martinroger/VXDash/CAD files/Stack rectified.png

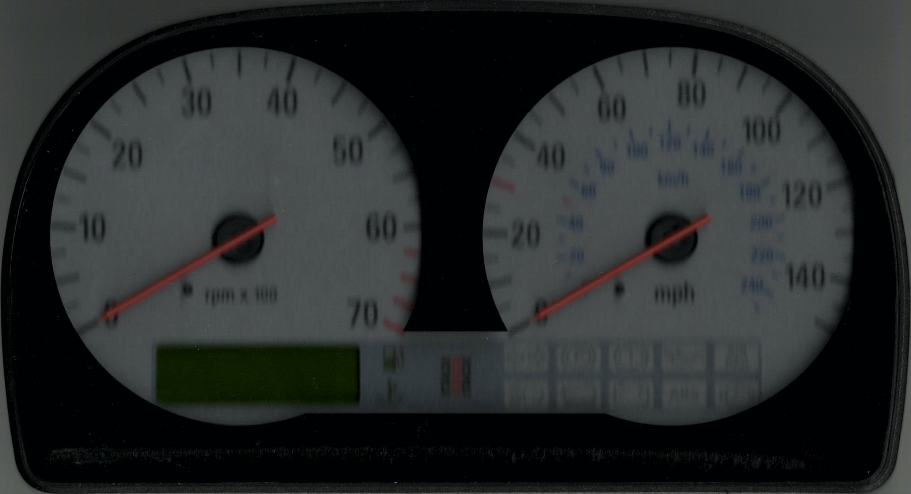
CAD files/Stack rectified.png
