martinroger/VXDash/img/Control assy (1).png

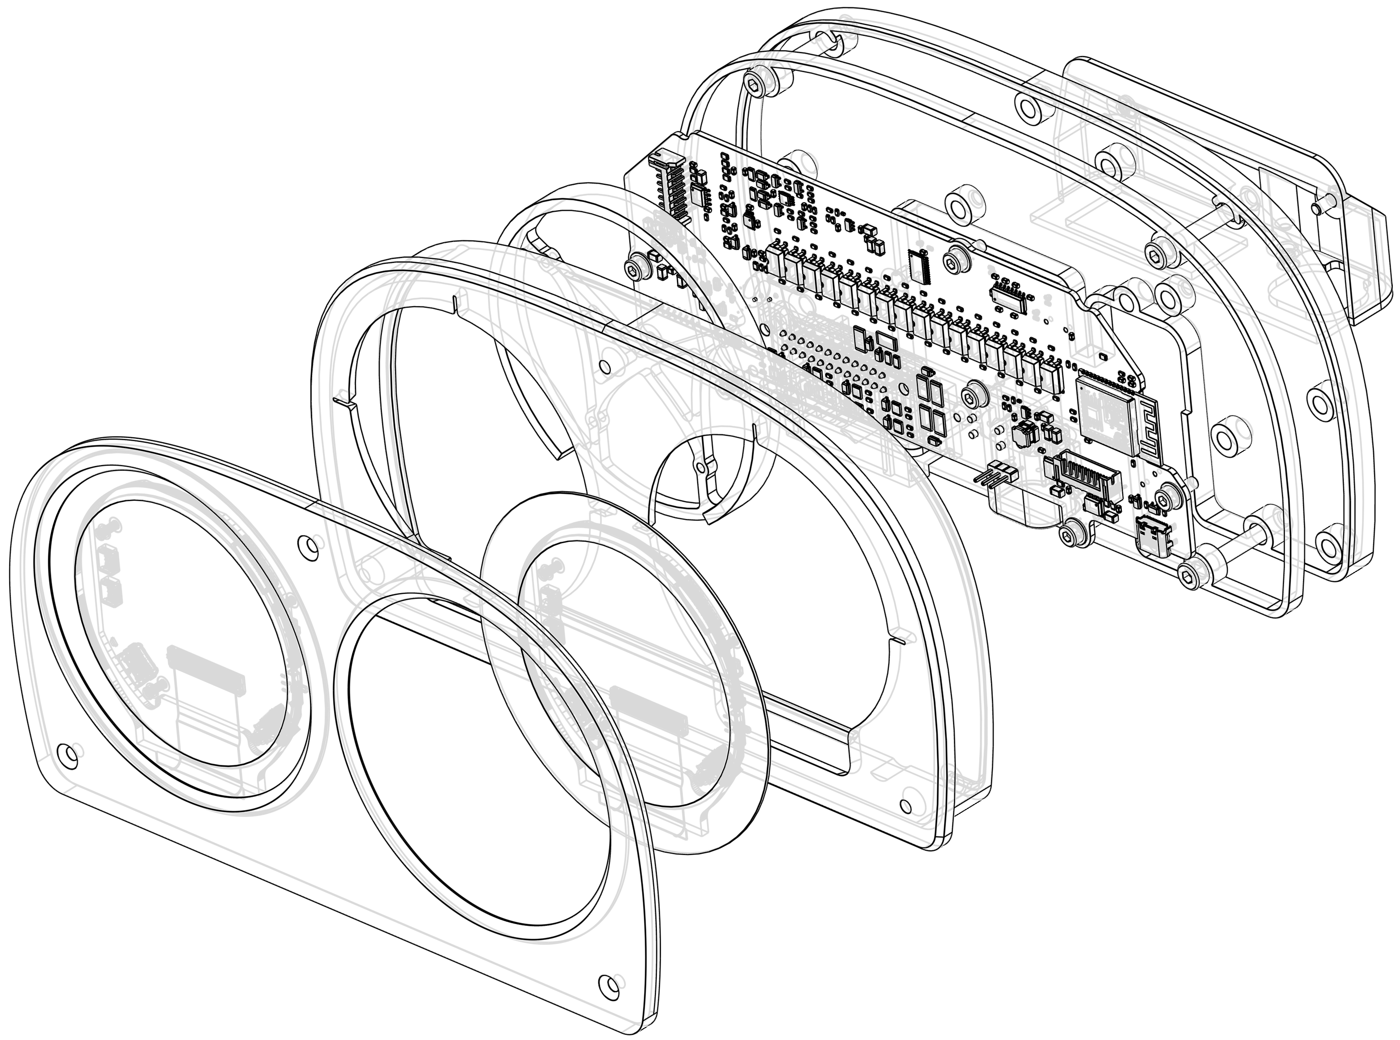
img/Control assy (1).png
