martinroger/VXDash/KiCad PCB Files/Simulations/AnalogR_sensor circuit v2/AS2333.JPG

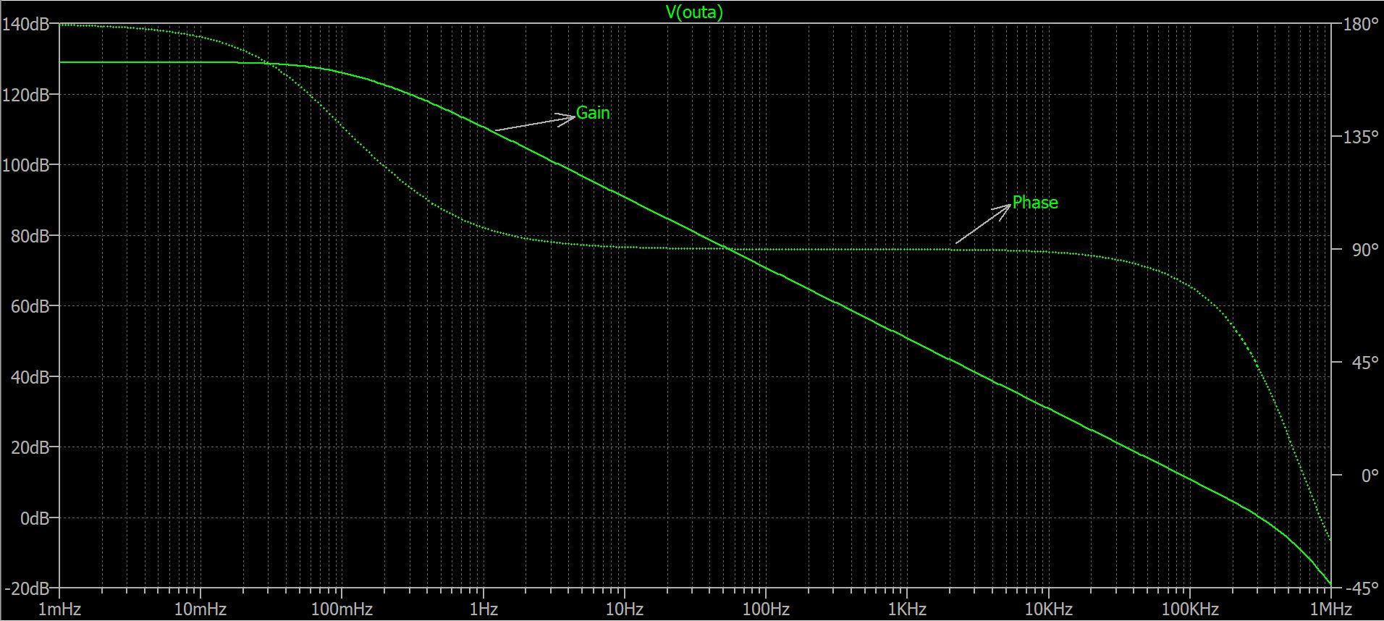
KiCad PCB Files/Simulations/AnalogR_sensor circuit v2/AS2333.JPG
