martinroger/VXDash/KiCad PCB Files/VXDash/VXDash_intermediate.step

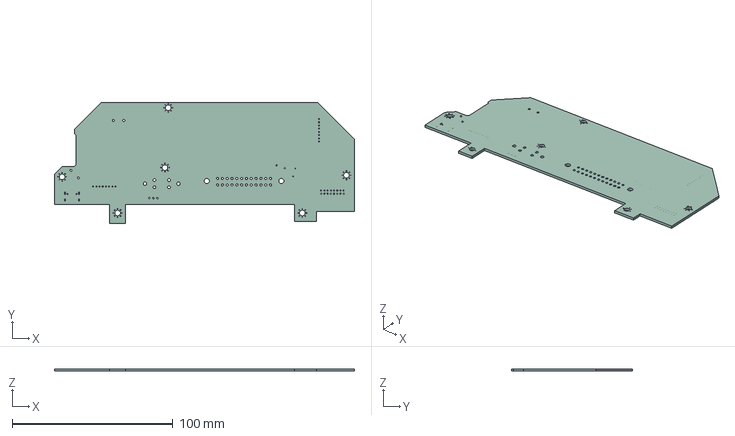
[picture p7: CAD file, 2026-01-08]
KiCad PCB Files/VXDash/VXDash_intermediate.step
186.8 x 75.2 x 1.51 mm
