martinroger/VXDash/KiCad PCB Files/VXDash_Connectors/VXDash_Connectors.step

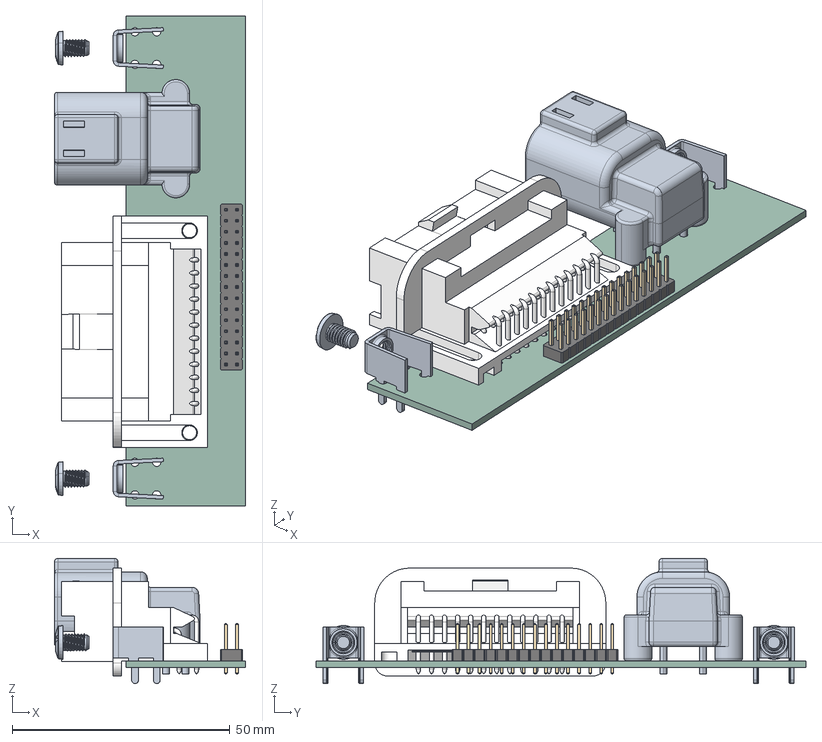
[picture p8: CAD file, 2025-09-24]
KiCad PCB Files/VXDash_Connectors/VXDash_Connectors.step
43.9 x 112.5 x 28.7 mm
PinHeader_2x15_P2.54mm_Vertical
DTF13-4P
12092886_PART1
VXDash_Connectors_PCB
