martinroger/VXDash/KiCad PCB Files/VXDash_Emulator_lite/VXDash_Emulator.step

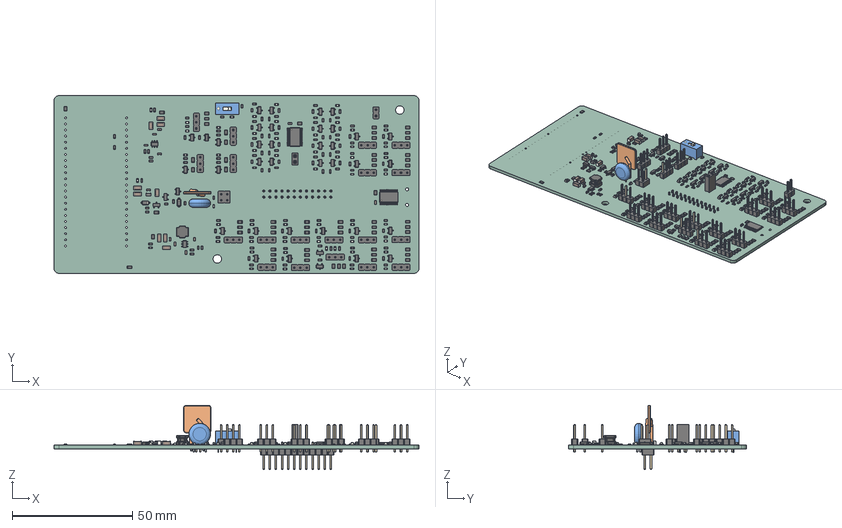
[picture p9: CAD file, 2026-09-08]
KiCad PCB Files/VXDash_Emulator_lite/VXDash_Emulator.step
152.0 x 74.0 x 26.7 mm
R_0603_1608Metric x 123
LED_0603_1608Metric x 56
R_0805_2012Metric x 61
C_1206_3216Metric x 9
SOT-23 x 40
C_0603_1608Metric x 13
PinHeader_1x03_P2.54mm_Vertical x 19
Fuse_BelFuse_0ZRE_0ZRE0033FF_L11.4mm_W3.8mm
TSSOP-24_4.4x7.8mm_P0.65mm x 2
L_0805_2012Metric
PinHeader_2x02_P2.54mm_Vertical
TSOT-23-6 x 2
D_SOD-123 x 2
SW_DIP_SPSTx01_Slide_9.78x4.72mm_W7.62mm_P2.54mm
PinSocket_1x02_P2.54mm_Vertical
RV_Disc_D9mm_W3.5mm_P5mm
PinHeader_1x02_P2.54mm_Vertical
Ind_5050_Pulse_BWVS005050404R7M00
PinHeader_2x12_P2.54mm_Vertical
VXDash_Emulator_PCB
