martinroger/VXDash/KiCad PCB Files/VXDash_MinBuild/Interface board PCB envelope - PCB outline.dxf

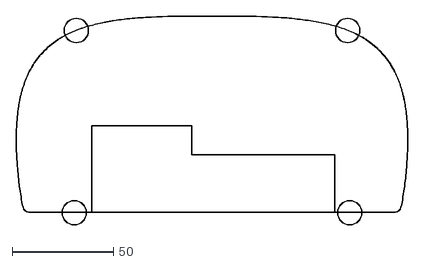
[picture p10: CAD file, 2025-08-14]
KiCad PCB Files/VXDash_MinBuild/Interface board PCB envelope - PCB outline.dxf
193.3 x 103.1
