martinroger/VXDash/CAD files/FDM Enclosure for v0.2.step

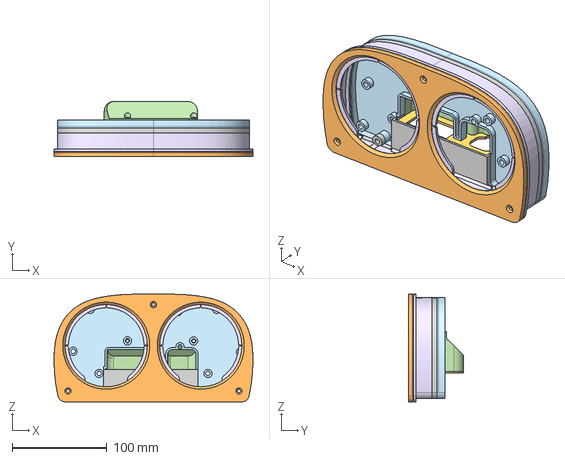
[picture p11: CAD file, 2026-01-11]
CAD files/FDM Enclosure for v0.2.step
210.5 x 58.1 x 114.0 mm
