martinroger/VXDash/CAD files/Original cluster.step

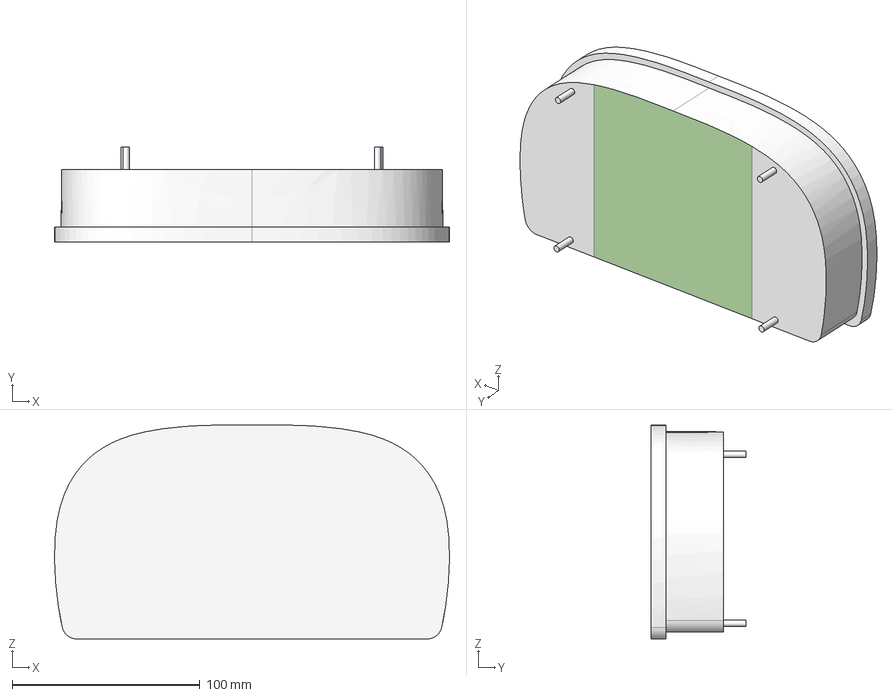
[picture p12: CAD file, 2026-01-08]
CAD files/Original cluster.step
210.5 x 50.5 x 114.0 mm
