martinroger/VXDash/CAD files/Annotated BackFace DXF.dxf

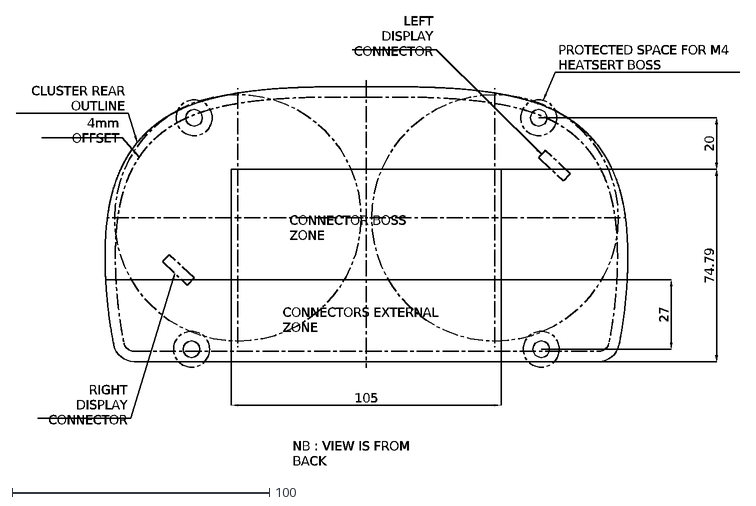
[picture p13: CAD file, 2026-01-08]
CAD files/Annotated BackFace DXF.dxf
CONNECTOR BOSS ZONE
CONNECTORS EXTERNAL ZONE
CLUSTER REAR OUTLINE
4mm OFFSET
PROTECTED SPACE FOR M4 HEATSERT BOSS
27
105
74.79
20
RIGHT DISPLAY CONNECTOR
LEFT DISPLAY CONNECTOR
NB : VIEW IS FROM BACK
