martinroger/VXDash/CAD files/Spider clamp approach - PCB outline.dxf

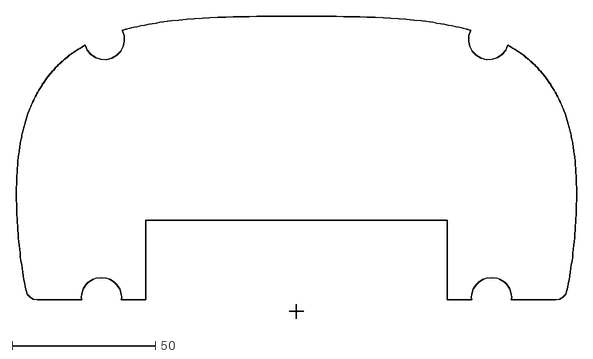
[picture p14: CAD file, 2026-01-08]
CAD files/Spider clamp approach - PCB outline.dxf
195.3 x 105.4
