martinroger/VXDash/CAD files/VXDash_intermediate - Filleted PCB Outline.dxf

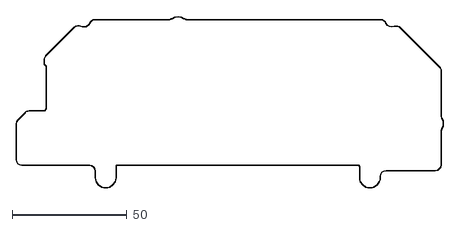
[picture p15: CAD file, 2026-01-08]
CAD files/VXDash_intermediate - Filleted PCB Outline.dxf
186.2 x 74.8
