martinroger/VXDash/CAD files/VXDash_intermediate - New PCB outline.dxf

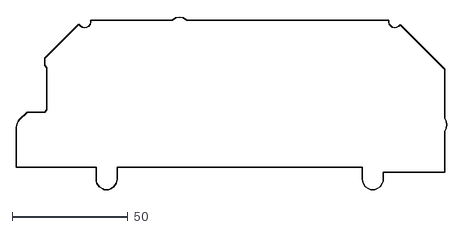
[picture p16: CAD file, 2026-01-08]
CAD files/VXDash_intermediate - New PCB outline.dxf
186.3 x 74.9
