martinroger/VXDash/CAD files/VXDash PCB Area.dxf

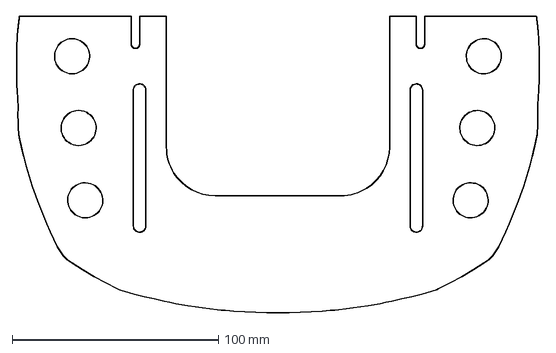
[picture p17: CAD file, 2026-01-08]
CAD files/VXDash PCB Area.dxf
253.6 x 144.0 mm
