martinroger/VXDash/CAD files/VXDash viewable Area.dxf

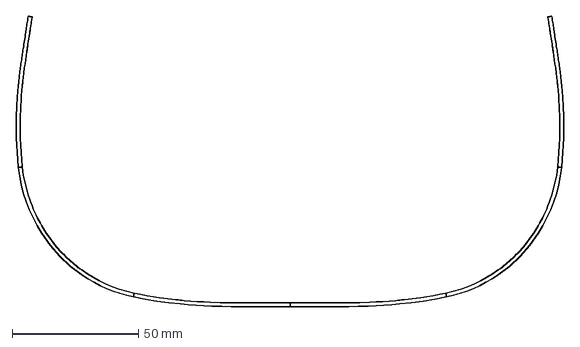
[picture p18: CAD file, 2026-01-08]
CAD files/VXDash viewable Area.dxf
217.3 x 115.3 mm
