martinroger/VXDash/(threads)

Thread 2 (2023-04-17):

Missing 3V3 backfeed protection when flashing ESP32

martinroger, 2023-04-17:

Thread 10 (2023-04-18):

CAD up enclosure

martinroger, 2023-04-18:
- [ ] Variant with minimal impact on existing Cowl (measure lip overlap)
- [ ] Version with modified cowl
- [ ] Check lower edge coverage (approx 10mm)
- [ ] 3D print test block

martinroger, 2025-07-16:
Moving to original fit envelope. Closing.

Thread 6 (2023-04-18):

Check coolant temperature signal characteristics

martinroger, 2023-04-18:
- [x] Is it powered ?
- [x] Is it a 100Hz PWM ?
- [x] Does it have chocolate inside ?

martinroger, 2023-04-24:
Powered at +VBATT but is normally taken down to 5V by the instrument panel.
100Hz PWM, measurement table available in spreadsheet
Chocolate not found

Closed 2023-04-24.

Thread 7 (2023-04-18):

Create test board

martinroger, 2023-04-18:
Has to integrate :

- [x] 4050 buffer circuit
- [x] Multiplexer circuit
- [x] Singled out Coolant temperature test point
- [x] Singled out Fuel level sender test point
- [x] RPM direct connection point
- [x] Speed direct connection point
- [x] 12V -> 5V conversion circuit
- [x] 12V -> 3V3 conversion circuit
- [x] 1 5V detection circuit for 5V sensors
- [x] 1 12V protection circuit
- [x] 1 JAE connector with identical pinout as final

Closed 2023-06-02.

Thread 9 (2023-04-18):

Source SMD soldering tools

martinroger, 2023-04-18:
- [x] ESD tweezers
- [x] Solder paste
- [x] Reflow plate/oven (T962?)
- [x] TS101
- [x] 3D print pasting rig
- [x] Digital magnifier

Closed 2024-10-05.

Thread 13 (2023-04-20):

Find a better way to manage custom parts

martinroger, 2023-04-20:
Currently custom parts and footprints mostly managed through... well they are not managed. Attempts were made to add a submodule but this is a bit too convoluted to maintain new updates. Add a project sub-folder and point Samacsys' Kicad Library app to it.

Any suggestions welcome.

Alex-XNR, 2023-04-20:
I've typically worked with custom libraries in a separate repository. Each user would have their own working branch but would regularly update from/merge into main while checking for conflicts (i.e. not removing or reversing other users work).

Any parts that are added, or any included KiCad parts that need modifying, are copied into this library so that everyone has the same library parts. Also, when KiCad is updated, any included library modifications you've made will likely be removed...

Folder structure something like this:
KiCad Library
   ->3D Models
   ->Symbols
   ->Footprints

martinroger, 2023-04-20:
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

How would you refer the library repository to the main project library in Kicad ? Just configuring it as an additional library in Kicad (as opposed to a Project library) ?
I could/should set that up for sure.

Alex-XNR, 2023-04-21:
Yes exactly right, they would get added as global libraries, then for any future projects you're set up ready to go ;). For example, I have a custom symbol library for passives, transistors, ICs, etc,. But that's only my personal preference

martinroger, 2023-04-21:
> Yes exactly right, they would get added as global libraries, then for any future projects you're set up ready to go ;). For example, I have a custom symbol library for passives, transistors, ICs, etc,. But that's only my personal preference

Right, I'll try and set up that next then !

Closed 2023-04-24.

Thread 16 (2023-04-24):

Relocate Water Temperature information to the 4050 CMOS buffer

martinroger, 2023-04-24:
Turns out it is a 100Hz 12V PWM, so it is simpler to run it through the 4050 CMOS buffer

martinroger, 2023-04-24:
Done as of #15

Closed 2023-04-24.

Thread 17 (2023-04-24):

Remove series capacitors on PS1 input

Alex-XNR, 2023-04-24:
Series capacitors isn't advisable. 2x 22uF 16V on the input should do fine

martinroger, 2023-04-24:
Resolved in #19

Closed 2023-04-24.

Thread 18 (2023-04-24):

Add load disconnect for power input overvoltage

Alex-XNR, 2023-04-24:
For added robustness, it might be worth adding a feature to disconnect the power input circuit if the voltage goes too high.

Thread 22 (2023-04-25):

Improve ground thermal relief and stitching

Alex-XNR, 2023-04-25:
It's advisable to have thermal relief on any pad that connects to a large ground plane. It might cause difficulty when soldering if they are a solid connection.

Include ground vias at regular intervals around the ground plane and at any signal later changes to keep the ground potential as uniform as possible on the PCB.

martinroger, 2023-04-25:
I usually make sure that the PTH pads have thermal reliefs, is that also something that should be done for SMD pads ?

Alex-XNR, 2023-04-25:
I would recommend it. If hand soldering parts you'll need to put in more heat if using solid connections, which will risk damaging components.

martinroger, 2023-04-25:
I was actually thinking of breaking the bank and getting one of those chinese reflow oven or a 200mmx200mm hot plate. Arguably I put some really tiny SMD components (like the chips for the power supply stages). Would thermal reliefs help at all in those cases ?
Just a bit worried on the compromise of good grounding vs thermal reliefs on most large SMD ground pads.

Thread 23 (2023-04-25):

Implement constant current source for Resistive sensor

martinroger, 2023-04-25:
- For sensors in the usual range (0-250Ohm) : max 13.2mA
- For sensors in the mid range (0-500Ohm) : max 6.6mA (use high-K voltage divider and allow 0-5V instead ?)
- For sensors in the high range (0-2K5) : allow 0-5V but imperatively use a 5V -> 3.3V divider with high values for the divider ? Still 2mA max

- Look into high-side current sources possibly based on Op-Amps ?
- Found some stuff on low A LED drivers like NCR401U, worth it or can still be bettered ?

martinroger, 2023-04-30:
Alright, so progressing this a little bit with commit 0abb7f7 :
- I added a hierarchical sheet in the schematics using the LM358BA dual op amp (because it already has Rf and Ri integrated)
- There is a reference 4.096V fed to the op-amp by a LM4040-4.1 "Zener"
- Rsense is set in this implementation to 220Ohm to give a theoretical supply of 4.1mA, which accounting for most of the voltage drops here and there means that the maximum readable sensor resistance Rload of approximately 800Ohm. Practically it may be more but it starts to be really out there in various saturation zones

A concern remains on the quality of the 5V supply, as the "constant" current is almost more dependant on fluctuations on the 5V than anything else.
Also the protection Schottky has to be rethought, because its Vf will remain an unknown (even if at those low amps it might be relatively stable, even against temperature variations ). A 3.3V Zener  to GND instead ?

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

Alex-XNR, 2023-05-23:
Minor changes to the OpAmp design:
- Reference divider added to help with potential 5V supply variation.
- Current set voltage reduced to 100mV to increase measurement headroom.
- MOSFETs used instead of BJT so the base current doesn't influence the constant current.
- Iset resistors moved outside of the hierarchical sheet.

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

Closed 2023-05-23.

Thread 25 (2023-05-16):

Tearing issue on the HMI using large linear gauges

martinroger, 2023-05-16:
At high refresh interval (~60ms) the use of large linear gauges leads to some amount of screen stuttering or tearing. There might be multiple factors at play :
- There are only 100 levels available for linear gauges, so the mapping function may introduce "fake" quantization levels that create a force-refresh even on identical value (on the receiving end of the screen). That may create some stuttering and tearing.
- The HMI stress app may be doing too much of a good job in those cases
- Having "perfect" numerical display of the RPM to the unit RPM is overkill. Steps of 25RPM or even 50-100RPM would reduce the update rate and therefore the panic of the screen
- Same applies for the gauge display of the RPM. 100 different levels (i.e. every 80RPM) is overkill. Steps every 250RPM would be more sensible (32 different levels then), or even every 200 RPM. That can be combined with variable color coding for corner-of-the-eye awareness

martinroger, 2024-11-04:
Drop linear bars from Nextion solution. No amount of tweaking or filtering helps.

Closed 2024-11-04.

Thread 27 (2023-05-16):

First pass of feature roll out in software

martinroger, 2023-05-16:
- [ ] Turn indicator handling
- [x] Telltales logic functions
- [ ] Physical interrupts with debouncing
- [x] Pulse counter
- [x] Use of Timer library instead of hardcoding it
- [x] Pulse emulator SW on the Nano
- [ ] Advise filters for the RPM and SPD counters
- [ ] Advise best quantization technique
- [ ] Interpolation map for complex sensors (separate header files for each)
- [ ] Speed integrator to distance (or long pulse counter ?)
- [ ] Dual core operation

martinroger, 2025-07-16:
Closed. Will get taken care off in the dedicated SW repo.

Closed 2025-07-16.

Thread 31 (2024-04-29):

Constant current LM358 sources are feeding too much current through Rset

martinroger, 2024-04-29:
I'm picking the project back up now that work is easing up a bit, on the Martin-dev branch.

When placing a 270Ohm load on one of the four AnalogR constant source circuits, I observe more current than expected through the load. I checked the circuitry and components position, all seems OK, however I see a larger than expected deltaV between IN1+ and IN1- . If I open-circuit, or nearly so, the Rload, the dV returns to about 100mV as expected.

I'm double-triple-checking the components I bought, soldering and everything, and sharpening up on LTSpice to see if the issue is not somewhere in my understanding of OP Amps and their limits, but @Alex-XNR if you have some insights it would be interesting to me.

Essentially with Rset at 22Ohm today it doesn't really read right above 250Ohm.
[Calibration reference.xlsx](https://github.com/martinroger/VXDash/files/15155680/Calibration.reference.xlsx)
Attached are some measurements. It is fairly uniform across all the 5 similar sensing channels, I haven't yet investigated the one with 51R Rset for higher impedance loads, but I expect a similar behaviour.

martinroger, 2024-04-30:
Tasks :

- [ ] Order AD8542 in MSOP and swap on the benchboard
- [ ] Update Schematic & PCB
- [ ] Change the VGPIO divider for something much larger. At higher Rsense there is a significant amount of current leaking through there (so 51k-27k instead of 5k1 2k7)
- [ ] Redo measurements and implement in code the compensation table

Alex-XNR, 2024-05-01:
Ahh, you are correct about the opamp common mode.
First thing you could try is bring the opamp into CM range. Set Vref on the non-inverting to 2.5V, recalc for the Rset (try 510R at 2.5V ~5mA). Should still be some headroom for upto ~400ohm.
For round two, like you suggest, use a rail-to-rail opamp with full suppy CM range.

martinroger, 2024-05-02:
Yeah, what I will do is probably a resoldering exercise on the bench board directly for the OpAmp, turns out I have gotten quite alright with the hot air gun thing ! In my later commits I added a bunch of LTSpice simulations with the various replacement Op-Amps, I guess in the end I will keep the 5V supply and 4.9V Vref, bulk up the voltage divider from 5V ->3.3V on the GPIO side to minimize stray currents going to ground and run like this. Definitely also looked at setting a larger dV and Rset pair to get the same current but further away from CM, unfortunately I don't have those as 0603 package available to solder right now !

martinroger, 2024-11-04:
Closed by #35

Closed 2024-11-04.

Thread 32 (2024-04-30):

Implement odometer and save to flash

martinroger, 2024-04-30:
Implement odometer function based on speed integration :

- [x] TRIP function
- [x] TRIP RESET via long press of button
- [x] Save to flash and Retrieve from flash (redundant with screen ?)

martinroger, 2024-11-04:
Closed with #35

Closed 2024-11-04.

Thread 33 (2024-10-05):

Possibly inverted P-MOSFET on Power switch stage ?

martinroger, 2024-10-05:
Hey @Alex-XNR , I was checking some things after dusting off the project a bit, and I noticed - just now - that actually the benchboard starts itself regardless of the ignition signal value. I dug up the schematic, and I think I found what is wrong but I might need to double check with you :

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

On there, shouldn't Q2 have D and S reversed ? And R65 and D10 should connect to Power_Fused on the left side ? When I simulate it, it seems to work but I thought I would double check with you before correcting that !

martinroger, 2024-10-06:
Candidate correction in 9ae1b542eb9109c802848487aa74be222306fe4f

Alex-XNR, 2024-10-10:
Hi @martinroger, yes looks like an error 🫣 As you've said, flip drain and source, keep D10 + R65 between G-S.

martinroger, 2024-10-10:
@Alex-XNR Imagine my face when I finally wondered why it was starting without me setting the ignition pin on...

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

Some like this looks OK to you ?

martinroger, 2024-11-04:
Closed by #35

Closed 2024-11-04.

Thread 43 (2025-09-26):

EMULATOR  - Board corrections TODOS

martinroger, 2025-09-26:
### Schematic

- [ ] Revise the values of the resistors for the fuel level sender simulator : on the lower values the drop from N = 1 (270Ohm) to N = 2 (135Ohm) is a bit too steep ? Need to see if this can be mitigated by using the 2k resistors to create intermediate steps (table needed)
- [ ] Ignition is actual source for the active lows on the original cluster. Switching via 2N7002 isn't going to cut it in terms of current throughput -> update to a larger FET or a different architecture
- [ ] BUTTON override is wired to the wrong potential in the schematic. It's an active low but the FET stages are inverting : should be shorting to 3V3, not GND

### PCB (after schematic)

- [ ] Change footprint for development board to the one with the correct headers spacing (i.e. the more popular 25.4mm)
- [ ] Update layout according to schematic changes

martinroger, 2025-09-27:
Update to layout v0.2.0 in commit bbcdaed7052c1aac95e87e0b2f59203bacaf4e26 .

Still need to do the calculation table for the resistors.

martinroger, 2025-09-28:
Calculation table for more resistance steps in the resistance emulator in the 270 - 0 Ohm range :

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

Next step is to implement a level increase/decrease function in https://github.com/martinroger/vx-binocle-espidf
