martinroger/VXDash/KiCad PCB Files/Internal harness.kicad_sch.pdf

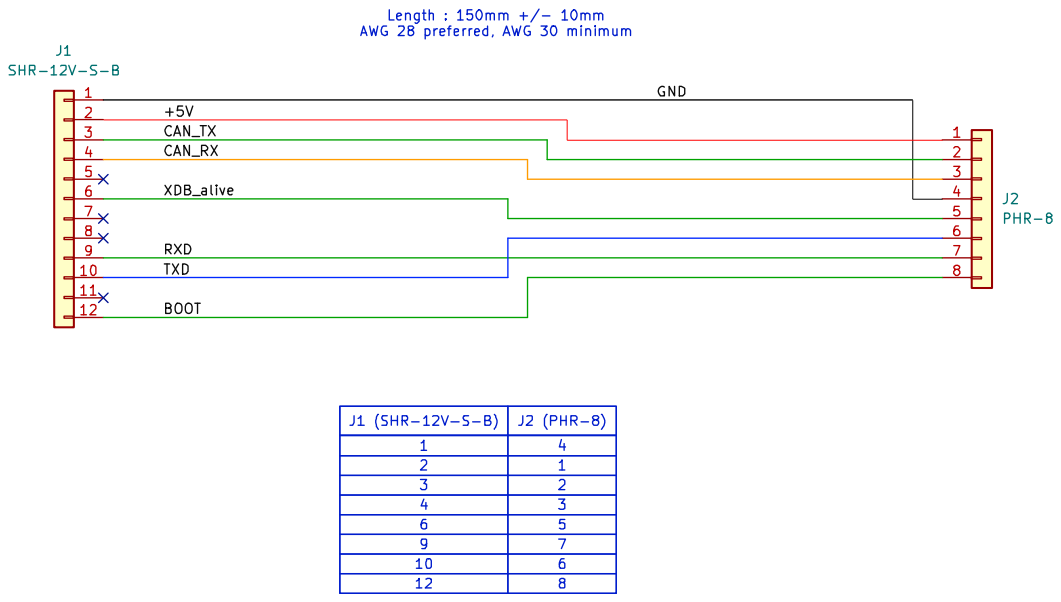
[picture p19: page 1]
