martinroger/VXDash/CAD files/Annotated BackFace DXF.pdf

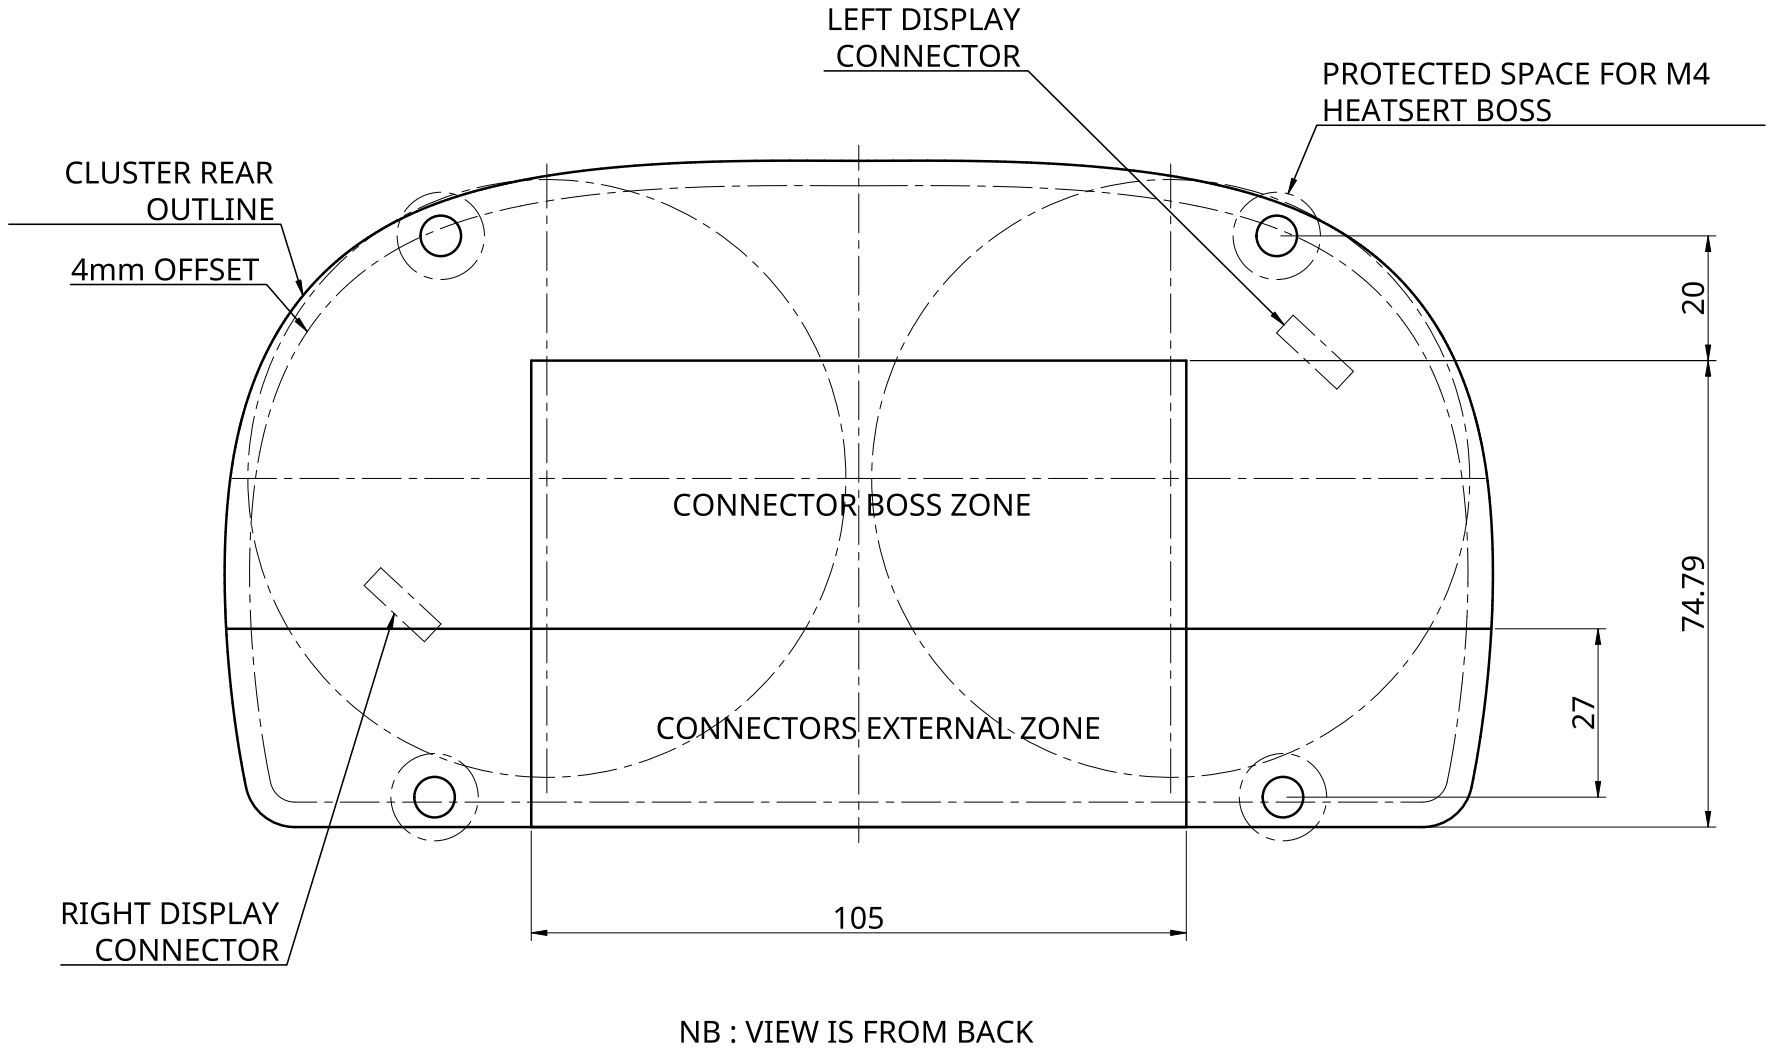
[picture p20: page 1]
