martinroger/VXDash/KiCad PCB Files/Simulations/Battery measure from prot 12V/Battery measure from prot 12V _ ac.asc

C1: cap; 10n; V=50
C2: cap; 100n; V=50V
D1: diode; DI_BZT52C18
R1: res; 100
R2: res; 1Meg
R3: res; 220k
R4: res; 1k
V1: voltage; 13.5; AC 1
Named nets: ADC, Battery, 0
.LIB BZT52C18.spice.txt
.noise V(adc) V1 dec 10 1 1000
.ac oct 10 1 1000
