martinroger/VXDash/KiCad PCB Files/Simulations/Battery measure from prot 12V/Battery measure from prot 12V.asc

C1: cap; 10n; V=50
C2: cap; 100n; V=50V
D1: diode; DI_BZT52C18
R1: res; 100
R2: res; 1Meg
R3: res; 220k
R4: res; 1k
V1: voltage; {Vbatt}
Named nets: ADC, Battery, 0
.LIB BZT52C18.spice.txt
.step param Vbatt 9 36 1
.op
