martinroger/VXDash/KiCad PCB Files/Simulations/Analog V Divider/AnalogVdivider_noise.asc

C1: cap; 100n; V=50
C2: cap; 10n; V=50
D1: schottky; BAT54
R1: res; 10
R2: res; 100k
R3: res; 150k
R4: res; 1k
V1: voltage; ""
V2: voltage; 3.3
Named nets: analog_out, analog_in, 0, 3v3
.ac dec 10 1 10k
.noise V(analog_out) V1 oct 10 1 16k
