martinroger/VXDash/KiCad PCB Files/Simulations/Analog V Divider/AnalogVdivider_op.asc

C1: cap; 100n; V=50
C2: cap; 10n; V=50
D1: schottky; BAT54
R1: res; 10
R2: res; 100k
R3: res; 150k
R4: res; 1k
V1: voltage; {Vin}
V2: voltage; 3.3
Named nets: analog_out, analog_in, 0, 3v3
.step param Vin 250m 6 250m
.op
