martinroger/VXDash/KiCad PCB Files/Simulations/AnalogR_sensor circuit v2/Analog R sensor circuit v2.asc

C1: cap; 100n; V=50
C2: cap; 100n; V=50
C3: cap; 100n; V=50
C4: cap; 33n; V=50
D1: schottky; BAT54
D2: schottky; BAT54
M1: pmos; DMP3099L
M2: pmos; DMP3099L
R1: res; 820k
R2: res; 39k
R3: res; 1k
R5: res; 18
R6: res; 160
R7: res; 6R8
R8: res; 1k
R9: res; 1k
R10: res; {Rsense}
U1: AS2333
V1: voltage; {VsetHigh}
V2: voltage; 3.3
Named nets: 0, Vsupply, VADC, setHigh, Vref, Vsense, D1_A
.LIB DMP3099L.spice.txt
.param VsetHigh=3.3*buf(Rsense/(2*300))
.step param Rsense 15 900 15
.tran 0 5 0.5 0.1
.param Rsense=120
.op
