martinroger/VXDash/KiCad PCB Files/Simulations/AnalogR_sensor circuit v2/AS2333.asc

C1: cap; 1T
C2: cap; 100n
C3: cap; 100n
CL: cap; 100p
L1: ind; 1T
RL: res; 10k
U1: AS2333
V+: voltage; 2.75
V-: voltage; 2.75
Vin: voltage; SINE(0 50m 50k 0); AC 1 0
Named nets: 0, OUTA, +INA, -INA, V+, V-
.ac dec 100 1m 1Meg
Application Notes:
1. AS2333 LTspice macromodel is unencrypted and will only run in LTSPICE XVII and up
2. Testbench is designed to observe Frequency Response of the device.
3. Device is Modeled for Single channel only.
4. Click LTspice ---> Run  to run the simulation. The simulation runs for 1MHz and takes few seconds 
     to run on intel(R) i3 Core, 3.6GHz and 8GB RAM machine.
AS2333 FREQUENCY RESPONSE
.save V(OUTA)
