martinroger/VXDash/KiCad PCB Files/Simulations/Load Emulators/Load emulators.asc

D5: schottky; BAT54
DABS: schottky; BAT54
Daltern: schottky; BAT54
DLTurn: schottky; BAT54
DRTurn: schottky; BAT54
R1: res; 100; tol=1 pwr=2
R2: res; 150; tol=1 pwr=1
R3: res; 15; tol=1 pwr=250m
R4: res; 15; tol=1 pwr=250m
R5: res; 100; tol=1 pwr=2
R6: res; 150; tol=1 pwr=1
R7: res; 100; tol=1 pwr=2
R8: res; 150; tol=1 pwr=1
R9: res; 680; tol=1 pwr=500m
R10: res; 47; tol=1 pwr=100m
R11: res; 15; tol=1 pwr=100m
V1: voltage; {Vbatt}
V2: voltage; {Valtern}
V3: voltage; {Vabs}
V4: voltage; {VLTurn}
V5: voltage; {VRTurn}
V6: voltage; {Vplus}
V7: voltage; {Vminus}
Named nets: Vbatt, altern_act_lo, ABS_act_lo, L_turn_act_hi, R_turn_act_hi, V+, V-, 0
.step param case 1 12 1
.param Vbatt=13
.param Valtern=table(case, 1,Vbatt, 2,0, 3,0, 4,0, 5,0, 6,0, 7,0, 8,0, 9,0, 10,0, 11,0, 12,0) Vabs=table(case, 1,Vbatt, 2,Vbatt, 3,0, 4,0, 5,0, 6,0, 7,0, 8,0, 9,0, 10,0, 11,0, 12,0) VLTurn=table(case, 1,0, 2,0, 3,Vbatt, 4,0, 5,Vbatt, 6,0, 7,0, 8,0, 9,0, 10,0, 11,0, 12,0) VRTurn=table(case, 1,0, 2,0, 3,Vbatt, 4,Vbatt, 5,0, 6,0, 7,0, 8,0, 9,0, 10,0, 11,0, 12,0) Vplus=table(case, 1,0, 2,0, 3,0, 4,0, 5,0, 6,0, 7,Vbatt, 8,0, 9,Vbatt, 10,0, 11,0, 12,0) Vminus=table(case, 1,0, 2,0, 3,0, 4,0, 5,0, 6,0, 7,Vbatt, 8,Vbatt, 9,0, 10,0, 11,0, 12,0)
.op
