martinroger/VXDash/KiCad PCB Files/Simulations/Opto Act_X/Opto ACT X.asc

3V#: voltage; 3.3
R1: res; 10k
R2: res; 8k2
R3: res; 10k
R4: res; 8k2
U1: PC817B
U2: PC817B
Vbatt: voltage; {Vbatt}
Vhl: voltage; {VHL}
V~hl: voltage; {VHL}
Named nets: 0, 3v3, prot_12v, act_lo_output, ~HL_Input, act_hi_output, HL_Input, prot_12V
Opto Act Lo
Opto Act Hi
.step param VHL 0 14.5 0.1
.op
.param Vbatt=14
