martinroger/VXDash/KiCad PCB Files/Simulations/Power input stage v2/PowerInputStage.asc

A1: varistor; Rclamp=1n
C1: cap; 100n; V=50V
C2: cap; 100n; V=50
C3: cap; 10µ; V=25
C4: cap; 10µ; V=25v
C5: cap; 10µ; V=25v
C6: cap; 100n; V=50v
D1: LED; AOT-2015
D2: diode; DI_BZT52C18
D3: diode; DI_BZT52C18
Fuse: res; 45m
L1: FerriteBead; 377n; Ipk=3 Rser=0.027 Rpar=177 Cpar=847f
M1: pmos; PJA3441-AU
M2: pmos; PJA3441-AU
M3: nmos; 2N7002
M4: pmos; PJA3441-AU
R1: res; 3k
R2: res; 100k
R3: res; 10k
R4: res; 10k
R5: res; 30k
Req: res; 50
V1: voltage; 22
Vbatt: voltage; ""
Vignition: voltage; 13
Named nets: power_in, 0, power_mid, ignition, power_switched, power_pre_filter
.LIB PJA3441-AU.txt
.LIB BZT52C18.spice.txt
.dc Vbatt -30 30 1
