martinroger/VXDash/KiCad PCB Files/Simulations/Power input stage v2/PowerInputStage_ac.asc

A1: varistor; Rclamp=1n
C1: cap; 100n; V=50V
C2: cap; 100n; V=50
C3: cap; 10µ; V=25
C4: cap; 10µ; V=25v
C5: cap; 10µ; V=25v
C6: cap; 100n; V=50v
D1: LED; AOT-2015
D2: diode; DI_BZT52C18
D3: diode; DI_BZT52C18
Fuse: res; 45m
L1: FerriteBead; 377n; Ipk=3 Rser=0.027 Rpar=177 Cpar=847f mfg="Würth Elektronik" pn="742792023 WE-CBF 0805"
M1: pmos; PJA3441-AU
M2: pmos; PJA3441-AU
M3: nmos; 2N7002
R1: res; 3k
R2: res; 100k
R3: res; 10k
R4: res; 10k
R5: res; 30k
V1: voltage; 22
Vbatt: voltage; 14.2; AC 0.2
Vignition: voltage; {Vignition}
Named nets: power_in, 0, power_mid, ignition, power_switched, power_pre_filter
.LIB PJA3441-AU.txt
.LIB BZT52C18.spice.txt
.step param Vignition 0 14.2 14.2
.param Vignition=14
.ac dec 20 1 1Meg
