martinroger/VXDash/KiCad PCB Files/Simulations/AnalogR_sensor circuits/Switchable Rset - 3V3 rail/Switchable Rset.asc

D1: schottky; PMEG3010BEA
M1: pmos; BSS84
M3: pmos; BSS84
R2: res; 10k; tol=1
R3: res; 330k; tol=1
R11: res; 100k
Rsensor: res; {Rsense}; tol=1
RsetHighR: res; 91; tol=1
RsetLowR: res; 3.9; tol=1
U1: AD8542
V1: voltage; 3.3; Rser=10m
VcaliberSelect: voltage; 0; Rser=10m
Named nets: Vdd, 0, Vref, Vset, Vsensor, Vadc
.step param Rsense 1 1001 10
.op
