martinroger/VXDash/KiCad PCB Files/VXDash/VXDash.kicad_pcb

## KiCad design KiCad PCB Files/VXDash/VXDash.kicad_pcb (continued)

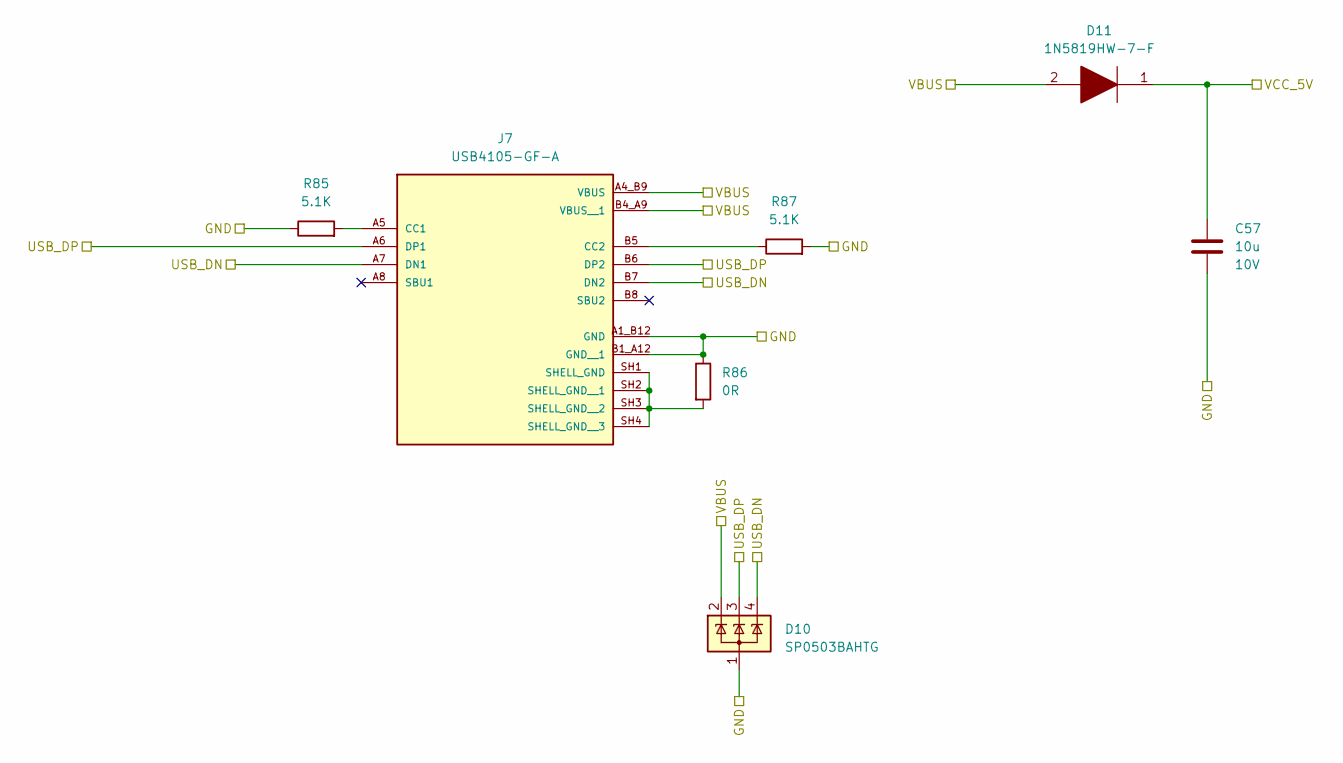
[picture p66: schematic USBC.kicad_sch, A1S Mini Board]

Parts:
C57: 10u; C_0603_1608Metric_Pad1.08x0.95mm_HandSolder; Voltage 10V; LCSC C19702
D10: SP0503BAHTG; SOT-143; LCSC C7074
D11: 1N5819HW-7-F; D_SOD-123; LCSC C82544
J7: USB4105-GF-A; GCT_USB4105-GF-A; LCSC C3020560
R85, R87: 5.1K; R_0603_1608Metric_Pad0.98x0.95mm_HandSolder; LCSC C105580
R86: 0R; R_0603_1608Metric_Pad0.98x0.95mm_HandSolder; LCSC C21189

Connections:
/USBC/VBUS: D10.2 (K), D11.2, J7.A4_B9 (VBUS), J7.B4_A9 (VBUS__1); also elsewhere on the board
/USBC/VCC_5V: C57.2, D11.1; also elsewhere on the board
/USB_DN: D10.4 (K), J7.A7 (DN1), J7.B7 (DN2); also elsewhere on the board
/USB_DP: D10.3 (K), J7.A6 (DP1), J7.B6 (DP2); also elsewhere on the board
GND: C57.1, D10.1 (A), J7.A1_B12 (GND), J7.B1_A12 (GND__1), R85.1, R86.1, R87.2; also elsewhere on the board
unnamed: J7.A5 (CC1), R85.2
unnamed: J7.B5 (CC2), R87.1
unnamed: J7.SH1 (SHELL_GND), J7.SH2 (SHELL_GND__1), J7.SH3 (SHELL_GND__2), J7.SH4 (SHELL_GND__3), R86.2

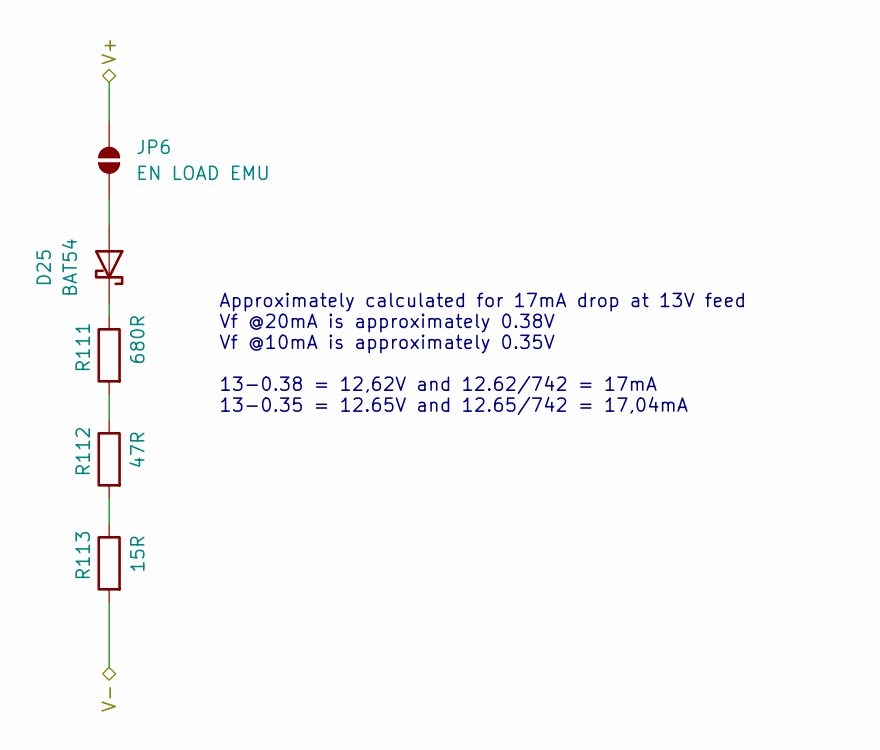
[picture p67: schematic Telltale load emulation.kicad_sch, Telltale Load Emulator 17mA]

Parts:
D25: BAT54; D_SOD-123; LCSC C152458
JP6: EN LOAD EMU; SolderJumper-2_P1.3mm_Open_RoundedPad1.0x1.5mm
R111: 680R; R_1210_3225Metric_Pad1.30x2.65mm_HandSolder; LCSC C163351
R112: 47R; R_0603_1608Metric_Pad0.98x0.95mm_HandSolder; LCSC C114623
R113: 15R; R_0603_1608Metric_Pad0.98x0.95mm_HandSolder; LCSC C128059

Connections:
AIRBAG_ActLO: R113.2; also elsewhere on the board
unnamed: D25.2 (A), JP6.1 (A)
unnamed: D25.1 (K), R111.1
unnamed: R111.2, R112.1
unnamed: R112.2, R113.1
Protected_12V: JP6.2 (B); also elsewhere on the board

Notes on the sheet:
Approximately calculated for 17mA drop at 13V feed Vf @20mA is approximately 0.38V Vf @10mA is approximately 0.35V 13-0.38 = 12,62V and 12.62/742 = 17mA 13-0.35 = 12.65V and 12.65/742 = 17,04mA

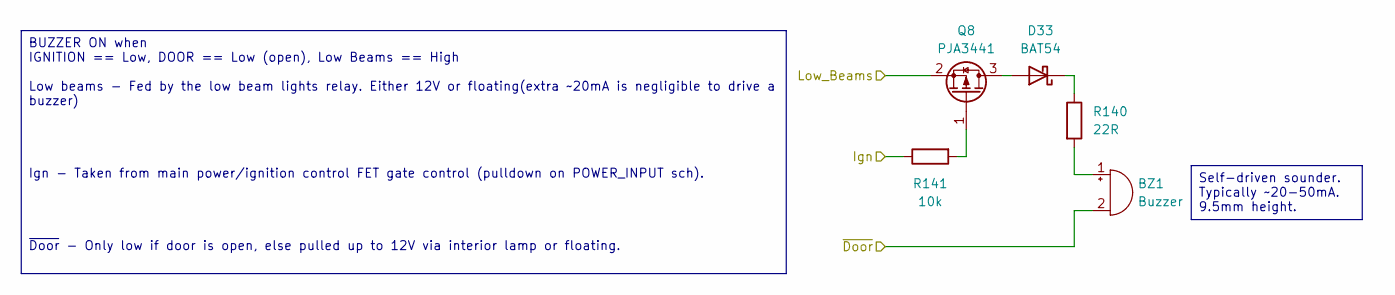
[picture p68: schematic Buzzer.kicad_sch]

Parts:
BZ1: Buzzer; Buzzer_12x9.5RM7.6; LCSC C49246932
D33: BAT54; D_SOD-123; LCSC C152458
Q8: PJA3441; SOT-23; LCSC C313504
R140: 22R; R_0805_2012Metric; LCSC C107702
R141: 10k; R_0603_1608Metric_Pad0.98x0.95mm_HandSolder; LCSC C98220

Connections:
DOOR_ActLO: BZ1.2 (-); also elsewhere on the board
IGNITION_ActHI: R141.1; also elsewhere on the board
L_BEAM_ActHI: Q8.2 (S); also elsewhere on the board
unnamed: BZ1.1 (+), R140.2
unnamed: D33.2 (A), Q8.3 (D)
unnamed: D33.1 (K), R140.1
unnamed: Q8.1 (G), R141.2

Notes on the sheet:
BUZZER ON when IGNITION == Low, DOOR == Low (open), Low Beams == High Low beams - Fed by the low beam lights relay. Either 12V or floating(extra ~20mA is negligible to drive a buzzer) Ign - Taken from main power/ignition control FET gate control (pulldown on POWER_INPUT sch). ~{Door} - Only low if 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
Self-driven sounder. Typically ~20-50mA. 9.5mm height.

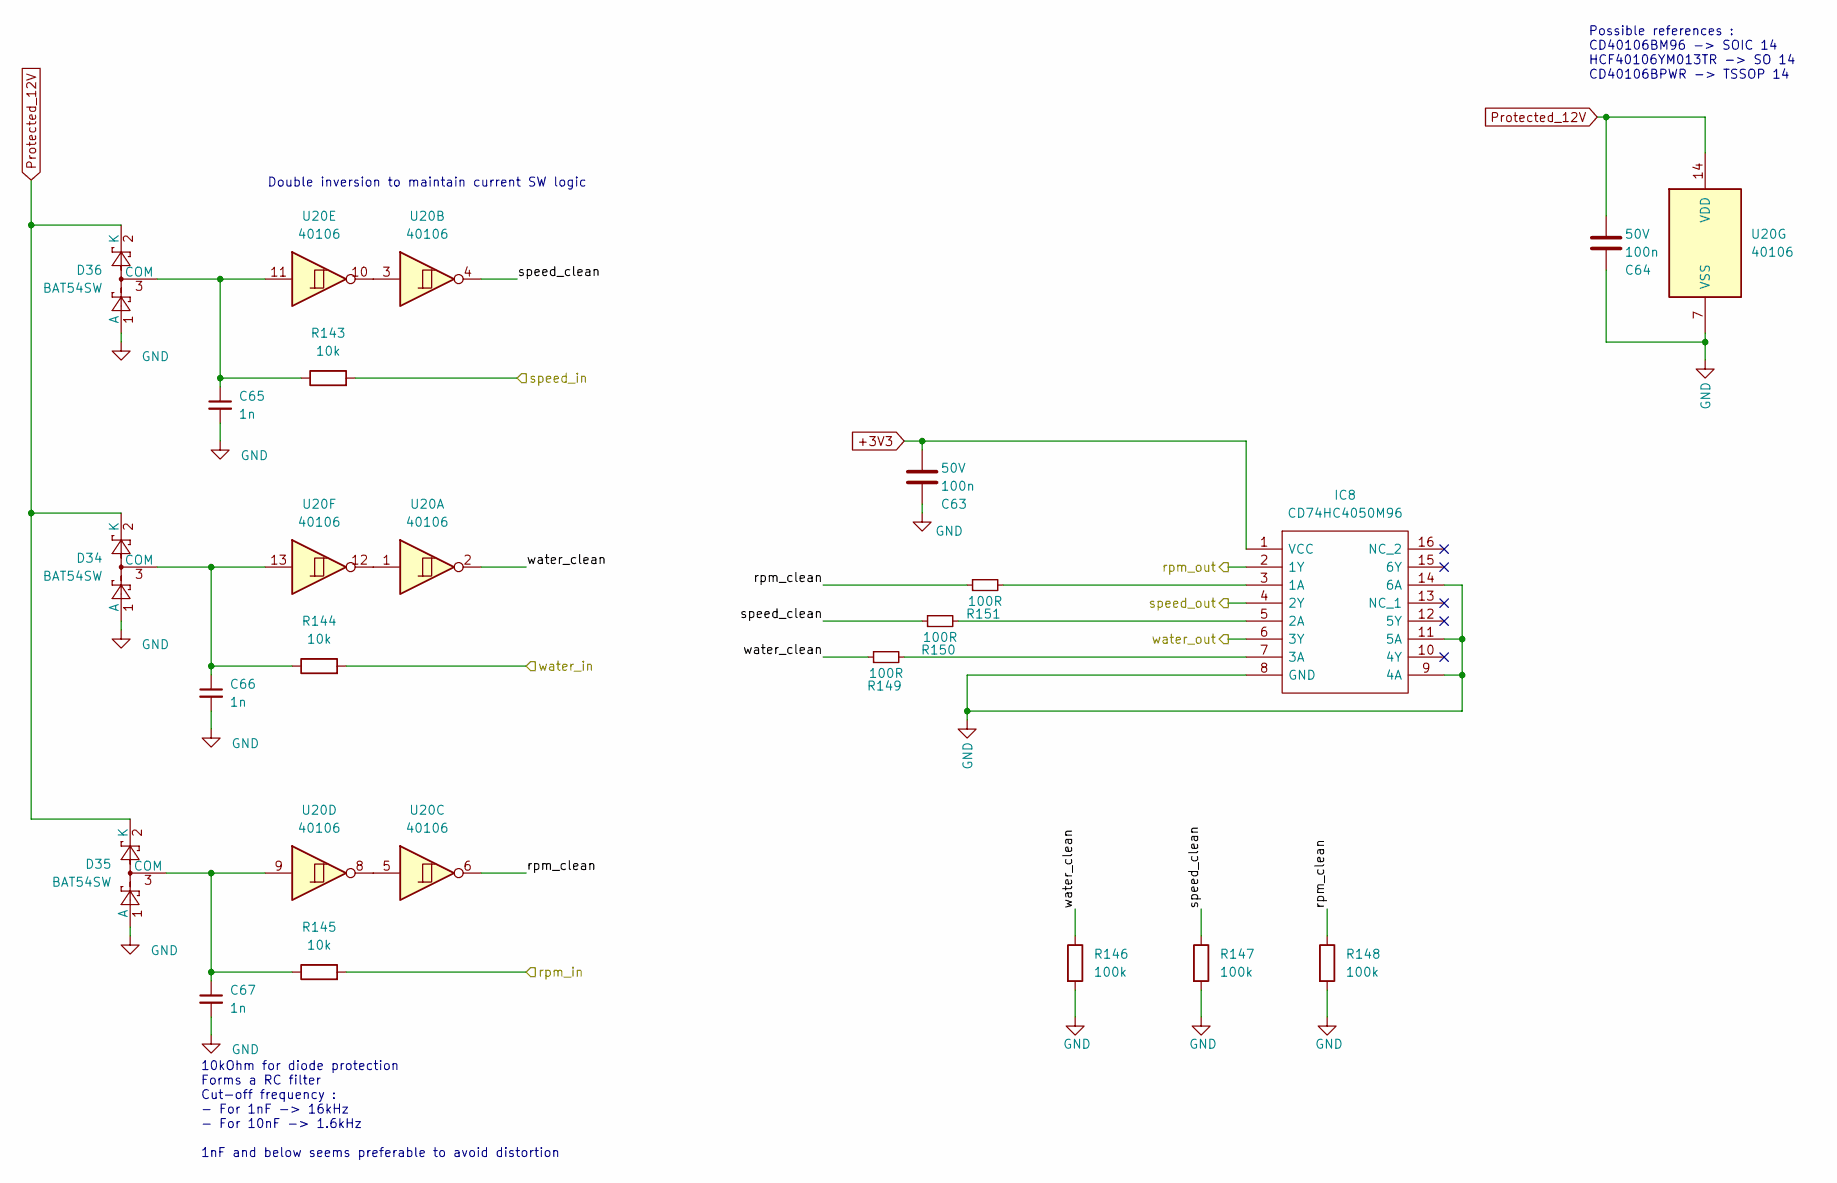
[picture p69: schematic pulsed_sig_proc.kicad_sch, PWM signal cleaning and processing]

Parts:
C63, C64: 100n; C_0603_1608Metric_Pad1.08x0.95mm_HandSolder; Voltage 50V; LCSC C16194176
C65, C66, C67: 1n; C_0603_1608Metric_Pad1.08x0.95mm_HandSolder; Voltage 50V; LCSC C100040
D34, D35, D36: BAT54SW; SOT-323_SC-70; LCSC C78606
IC8: CD74HC4050M96; SOIC-16_3.9x9.9mm_P1.27mm; LCSC C131932
R143, R144, R145: 10k; R_0603_1608Metric_Pad0.98x0.95mm_HandSolder; LCSC C98220
R146, R147, R148: 100k; R_0603_1608Metric_Pad0.98x0.95mm_HandSolder; LCSC C14675
R149, R150, R151: 100R; R_0603_1608Metric_Pad0.98x0.95mm_HandSolder; LCSC C2906981
U20: 40106; SO-14_3.9x8.65mm_P1.27mm; LCSC C443841

Connections:
+3V3: C63.1, IC8.1 (VCC); also elsewhere on the board
/Pulsed signals processing/rpm_clean: R148.1, R151.1, U20.6
/Pulsed signals processing/speed_clean: R147.1, R150.1, U20.4
/Pulsed signals processing/water_clean: R146.1, R149.1, U20.2
/rpm: IC8.2 (1Y); also elsewhere on the board
/speed: IC8.4 (2Y); also elsewhere on the board
/water_T: IC8.6 (3Y); also elsewhere on the board
GND: C63.2, C64.2, C65.2, C66.2, C67.2, D34.1 (A), D35.1 (A), D36.1 (A), IC8.8 (GND), IC8.9 (4A), IC8.11 (5A), IC8.14 (6A), R146.2, R147.2, R148.2, U20.7 (VSS); also elsewhere on the board
unnamed: C66.1, D34.3 (COM), R144.1, U20.13
unnamed: C67.1, D35.3 (COM), R145.1, U20.9
unnamed: C65.1, D36.3 (COM), R143.1, U20.11
unnamed: IC8.3 (1A), R151.2
unnamed: IC8.5 (2A), R150.2
unnamed: IC8.7 (3A), R149.2
unnamed: U20.1, U20.12
unnamed: U20.5, U20.8
unnamed: U20.3, U20.10
Protected_12V: C64.1, D34.2 (K), D35.2 (K), D36.2 (K), U20.14 (VDD); also elsewhere on the board
RPM_HALL: R145.2; also elsewhere on the board
SPEED_HALL: R143.2; also elsewhere on the board
WATER_T_PWM: R144.2; also elsewhere on the board

Notes on the sheet:
10kOhm for diode protection Forms a RC filter Cut-off frequency : - For 1nF -> 16kHz - For 10nF -> 1.6kHz 1nF and below seems preferable to avoid distortion
Possible references : CD40106BM96 -> SOIC 14 HCF40106YM013TR -> SO 14 CD40106BPWR -> TSSOP 14
Double inversion to maintain current SW logic

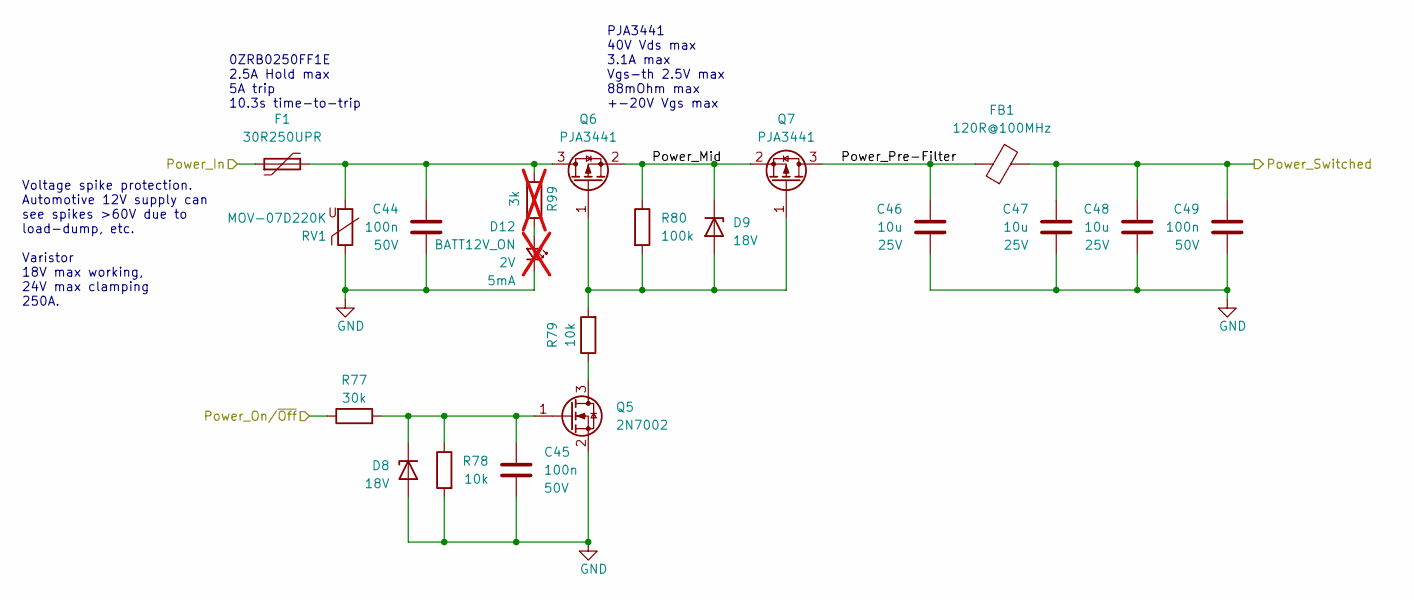
[picture p70: schematic Power_Input.kicad_sch, Ignition and power protection]

Parts:
C44, C45, C49: 100n; C_0603_1608Metric_Pad1.08x0.95mm_HandSolder; Voltage 50V; LCSC C16194176
C46, C47, C48: 10u; C_1206_3216Metric_Pad1.33x1.80mm_HandSolder; Voltage 25V; LCSC C14860
D8, D9: 18V; D_SOD-123; LCSC C668896
D12: BATT12V_ON; LED_0603_1608Metric_Pad1.05x0.95mm_HandSolder; LCSC C157740; not fitted
F1: 30R250UPR; Fuse_BelFuse_0ZRE0033FF_L11.4mm_W3.8mm; LCSC C207101
FB1: 120R@100MHz; L_0805_2012Metric; LCSC N/A
Q5: 2N7002; SOT-23; LCSC C78712
Q6, Q7: PJA3441; SOT-23; LCSC C313504
R77: 30k; R_0805_2012Metric_Pad1.20x1.40mm_HandSolder; LCSC C126352
R78, R79: 10k; R_0603_1608Metric_Pad0.98x0.95mm_HandSolder; LCSC C98220
R80: 100k; R_0603_1608Metric_Pad0.98x0.95mm_HandSolder; LCSC C14675
R99: 3k; R_0603_1608Metric_Pad0.98x0.95mm_HandSolder; LCSC C126358; not fitted
RV1: MOV-07D220K; RV_Disc_D9mm_W3.5mm_P5mm; LCSC C1528486

Connections:
/POWER INPUT/Power_Mid: D9.1 (K), Q6.2 (S), Q7.2 (S), R80.1
/POWER INPUT/Power_Pre-Filter: C46.2, FB1.1, Q7.3 (D)
BATT12V+: F1.1; also elsewhere on the board
GND: C44.1, C45.1, C46.1, C47.1, C48.1, C49.1, D8.2 (A), D12.1 (K), Q5.2 (S), R78.2, RV1.1; also elsewhere on the board
IGNITION_ActHI: R77.1; also elsewhere on the board
unnamed: C45.2, D8.1 (K), Q5.1 (G), R77.2, R78.1
unnamed: D9.2 (A), Q6.1 (G), Q7.1 (G), R79.2, R80.2
unnamed: D12.2 (A), R99.2
unnamed: Q5.3 (D), R79.1
unnamed: C44.2, F1.2, Q6.3 (D), RV1.2
Protected_12V: C47.2, C48.2, C49.2, FB1.2; also elsewhere on the board

Notes on the sheet:
PJA3441 40V Vds max 3.1A max Vgs-th 2.5V max 88mOhm max +-20V Vgs max
Voltage spike protection. Automotive 12V supply can see spikes >60V due to load-dump, etc. Varistor 18V max working, 24V max clamping 250A.
0ZRB0250FF1E 2.5A Hold max 5A trip 10.3s time-to-trip

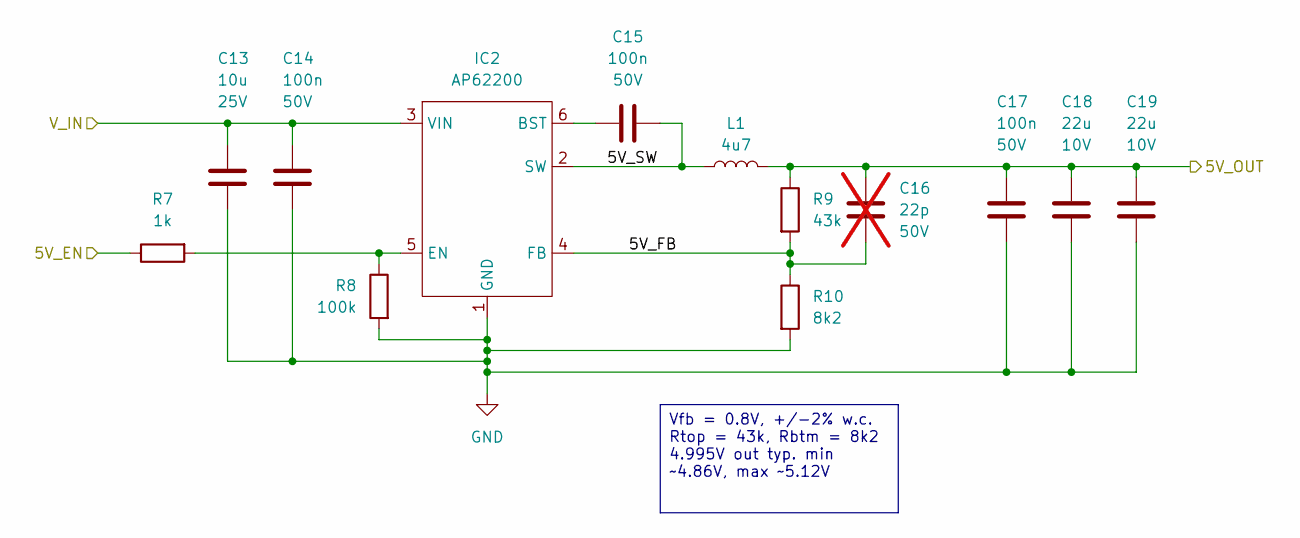
[picture p71: schematic 5V_SMPS.kicad_sch, 5V SMPS]

Parts:
C13: 10u; C_1206_3216Metric_Pad1.33x1.80mm_HandSolder; Voltage 25V; LCSC C14860
C14, C15, C17: 100n; C_0603_1608Metric_Pad1.08x0.95mm_HandSolder; Voltage 50V; LCSC C16194176
C16: 22p; C_0402_1005Metric_Pad0.74x0.62mm_HandSolder; Voltage 50V; LCSC C1882706; not fitted
C18, C19: 22u; C_1206_3216Metric_Pad1.33x1.80mm_HandSolder; Voltage 10V; LCSC C87996
IC2: AP62200; TSOT-23-6_HandSoldering; LCSC C1323282
L1: 4u7; Ind_5050; LCSC C2838218
R7: 1k; R_0603_1608Metric_Pad0.98x0.95mm_HandSolder; LCSC C22548
R8: 100k; R_0603_1608Metric_Pad0.98x0.95mm_HandSolder; LCSC C14675
R9: 43k; R_0603_1608Metric_Pad0.98x0.95mm_HandSolder; LCSC C137719
R10: 8k2; R_0603_1608Metric_Pad0.98x0.95mm_HandSolder; LCSC C114637

Connections:
+5V: C16.1, C17.2, C18.1, C19.1, L1.2, R9.1; also elsewhere on the board
/5V_SMPS/5V_FB: C16.2, IC2.4 (FB), R9.2, R10.1
/5V_SMPS/5V_SW: C15.1, IC2.2 (SW), L1.1
/5V_enable: R7.1; also elsewhere on the board
GND: C13.1, C14.1, C17.1, C18.2, C19.2, IC2.1 (GND), R8.2, R10.2; also elsewhere on the board
unnamed: C15.2, IC2.6 (BST)
unnamed: IC2.5 (EN), R7.2, R8.1
Protected_12V: C13.2, C14.2, IC2.3 (VIN); also elsewhere on the board

Parts of its further copies:
C2: 10u; C_1206_3216Metric_Pad1.33x1.80mm_HandSolder; Voltage 25V; LCSC C14860
C3, C4, C6: 100n; C_0603_1608Metric_Pad1.08x0.95mm_HandSolder; Voltage 50V; LCSC C16194176
C5: 22p; C_0402_1005Metric_Pad0.74x0.62mm_HandSolder; Voltage 50V; LCSC C1882706; not fitted
C51, C52: 22u; C_1206_3216Metric_Pad1.33x1.80mm_HandSolder; Voltage 10V; LCSC C87996
IC5: AP62200; TSOT-23-6_HandSoldering; LCSC C1323282
L3: 4u7; Ind_5050; LCSC C2838218
R81: 1k; R_0603_1608Metric_Pad0.98x0.95mm_HandSolder; LCSC C22548
R82: 100k; R_0603_1608Metric_Pad0.98x0.95mm_HandSolder; LCSC C14675
R83: 43k; R_0603_1608Metric_Pad0.98x0.95mm_HandSolder; LCSC C137719
R84: 8k2; R_0603_1608Metric_Pad0.98x0.95mm_HandSolder; LCSC C114637

Connections of its further copies:
+5V_AUX: C5.1, C6.2, C51.1, C52.1, L3.2, R83.1; also elsewhere on the board
/5V_SMPS_AUX/5V_FB: C5.2, IC5.4 (FB), R83.2, R84.1
/5V_SMPS_AUX/5V_SW: C4.1, IC5.2 (SW), L3.1
/5V_aux_enable: R81.1; also elsewhere on the board
GND: C2.1, C3.1, C6.1, C51.2, C52.2, IC5.1 (GND), R82.2, R84.2; also elsewhere on the board
unnamed: C4.2, IC5.6 (BST)
unnamed: IC5.5 (EN), R81.2, R82.1
Protected_12V: C2.2, C3.2, IC5.3 (VIN); also elsewhere on the board

Notes on the sheet:
Vfb = 0.8V, +/-2% w.c. Rtop = 43k, Rbtm = 8k2 4.995V out typ. min ~4.86V, max ~5.12V

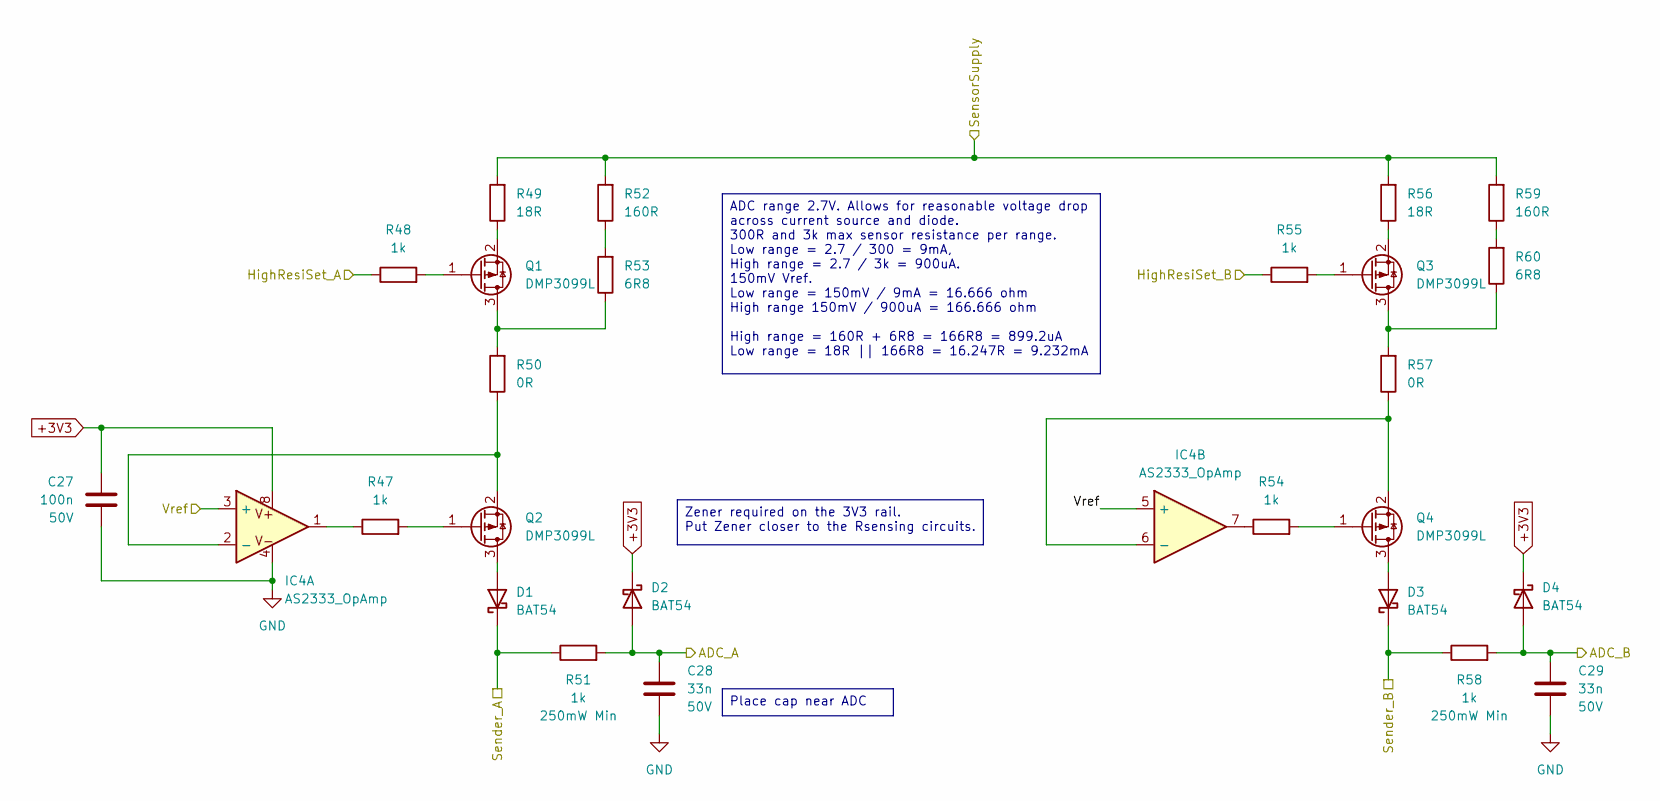
[picture p72: schematic Rsensing_Pair.kicad_sch, Rsensing subcircuit]

Parts:
C27: 100n; C_0603_1608Metric_Pad1.08x0.95mm_HandSolder; Voltage 50V; LCSC C16194176
C28, C29: 33n; C_0603_1608Metric_Pad1.08x0.95mm_HandSolder; Voltage 50V; LCSC C106856
D1, D2, D3, D4: BAT54; D_SOD-123; LCSC C152458
IC4: AS2333_OpAmp; MSOP-8_3x3mm_P0.65mm; LCSC C5948553
Q1, Q2, Q3, Q4: DMP3099L; SOT-23; LCSC C155244
R47, R48, R54, R55: 1k; R_0603_1608Metric_Pad0.98x0.95mm_HandSolder; LCSC C22548
R49, R56: 18R; R_0603_1608Metric_Pad0.98x0.95mm_HandSolder; LCSC C245924
R50, R57: 0R; R_0603_1608Metric_Pad0.98x0.95mm_HandSolder; LCSC C21189
R51, R58: 1k; R_1206_3216Metric_Pad1.30x1.75mm_HandSolder; LCSC C131398
R52, R59: 160R; R_0603_1608Metric_Pad0.98x0.95mm_HandSolder; LCSC C185369
R53, R60: 6R8; R_0603_1608Metric_Pad0.98x0.95mm_HandSolder; LCSC C23214

Connections:
+3V3: C27.2, D2.1 (K), D4.1 (K), IC4.8, R49.2, R52.2, R56.2, R59.2; also elsewhere on the board
/ANALOGUE/Rsensing_Pair1/ADC_B: C29.2, D4.2 (A), R58.2
/ANALOGUE/Rsensing_Pair1/HighResiSet_B: R55.1
/ANALOGUE/Rsensing_Pair1/Sender_B: D3.1 (K), R58.1
/ANALOGUE/r_adc_1: C28.2, D2.2 (A), R51.2; also elsewhere on the board
/ANALOGUE/v_ref: IC4.3 (+), IC4.5 (+); also elsewhere on the board
/Set_Hi_Chan_A: R48.1; also elsewhere on the board
FUEL_LVL_Rsense: D1.1 (K), R51.1; also elsewhere on the board
GND: C27.1, C28.1, C29.1, IC4.4; also elsewhere on the board
unnamed: D1.2 (A), Q2.3 (D)
unnamed: D3.2 (A), Q4.3 (D)
unnamed: IC4.1, R47.1
unnamed: IC4.7, R54.1
unnamed: IC4.2 (-), Q2.2 (S), R50.1
unnamed: IC4.6 (-), Q4.2 (S), R57.1
unnamed: Q1.3 (D), R50.2, R53.1
unnamed: Q1.1 (G), R48.2
unnamed: Q1.2 (S), R49.1
unnamed: Q2.1 (G), R47.2
unnamed: Q3.3 (D), R57.2, R60.1
unnamed: Q3.1 (G), R55.2
unnamed: Q3.2 (S), R56.1
unnamed: Q4.1 (G), R54.2
unnamed: R52.1, R53.2
unnamed: R59.1, R60.2

Notes on the sheet:
Place cap near ADC
Zener required on the 3V3 rail. Put Zener closer to the Rsensing circuits.
ADC range 2.7V. Allows for reasonable voltage drop across current source and diode. 300R and 3k max sensor resistance per range. Low range = 2.7 / 300 = 9mA, High range = 2.7 / 3k = 900uA. 150mV Vref. Low range = 150mV / 9mA = 16.666 ohm High range 150mV / 900uA = 166.666 ohm High range = 160R + 6R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

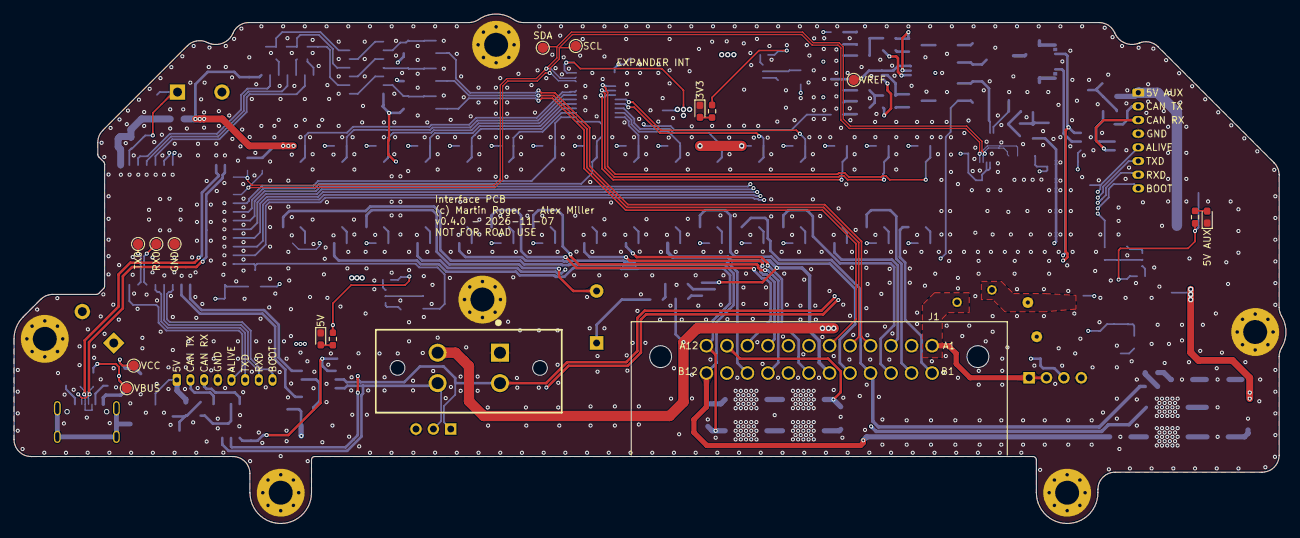
[picture p73: board VXDash.kicad_pcb from above]

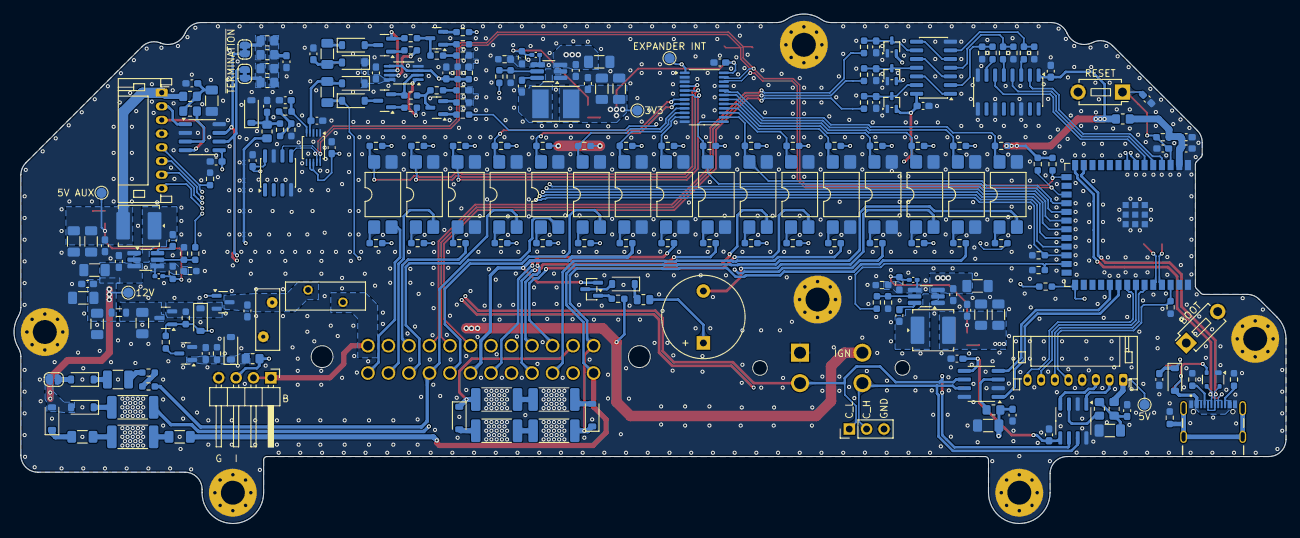
[picture p74: board VXDash.kicad_pcb from below]

Board: 4 copper layers, 186.0 x 74.5 mm, 266 parts (246 on the bottom side), 175 nets.
