martinroger/VXDash/KiCad PCB Files/VXDash_Connectors/VXDash_Connectors.kicad_pcb

## KiCad design KiCad PCB Files/VXDash_Connectors/VXDash_Connectors.kicad_pcb (2026-11-07)

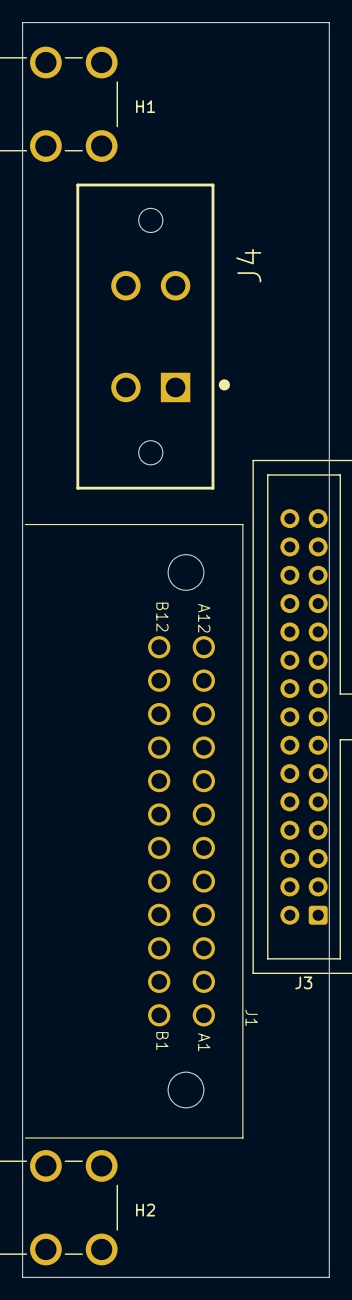
[picture p75: board VXDash_Connectors.kicad_pcb from above]

Board: 2 copper layers, 27.5 x 112.5 mm, 5 parts (0 on the bottom side), 25 nets, no tracks yet.

Parts:
H1, H2: M4 Thread mount; KEYSTONE_7765
J1: Header_VX220_RightAngle; Aptiv 12092886
J3: Passthrough; IDC-Header_2x15_P2.54mm_Vertical
J4: CANbus; TE_DTF13-4P

Connections:
/ABS_ActLO: J1.B12 (ABS), J3.28
/AIRBAG_ActLO: J1.B4 (Airbag), J3.12
/ALARM: J1.B7 (Alarm), J3.18
/ALTERN_ActLO: J1.A10 (Alternator), J3.19
/BATT12V+: J1.A1 (12V), J3.1, J3.2
/BRAKE_ActLO: J1.B1 (Brake_Fluid), J3.6
/BTN_ActLO: J1.B9 (Dash_Button), J3.22
/CAN_H: J3.30, J4.3
/CAN_L: J3.29, J4.2
/COOLANT_ActLO: J1.B10 (Coolant_Level), J3.24
/DOOR_ActLO: J1.B11 (Door_Switch), J3.26
/FUEL_LVL_Rsense: J1.A7 (Fuel_level), J3.13
/H_BEAM_ActHI: J1.A9 (Hi_Beam), J3.17
/IGNITION_ActHI: J1.A3 (Ignition), J3.5, J4.4
/IMMO_ActLO: J1.B5 (Immobiliser), J3.14
/L_BEAM_ActHI: J1.B6 (Low_Beam), J3.16
/L_TURN_ActHI: J1.A11 (Left_Indicator), J3.21
/OIL_ALRM_ActLO: J1.B3 (Oil_Pressure), J3.10
/PARK_ActLO: J1.B2 (Parking_Brake), J3.8
/RPM_HALL: J1.A4 (RPM), J3.7
/R_TURN_ActLO: J1.A12 (Right_Indicator), J3.23
/SPARE_B8: J1.B8 (?), J3.20
/SPEED_HALL: J1.A5 (Speed), J3.9
/WATER_T_PWM: J1.A6 (Water_Temp), J3.11
GND: H1.MP, H2.MP, J1.A2 (0V), J3.3, J3.4, J3.27, J4.1
