martinroger/VXDash/KiCad PCB Files/VXDash_Emulator_lite/VXDash_Emulator.kicad_pcb

## KiCad design KiCad PCB Files/VXDash_Emulator_lite/VXDash_Emulator.kicad_pcb (2026-11-07)

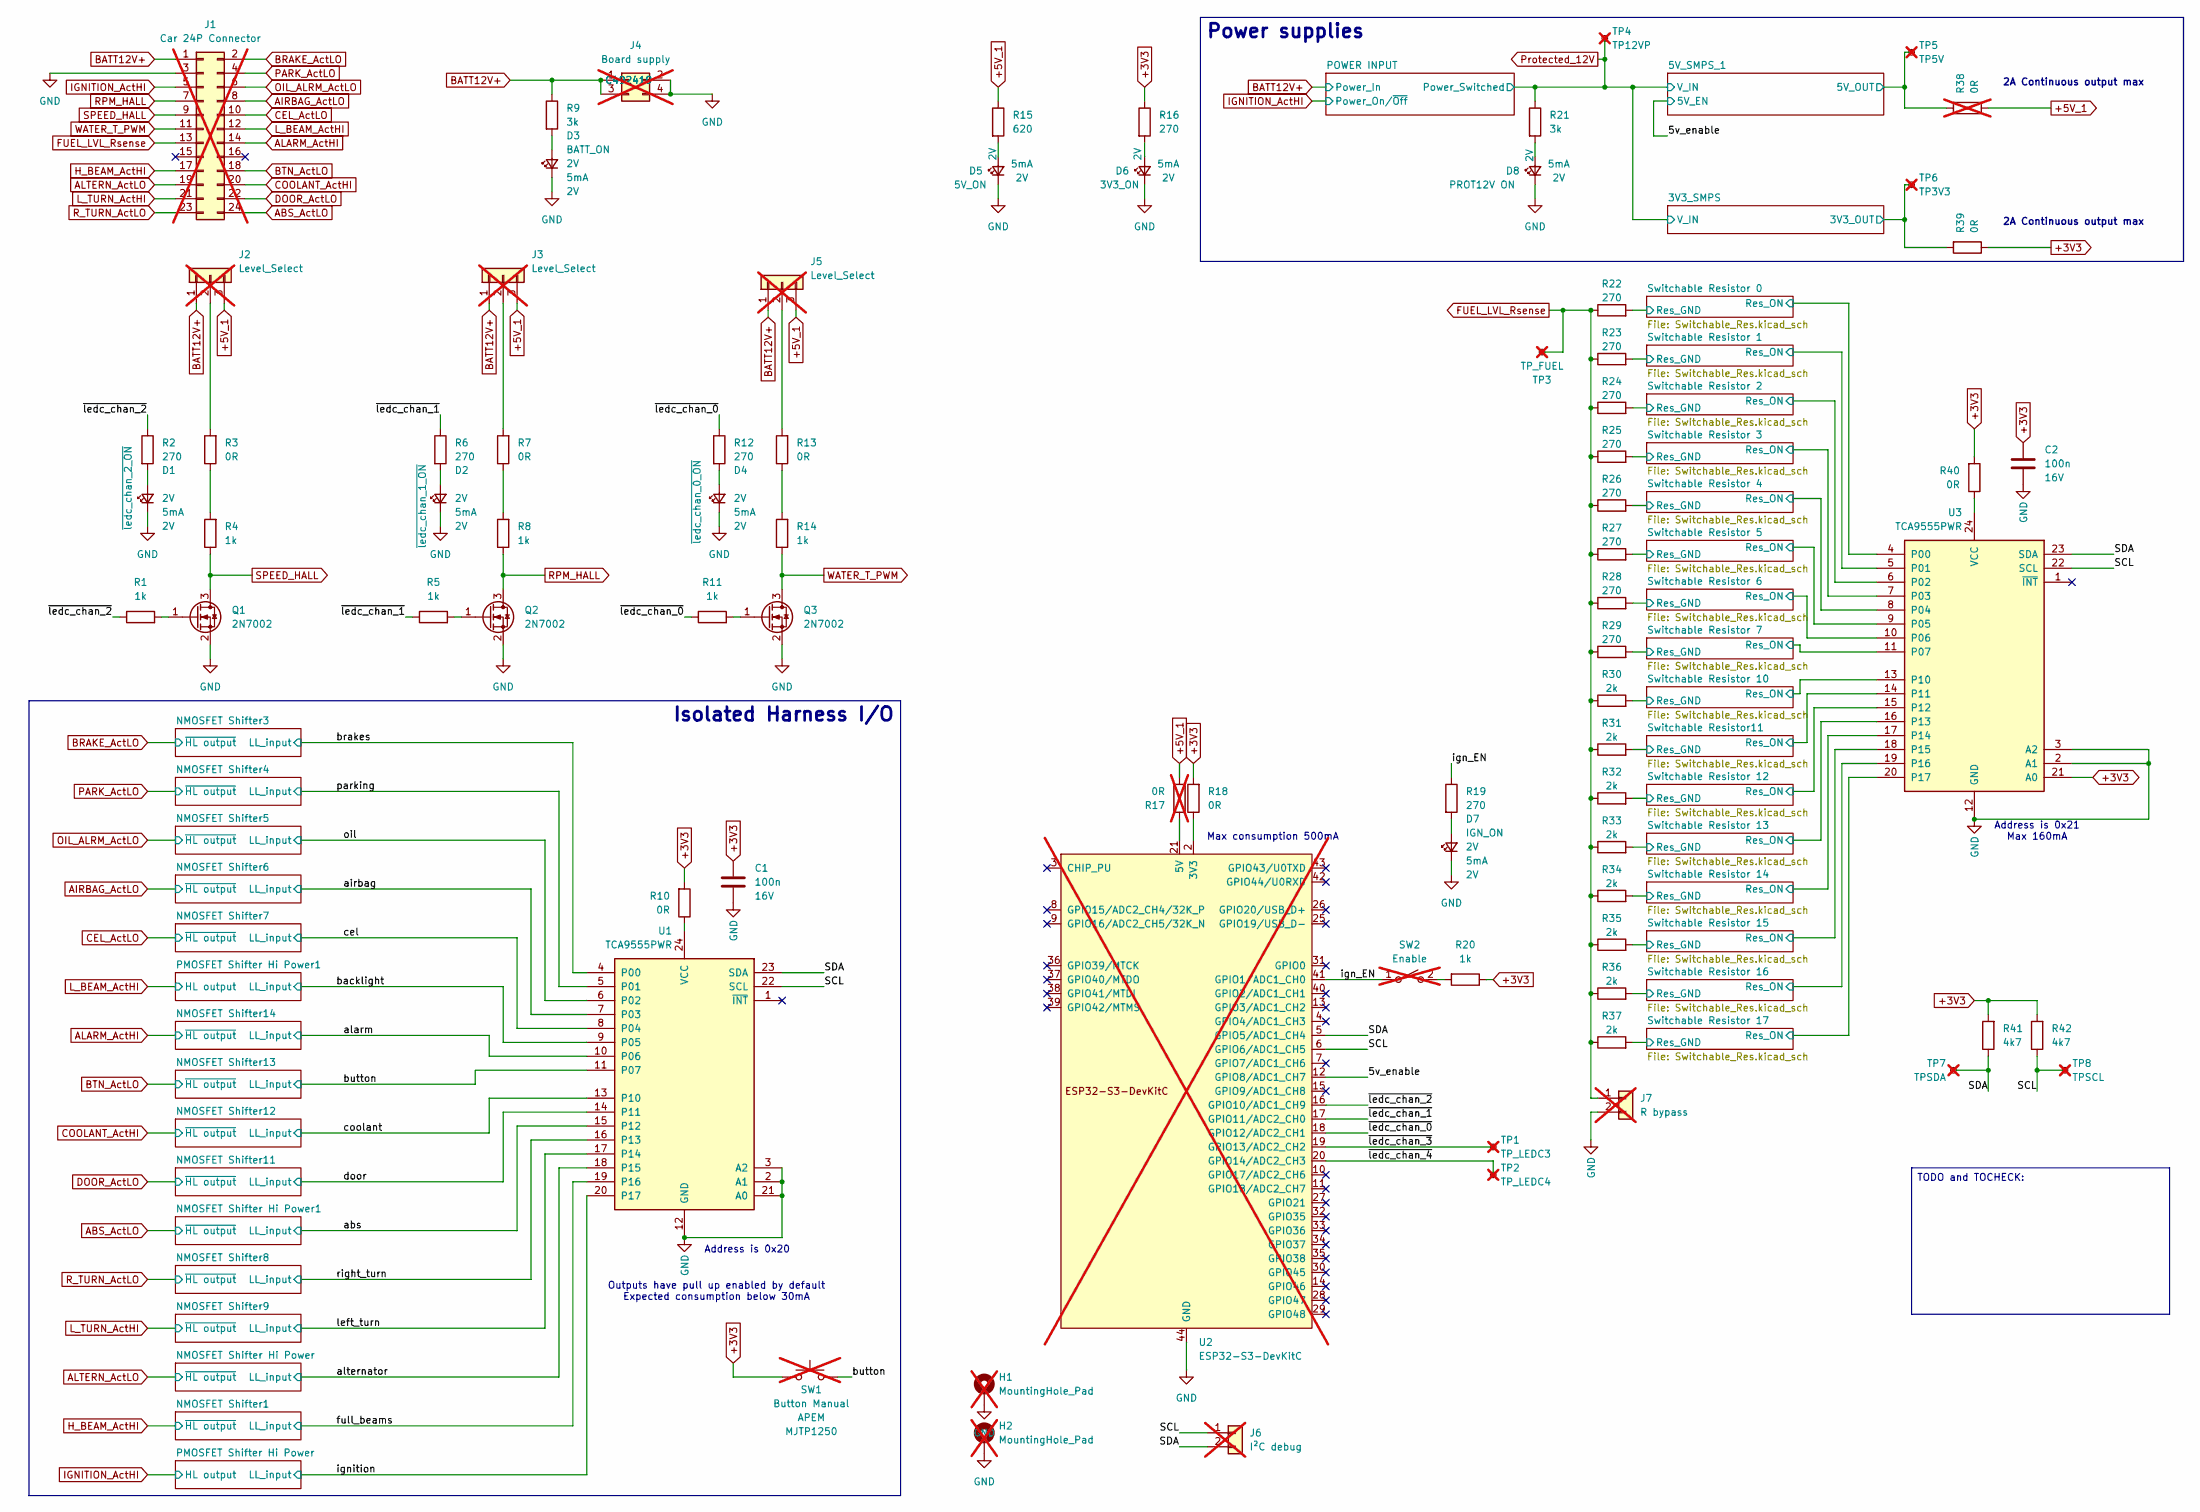
[picture p76: schematic VXDash_Emulator.kicad_sch, Main architecture]

Parts:
C1, C2: 100n; C_0603_1608Metric_Pad1.08x0.95mm_HandSolder; Voltage 16V; LCSC C108079
D1: ~{ledc_chan_2_ON}; LED_0603_1608Metric_Pad1.05x0.95mm_HandSolder; Voltage 2V; LCSC C7218224
D2: ~{ledc_chan_1_ON}; LED_0603_1608Metric_Pad1.05x0.95mm_HandSolder; Voltage 2V; LCSC C7218224
D3: BATT_ON; LED_0603_1608Metric_Pad1.05x0.95mm_HandSolder; Voltage 2V; LCSC C5556934
D4: ~{ledc_chan_0_ON}; LED_0603_1608Metric_Pad1.05x0.95mm_HandSolder; Voltage 2V; LCSC C7218224
D5: 5V_ON; LED_0603_1608Metric_Pad1.05x0.95mm_HandSolder; Voltage 2V; LCSC C5556934
D6: 3V3_ON; LED_0603_1608Metric_Pad1.05x0.95mm_HandSolder; Voltage 2V; LCSC C5556934
D7: IGN_ON; LED_0603_1608Metric_Pad1.05x0.95mm_HandSolder; Voltage 2V; LCSC C5556934
D8: PROT12V ON; LED_0603_1608Metric_Pad1.05x0.95mm_HandSolder; Voltage 2V; LCSC C5556934
H1, H2: MountingHole_Pad; MountingHole_3.5mm_Pad; not fitted
J1: Car 24P Connector; PinHeader_2x12_P2.54mm_Vertical; not fitted
J2, J3, J5: Level_Select; PinHeader_1x03_P2.54mm_Vertical; LCSC C2915006; not fitted
J4: Board supply; PinHeader_2x02_P2.54mm_Vertical; LCSC C492419; not fitted
J6: I²C debug; PinHeader_1x02_P2.54mm_Vertical; LCSC C2915055; not fitted
J7: R bypass; PinSocket_1x02_P2.54mm_Vertical; LCSC C2915055; not fitted
Q1, Q2, Q3: 2N7002; SOT-23; LCSC C78712
R1, R5, R11, R20: 1k; R_0603_1608Metric_Pad0.98x0.95mm_HandSolder; LCSC C22548
R2, R6, R12, R16, R19, R22, R23, R24, R25, R26, R27, R28, R29: 270; R_0603_1608Metric_Pad0.98x0.95mm_HandSolder; LCSC C137754
R3, R7, R10, R13, R18, R39, R40: 0R; R_0805_2012Metric_Pad1.20x1.40mm_HandSolder; LCSC C169855
R4, R8, R14: 1k; R_0805_2012Metric_Pad1.20x1.40mm_HandSolder; LCSC C2441430
R9, R21: 3k; R_0603_1608Metric_Pad0.98x0.95mm_HandSolder; LCSC C2484021
R15: 620; R_0603_1608Metric_Pad0.98x0.95mm_HandSolder; LCSC C1730848
R17, R38: 0R; R_0805_2012Metric_Pad1.20x1.40mm_HandSolder; LCSC C169855; not fitted
R30, R31, R32, R33, R34, R35, R36, R37: 2k; R_0603_1608Metric_Pad0.98x0.95mm_HandSolder; LCSC C237750
R41, R42: 4k7; R_0603_1608Metric_Pad0.98x0.95mm_HandSolder; LCSC C99782
SW1: Button Manual; SW_PUSH_1P1T_6x3.5mm_H5.0_APEM_MJTP1250; LCSC C6301337; not fitted
SW2: Enable; SW_DIP_SPSTx01_Slide_9.78x4.72mm_W7.62mm_P2.54mm; LCSC C3312384; not fitted
TP1: TP_LEDC3; TestPoint_Pad_D2.0mm; not fitted
TP2: TP_LEDC4; TestPoint_Pad_D2.0mm; not fitted
TP3: TP_FUEL; TestPoint_Pad_D2.0mm; not fitted
TP4: TP12VP; TestPoint_Pad_D2.0mm; not fitted
TP5: TP5V; TestPoint_Pad_D2.0mm; not fitted
TP6: TP3V3; TestPoint_Pad_D2.0mm; not fitted
TP7: TPSDA; TestPoint_Pad_D2.0mm; not fitted
TP8: TPSCL; TestPoint_Pad_D2.0mm; not fitted
U1, U3: TCA9555PWR; TSSOP-24_4.4x7.8mm_P0.65mm; LCSC C465732
U2: ESP32-S3-DevKitC; not fitted

Connections:
+3V3: C1.2, C2.2, R10.2, R16.1, R18.2, R20.1, R39.1, R40.2, R41.2, R42.2, SW1.1, U3.21 (A0); also elsewhere on the board
+5V_1: J2.3, J3.3, J5.3, R15.1, R17.1, R38.1
/3V3_SMPS/3V3_OUT: R39.2, TP6.1; also elsewhere on the board
/5V_SMPS_1/5V_OUT: R38.2, TP5.1; also elsewhere on the board
/5v_enable: U2.12 (GPIO8/ADC1_CH7); also elsewhere on the board
/SCL: J6.1, R42.1, TP8.1, U1.22 (SCL), U2.6 (GPIO6/ADC1_CH5), U3.22 (SCL)
/SDA: J6.2, R41.1, TP7.1, U1.23 (SDA), U2.5 (GPIO5/ADC1_CH4), U3.23 (SDA)
/Switchable Resistor11/Res_GND: R31.2; also elsewhere on the board
/Switchable Resistor11/Res_ON: U3.14 (P11); also elsewhere on the board
/Switchable Resistor 0/Res_GND: R22.2; also elsewhere on the board
/Switchable Resistor 0/Res_ON: U3.4 (P00); also elsewhere on the board
/Switchable Resistor 1/Res_GND: R23.2; also elsewhere on the board
/Switchable Resistor 1/Res_ON: U3.5 (P01); also elsewhere on the board
/Switchable Resistor 2/Res_GND: R24.2; also elsewhere on the board
/Switchable Resistor 2/Res_ON: U3.6 (P02); also elsewhere on the board
/Switchable Resistor 3/Res_GND: R25.2; also elsewhere on the board
/Switchable Resistor 3/Res_ON: U3.7 (P03); also elsewhere on the board
/Switchable Resistor 4/Res_GND: R26.2; also elsewhere on the board
/Switchable Resistor 4/Res_ON: U3.8 (P04); also elsewhere on the board
/Switchable Resistor 5/Res_GND: R27.2; also elsewhere on the board
/Switchable Resistor 5/Res_ON: U3.9 (P05); also elsewhere on the board
/Switchable Resistor 6/Res_GND: R28.2; also elsewhere on the board
/Switchable Resistor 6/Res_ON: U3.10 (P06); also elsewhere on the board
/Switchable Resistor 7/Res_GND: R29.2; also elsewhere on the board
/Switchable Resistor 7/Res_ON: U3.11 (P07); also elsewhere on the board
/Switchable Resistor 10/Res_GND: R30.2; also elsewhere on the board
/Switchable Resistor 10/Res_ON: U3.13 (P10); also elsewhere on the board
/Switchable Resistor 12/Res_GND: R32.2; also elsewhere on the board
/Switchable Resistor 12/Res_ON: U3.15 (P12); also elsewhere on the board
/Switchable Resistor 13/Res_GND: R33.2; also elsewhere on the board
/Switchable Resistor 13/Res_ON: U3.16 (P13); also elsewhere on the board
/Switchable Resistor 14/Res_GND: R34.2; also elsewhere on the board
/Switchable Resistor 14/Res_ON: U3.17 (P14); also elsewhere on the board
/Switchable Resistor 15/Res_GND: R35.2; also elsewhere on the board
/Switchable Resistor 15/Res_ON: U3.18 (P15); also elsewhere on the board
/Switchable Resistor 16/Res_GND: R36.2; also elsewhere on the board
/Switchable Resistor 16/Res_ON: U3.19 (P16); also elsewhere on the board
/Switchable Resistor 17/Res_GND: R37.2; also elsewhere on the board
/Switchable Resistor 17/Res_ON: U3.20 (P17); also elsewhere on the board
/abs: U1.15 (P12); also elsewhere on the board
/airbag: U1.7 (P03); also elsewhere on the board
/alarm: U1.10 (P06); also elsewhere on the board
/alternator: U1.18 (P15); also elsewhere on the board
/backlight: U1.9 (P05); also elsewhere on the board
/brakes: U1.4 (P00); also elsewhere on the board
/button: SW1.2, U1.11 (P07); also elsewhere on the board
/cel: U1.8 (P04); also elsewhere on the board
/coolant: U1.13 (P10); also elsewhere on the board
/door: U1.14 (P11); also elsewhere on the board
/full_beams: U1.19 (P16); also elsewhere on the board
/ign_EN: R19.1, SW2.1 (A), U2.41 (GPIO1/ADC1_CH0)
/ignition: U1.20 (P17); also elsewhere on the board
/left_turn: U1.17 (P14); also elsewhere on the board
/oil: U1.6 (P02); also elsewhere on the board
/parking: U1.5 (P01); also elsewhere on the board
/right_turn: U1.16 (P13); also elsewhere on the board
/~ledc_chan_0: R11.1, R12.1, U2.18 (GPIO12/ADC2_CH1)
/~ledc_chan_1: R5.1, R6.1, U2.17 (GPIO11/ADC2_CH0)
/~ledc_chan_2: R1.1, R2.1, U2.16 (GPIO10/ADC1_CH9)
/~ledc_chan_3: TP1.1, U2.19 (GPIO13/ADC2_CH2)
/~ledc_chan_4: TP2.1, U2.20 (GPIO14/ADC2_CH3)
ABS_ActLO: J1.24; also elsewhere on the board
AIRBAG_ActLO: J1.8; also elsewhere on the board
ALARM_ActHI: J1.14; also elsewhere on the board
ALTERN_ActLO: J1.19; also elsewhere on the board
BATT12V+: J1.1, J2.1, J3.1, J4.1, J4.3, J5.1, R9.1; also elsewhere on the board
BRAKE_ActLO: J1.2; also elsewhere on the board
BTN_ActLO: J1.18; also elsewhere on the board
CEL_ActLO: J1.10; also elsewhere on the board
COOLANT_ActHI: J1.20; also elsewhere on the board
DOOR_ActLO: J1.22; also elsewhere on the board
FUEL_LVL_Rsense: J1.13, J7.1, R22.1, R23.1, R24.1, R25.1, R26.1, R27.1, R28.1, R29.1, R30.1, R31.1, R32.1, R33.1, R34.1, R35.1, R36.1, R37.1, TP3.1
GND: C1.1, C2.1, D1.1 (K), D2.1 (K), D3.1 (K), D4.1 (K), D5.1 (K), D6.1 (K), D7.1 (K), D8.1 (K), H1.1, H2.1, J1.3, J4.2, J4.4, J7.2, Q1.2 (S), Q2.2 (S), Q3.2 (S), U1.2 (A1), U1.3 (A2), U1.12 (GND), U1.21 (A0), U2.22 (GND), U2.23 (GND), U2.24 (GND), U2.44 (GND), U3.2 (A1), U3.3 (A2), U3.12 (GND); also elsewhere on the board
H_BEAM_ActHI: J1.17; also elsewhere on the board
IGNITION_ActHI: J1.5; also elsewhere on the board
L_BEAM_ActHI: J1.12; also elsewhere on the board
L_TURN_ActHI: J1.21; also elsewhere on the board
unnamed: D1.2 (A), R2.2
unnamed: D2.2 (A), R6.2
unnamed: D3.2 (A), R9.2
unnamed: D4.2 (A), R12.2
unnamed: D5.2 (A), R15.2
unnamed: D6.2 (A), R16.2
unnamed: D7.2 (A), R19.2
unnamed: D8.2 (A), R21.2
unnamed: J2.2, R3.2
unnamed: J3.2, R7.2
unnamed: J5.2, R13.2
unnamed: Q1.1 (G), R1.2
unnamed: Q2.1 (G), R5.2
unnamed: Q3.1 (G), R11.2
unnamed: R3.1, R4.2
unnamed: R7.1, R8.2
unnamed: R13.1, R14.2
unnamed: R18.1, U2.1 (3V3), U2.2 (3V3)
unnamed: R20.2, SW2.2 (B)
unnamed: R10.1, U1.24 (VCC)
unnamed: R17.2, U2.21 (5V)
unnamed: R40.1, U3.24 (VCC)
OIL_ALRM_ActLO: J1.6; also elsewhere on the board
PARK_ActLO: J1.4; also elsewhere on the board
Protected_12V: R21.1, TP4.1; also elsewhere on the board
RPM_HALL: J1.7, Q2.3 (D), R8.1
R_TURN_ActLO: J1.23; also elsewhere on the board
SPEED_HALL: J1.9, Q1.3 (D), R4.1
WATER_T_PWM: J1.11, Q3.3 (D), R14.1

Notes on the sheet:
Address is 0x21 Max 160mA
Address is 0x20
Outputs have pull up enabled by default Expected consumption below 30mA
2A Continuous output max
Max consumption 500mA
Isolated Harness I/O
Power supplies
TODO and TOCHECK:

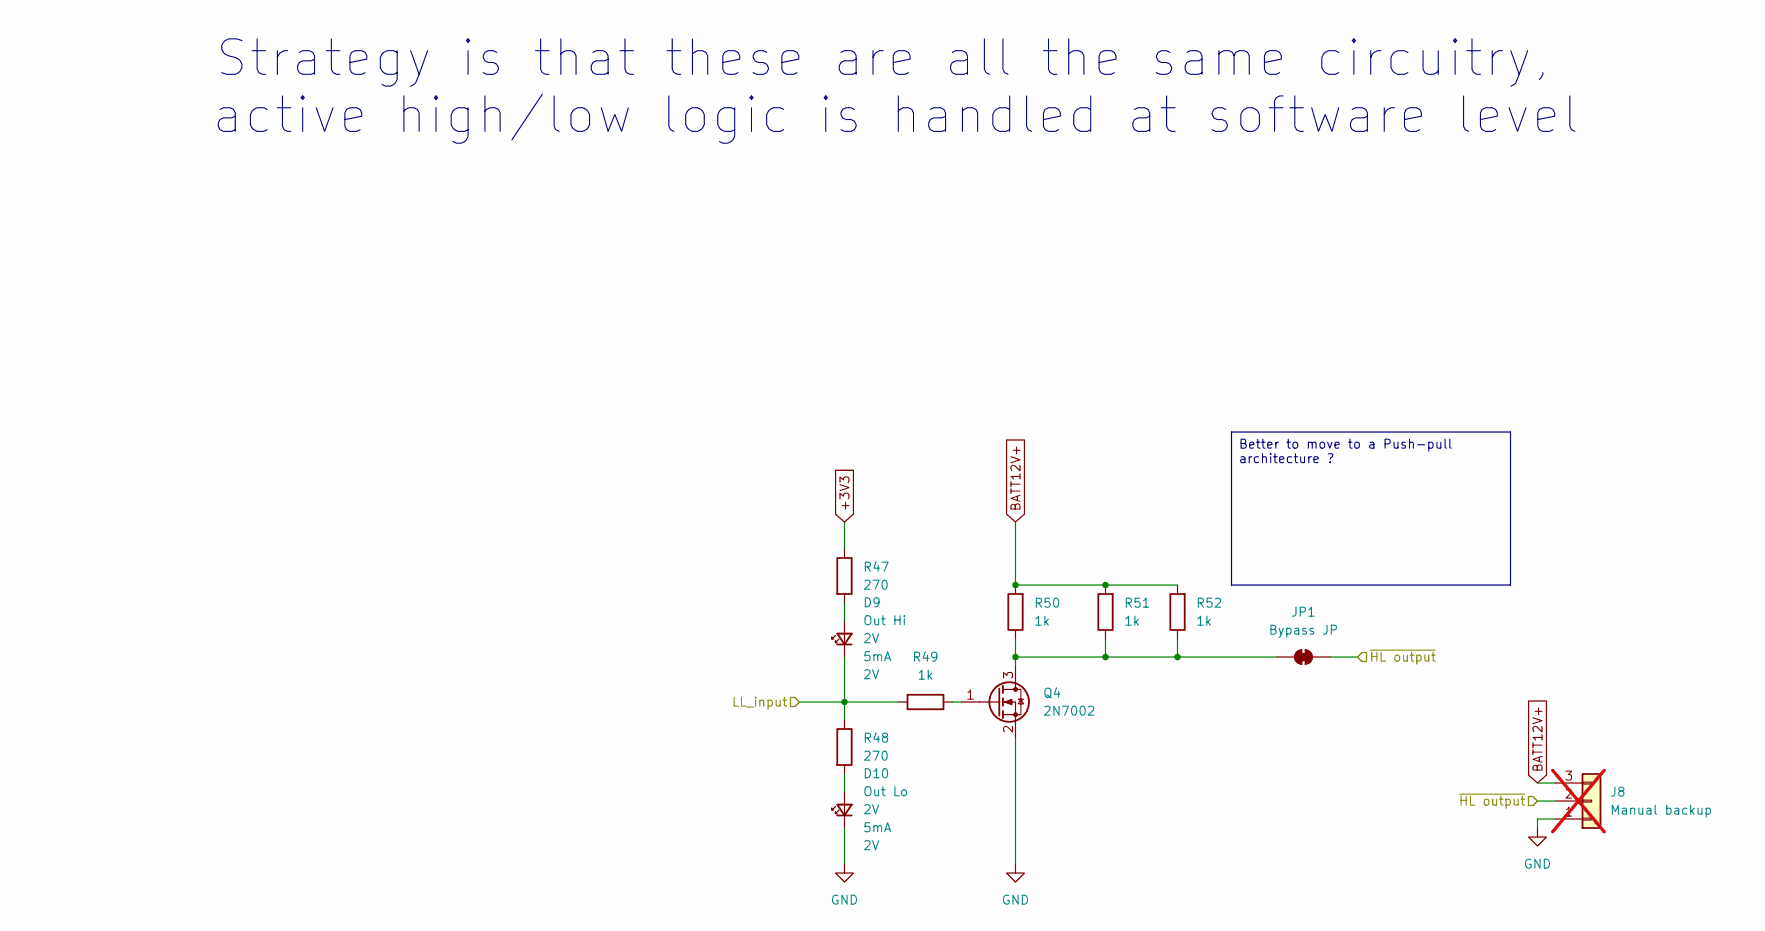
[picture p77: schematic FET_Active_Hi.kicad_sch, Main architecture]

Parts:
D9: Out Hi; LED_0603_1608Metric_Pad1.05x0.95mm_HandSolder; Voltage 2V; LCSC C5556934
D10: Out Lo; LED_0603_1608Metric_Pad1.05x0.95mm_HandSolder; Voltage 2V; LCSC C5556934
J8: Manual backup; PinHeader_1x03_P2.54mm_Vertical; LCSC C2915006; not fitted
JP1: Bypass JP; SolderJumper-2_P1.3mm_Bridged_RoundedPad1.0x1.5mm
Q4: 2N7002; SOT-23; LCSC C78712
R47, R48: 270; R_0603_1608Metric_Pad0.98x0.95mm_HandSolder; LCSC C137754
R49: 1k; R_0603_1608Metric_Pad0.98x0.95mm_HandSolder; LCSC C22548
R50, R51, R52: 1k; R_0805_2012Metric_Pad1.20x1.40mm_HandSolder; LCSC C2441430

Connections:
+3V3: R47.1; also elsewhere on the board
/full_beams: D9.1 (K), R48.1, R49.1; also elsewhere on the board
BATT12V+: J8.3, R50.2, R51.2, R52.2; also elsewhere on the board
GND: D10.1 (K), J8.1, Q4.2 (S); also elsewhere on the board
H_BEAM_ActHI: J8.2, JP1.2 (B); also elsewhere on the board
unnamed: D9.2 (A), R47.2
unnamed: D10.2 (A), R48.2
unnamed: JP1.1 (A), Q4.3 (D), R50.1, R51.1, R52.1
unnamed: Q4.1 (G), R49.2

Parts of its further copies:
D13, D15, D17, D19, D21, D23, D25, D29, D31, D33, D35: Out Hi; LED_0603_1608Metric_Pad1.05x0.95mm_HandSolder; Voltage 2V; LCSC C5556934
D14, D16, D18, D20, D22, D24, D26, D30, D32, D34, D36: Out Lo; LED_0603_1608Metric_Pad1.05x0.95mm_HandSolder; Voltage 2V; LCSC C5556934
J10, J11, J12, J13, J14, J15, J16, J18, J19, J20, J21: Manual backup; PinHeader_1x03_P2.54mm_Vertical; LCSC C2915006; not fitted
JP3, JP4, JP5, JP6, JP7, JP8, JP9, JP11, JP12, JP13, JP14: Bypass JP; SolderJumper-2_P1.3mm_Bridged_RoundedPad1.0x1.5mm
Q6, Q7, Q8, Q9, Q10, Q11, Q12, Q14, Q15, Q16, Q17: 2N7002; SOT-23; LCSC C78712
R59, R60, R65, R66, R71, R72, R77, R78, R83, R84, R89, R90, R95, R96, R107, R108, R113, R114, R119, R120, R125, R126: 270; R_0603_1608Metric_Pad0.98x0.95mm_HandSolder; LCSC C137754
R61, R67, R73, R79, R85, R91, R97, R109, R115, R121, R127: 1k; R_0603_1608Metric_Pad0.98x0.95mm_HandSolder; LCSC C22548
R62, R63, R64, R68, R69, R70, R74, R75, R76, R80, R81, R82, R86, R87, R88, R92, R93, R94, R98, R99, R100, R110, R111, R112, R116, R117, R118, R122, R123, R124, R128, R129, R130: 1k; R_0805_2012Metric_Pad1.20x1.40mm_HandSolder; LCSC C2441430

Connections of its further copies:
+3V3: R59.1, R65.1, R71.1, R77.1, R83.1, R89.1, R95.1, R107.1, R113.1, R119.1, R125.1; also elsewhere on the board
/airbag: D19.1 (K), R78.1, R79.1; also elsewhere on the board
/alarm: D35.1 (K), R126.1, R127.1; also elsewhere on the board
/brakes: D13.1 (K), R60.1, R61.1; also elsewhere on the board
/button: D33.1 (K), R120.1, R121.1; also elsewhere on the board
/cel: D21.1 (K), R84.1, R85.1; also elsewhere on the board
/coolant: D31.1 (K), R114.1, R115.1; also elsewhere on the board
/door: D29.1 (K), R108.1, R109.1; also elsewhere on the board
/left_turn: D25.1 (K), R96.1, R97.1; also elsewhere on the board
/oil: D17.1 (K), R72.1, R73.1; also elsewhere on the board
/parking: D15.1 (K), R66.1, R67.1; also elsewhere on the board
/right_turn: D23.1 (K), R90.1, R91.1; also elsewhere on the board
AIRBAG_ActLO: J13.2, JP6.2 (B); also elsewhere on the board
ALARM_ActHI: J21.2, JP14.2 (B); also elsewhere on the board
BATT12V+: J10.3, J11.3, J12.3, J13.3, J14.3, J15.3, J16.3, J18.3, J19.3, J20.3, J21.3, R62.2, R63.2, R64.2, R68.2, R69.2, R70.2, R74.2, R75.2, R76.2, R80.2, R81.2, R82.2, R86.2, R87.2, R88.2, R92.2, R93.2, R94.2, R98.2, R99.2, R100.2, R110.2, R111.2, R112.2, R116.2, R117.2, R118.2, R122.2, R123.2, R124.2, R128.2, R129.2, R130.2; also elsewhere on the board
BRAKE_ActLO: J10.2, JP3.2 (B); also elsewhere on the board
BTN_ActLO: J20.2, JP13.2 (B); also elsewhere on the board
CEL_ActLO: J14.2, JP7.2 (B); also elsewhere on the board
COOLANT_ActHI: J19.2, JP12.2 (B); also elsewhere on the board
DOOR_ActLO: J18.2, JP11.2 (B); also elsewhere on the board
GND: D14.1 (K), D16.1 (K), D18.1 (K), D20.1 (K), D22.1 (K), D24.1 (K), D26.1 (K), D30.1 (K), D32.1 (K), D34.1 (K), D36.1 (K), J10.1, J11.1, J12.1, J13.1, J14.1, J15.1, J16.1, J18.1, J19.1, J20.1, J21.1, Q6.2 (S), Q7.2 (S), Q8.2 (S), Q9.2 (S), Q10.2 (S), Q11.2 (S), Q12.2 (S), Q14.2 (S), Q15.2 (S), Q16.2 (S), Q17.2 (S); also elsewhere on the board
L_TURN_ActHI: J16.2, JP9.2 (B); also elsewhere on the board
unnamed: D13.2 (A), R59.2
unnamed: D14.2 (A), R60.2
unnamed: D15.2 (A), R65.2
unnamed: D16.2 (A), R66.2
unnamed: D17.2 (A), R71.2
unnamed: D18.2 (A), R72.2
unnamed: D19.2 (A), R77.2
unnamed: D20.2 (A), R78.2
unnamed: D21.2 (A), R83.2
unnamed: D22.2 (A), R84.2
unnamed: D23.2 (A), R89.2
unnamed: D24.2 (A), R90.2
unnamed: D25.2 (A), R95.2
unnamed: D26.2 (A), R96.2
unnamed: D29.2 (A), R107.2
unnamed: D30.2 (A), R108.2
unnamed: D31.2 (A), R113.2
unnamed: D32.2 (A), R114.2
unnamed: D33.2 (A), R119.2
unnamed: D34.2 (A), R120.2
unnamed: D35.2 (A), R125.2
unnamed: D36.2 (A), R126.2
unnamed: JP3.1 (A), Q6.3 (D), R62.1, R63.1, R64.1
unnamed: JP4.1 (A), Q7.3 (D), R68.1, R69.1, R70.1
unnamed: JP5.1 (A), Q8.3 (D), R74.1, R75.1, R76.1
unnamed: JP6.1 (A), Q9.3 (D), R80.1, R81.1, R82.1
unnamed: JP7.1 (A), Q10.3 (D), R86.1, R87.1, R88.1
unnamed: JP8.1 (A), Q11.3 (D), R92.1, R93.1, R94.1
unnamed: JP9.1 (A), Q12.3 (D), R98.1, R99.1, R100.1
unnamed: JP11.1 (A), Q14.3 (D), R110.1, R111.1, R112.1
unnamed: JP12.1 (A), Q15.3 (D), R116.1, R117.1, R118.1
unnamed: JP13.1 (A), Q16.3 (D), R122.1, R123.1, R124.1
unnamed: JP14.1 (A), Q17.3 (D), R128.1, R129.1, R130.1
unnamed: Q6.1 (G), R61.2
unnamed: Q7.1 (G), R67.2
unnamed: Q8.1 (G), R73.2
unnamed: Q9.1 (G), R79.2
unnamed: Q10.1 (G), R85.2
unnamed: Q11.1 (G), R91.2
unnamed: Q12.1 (G), R97.2
unnamed: Q14.1 (G), R109.2
unnamed: Q15.1 (G), R115.2
unnamed: Q16.1 (G), R121.2
unnamed: Q17.1 (G), R127.2
OIL_ALRM_ActLO: J12.2, JP5.2 (B); also elsewhere on the board
PARK_ActLO: J11.2, JP4.2 (B); also elsewhere on the board
R_TURN_ActLO: J15.2, JP8.2 (B); also elsewhere on the board

Notes on the sheet:
Strategy is that these are all the same circuitry, active high/low logic is handled at software level
Better to move to a Push-pull architecture ?

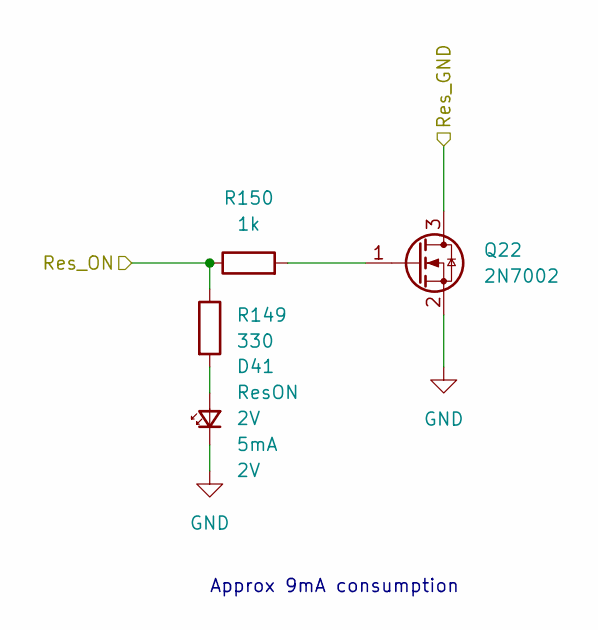
[picture p78: schematic Switchable_Res.kicad_sch, Main architecture]

Parts:
D41: ResON; LED_0603_1608Metric_Pad1.05x0.95mm_HandSolder; Voltage 2V; LCSC C7218224
Q22: 2N7002; SOT-23; LCSC C78712
R149: 330; R_0603_1608Metric_Pad0.98x0.95mm_HandSolder; LCSC C105881
R150: 1k; R_0603_1608Metric_Pad0.98x0.95mm_HandSolder; LCSC C22548

Connections:
/Switchable Resistor 1/Res_GND: Q22.3 (D); also elsewhere on the board
/Switchable Resistor 1/Res_ON: R149.1, R150.1; also elsewhere on the board
GND: D41.1 (K), Q22.2 (S); also elsewhere on the board
unnamed: D41.2 (A), R149.2
unnamed: Q22.1 (G), R150.2

Parts of its further copies:
D42, D43, D44, D45, D46, D49, D50, D51, D52, D53, D54, D55, D56, D57, D58: ResON; LED_0603_1608Metric_Pad1.05x0.95mm_HandSolder; Voltage 2V; LCSC C7218224
Q23, Q24, Q25, Q26, Q27, Q31, Q32, Q33, Q34, Q35, Q36, Q37, Q38, Q39, Q40: 2N7002; SOT-23; LCSC C78712
R151, R153, R155, R157, R159, R165, R167, R169, R171, R173, R175, R177, R179, R181, R183: 330; R_0603_1608Metric_Pad0.98x0.95mm_HandSolder; LCSC C105881
R152, R154, R156, R158, R160, R166, R168, R170, R172, R174, R176, R178, R180, R182, R184: 1k; R_0603_1608Metric_Pad0.98x0.95mm_HandSolder; LCSC C22548

Connections of its further copies:
/Switchable Resistor11/Res_GND: Q34.3 (D); also elsewhere on the board
/Switchable Resistor11/Res_ON: R171.1, R172.1; also elsewhere on the board
/Switchable Resistor 0/Res_GND: Q23.3 (D); also elsewhere on the board
/Switchable Resistor 0/Res_ON: R151.1, R152.1; also elsewhere on the board
/Switchable Resistor 2/Res_GND: Q24.3 (D); also elsewhere on the board
/Switchable Resistor 2/Res_ON: R153.1, R154.1; also elsewhere on the board
/Switchable Resistor 3/Res_GND: Q25.3 (D); also elsewhere on the board
/Switchable Resistor 3/Res_ON: R155.1, R156.1; also elsewhere on the board
/Switchable Resistor 4/Res_GND: Q26.3 (D); also elsewhere on the board
/Switchable Resistor 4/Res_ON: R157.1, R158.1; also elsewhere on the board
/Switchable Resistor 5/Res_GND: Q27.3 (D); also elsewhere on the board
/Switchable Resistor 5/Res_ON: R159.1, R160.1; also elsewhere on the board
/Switchable Resistor 6/Res_GND: Q31.3 (D); also elsewhere on the board
/Switchable Resistor 6/Res_ON: R165.1, R166.1; also elsewhere on the board
/Switchable Resistor 7/Res_GND: Q32.3 (D); also elsewhere on the board
/Switchable Resistor 7/Res_ON: R167.1, R168.1; also elsewhere on the board
/Switchable Resistor 10/Res_GND: Q33.3 (D); also elsewhere on the board
/Switchable Resistor 10/Res_ON: R169.1, R170.1; also elsewhere on the board
/Switchable Resistor 12/Res_GND: Q35.3 (D); also elsewhere on the board
/Switchable Resistor 12/Res_ON: R173.1, R174.1; also elsewhere on the board
/Switchable Resistor 13/Res_GND: Q36.3 (D); also elsewhere on the board
/Switchable Resistor 13/Res_ON: R175.1, R176.1; also elsewhere on the board
/Switchable Resistor 14/Res_GND: Q39.3 (D); also elsewhere on the board
/Switchable Resistor 14/Res_ON: R181.1, R182.1; also elsewhere on the board
/Switchable Resistor 15/Res_GND: Q38.3 (D); also elsewhere on the board
/Switchable Resistor 15/Res_ON: R179.1, R180.1; also elsewhere on the board
/Switchable Resistor 16/Res_GND: Q40.3 (D); also elsewhere on the board
/Switchable Resistor 16/Res_ON: R183.1, R184.1; also elsewhere on the board
/Switchable Resistor 17/Res_GND: Q37.3 (D); also elsewhere on the board
/Switchable Resistor 17/Res_ON: R177.1, R178.1; also elsewhere on the board
GND: D42.1 (K), D43.1 (K), D44.1 (K), D45.1 (K), D46.1 (K), D49.1 (K), D50.1 (K), D51.1 (K), D52.1 (K), D53.1 (K), D54.1 (K), D55.1 (K), D56.1 (K), D57.1 (K), D58.1 (K), Q23.2 (S), Q24.2 (S), Q25.2 (S), Q26.2 (S), Q27.2 (S), Q31.2 (S), Q32.2 (S), Q33.2 (S), Q34.2 (S), Q35.2 (S), Q36.2 (S), Q37.2 (S), Q38.2 (S), Q39.2 (S), Q40.2 (S); also elsewhere on the board
unnamed: D42.2 (A), R151.2
unnamed: D43.2 (A), R153.2
unnamed: D44.2 (A), R155.2
unnamed: D45.2 (A), R157.2
unnamed: D46.2 (A), R159.2
unnamed: D49.2 (A), R165.2
unnamed: D50.2 (A), R167.2
unnamed: D51.2 (A), R169.2
unnamed: D52.2 (A), R171.2
unnamed: D53.2 (A), R173.2
unnamed: D54.2 (A), R175.2
unnamed: D55.2 (A), R177.2
unnamed: D56.2 (A), R179.2
unnamed: D57.2 (A), R181.2
unnamed: D58.2 (A), R183.2
unnamed: Q23.1 (G), R152.2
unnamed: Q24.1 (G), R154.2
unnamed: Q25.1 (G), R156.2
unnamed: Q26.1 (G), R158.2
unnamed: Q27.1 (G), R160.2
unnamed: Q31.1 (G), R166.2
unnamed: Q32.1 (G), R168.2
unnamed: Q33.1 (G), R170.2
unnamed: Q34.1 (G), R172.2
unnamed: Q35.1 (G), R174.2
unnamed: Q36.1 (G), R176.2
unnamed: Q37.1 (G), R178.2
unnamed: Q38.1 (G), R180.2
unnamed: Q39.1 (G), R182.2
unnamed: Q40.1 (G), R184.2

Notes on the sheet:
Approx 9mA consumption

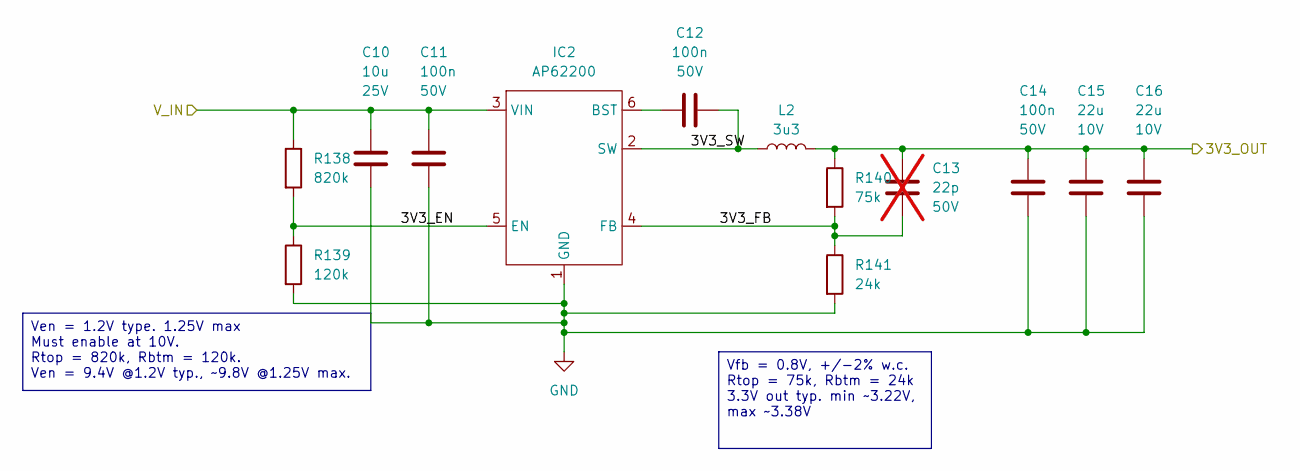
[picture p79: schematic 3V3_SMPS.kicad_sch, Main architecture]

Parts:
C10: 10u; C_1206_3216Metric_Pad1.33x1.80mm_HandSolder; Voltage 25V; LCSC C14860
C11, C12, C14: 100n; C_0603_1608Metric_Pad1.08x0.95mm_HandSolder; Voltage 50V; LCSC C1591
C13: 22p; C_0603_1608Metric_Pad1.08x0.95mm_HandSolder; Voltage 50V; LCSC C597198; not fitted
C15, C16: 22u; C_1206_3216Metric_Pad1.33x1.80mm_HandSolder; Voltage 10V; LCSC C87996
IC2: AP62200; TSOT-23-6_HandSoldering; LCSC C1323282
L2: 3u3; L_Taiyo-Yuden_NR-50xx_HandSoldering; LCSC C222937
R138: 820k; R_0603_1608Metric_Pad0.98x0.95mm_HandSolder; LCSC C2481758
R139: 120k; R_0603_1608Metric_Pad0.98x0.95mm_HandSolder; LCSC C2479411
R140: 75k; R_0603_1608Metric_Pad0.98x0.95mm_HandSolder; LCSC C2479409
R141: 24k; R_0603_1608Metric_Pad0.98x0.95mm_HandSolder; LCSC C7037979

Connections:
/3V3_SMPS/3V3_EN: IC2.5 (EN), R138.2, R139.1
/3V3_SMPS/3V3_FB: C13.2, IC2.4 (FB), R140.2, R141.1
/3V3_SMPS/3V3_OUT: C13.1, C14.2, C15.1, C16.1, L2.2, R140.1; also elsewhere on the board
/3V3_SMPS/3V3_SW: C12.1, IC2.2 (SW), L2.1
GND: C10.1, C11.1, C14.1, C15.2, C16.2, IC2.1 (GND), R139.2, R141.2; also elsewhere on the board
unnamed: C12.2, IC2.6 (BST)
Protected_12V: C10.2, C11.2, IC2.3 (VIN), R138.1; also elsewhere on the board

Notes on the sheet:
Ven = 1.2V type. 1.25V max Must enable at 10V. Rtop = 820k, Rbtm = 120k. Ven = 9.4V @1.2V typ., ~9.8V @1.25V max.
Vfb = 0.8V, +/-2% w.c. Rtop = 75k, Rbtm = 24k 3.3V out typ. min ~3.22V, max ~3.38V

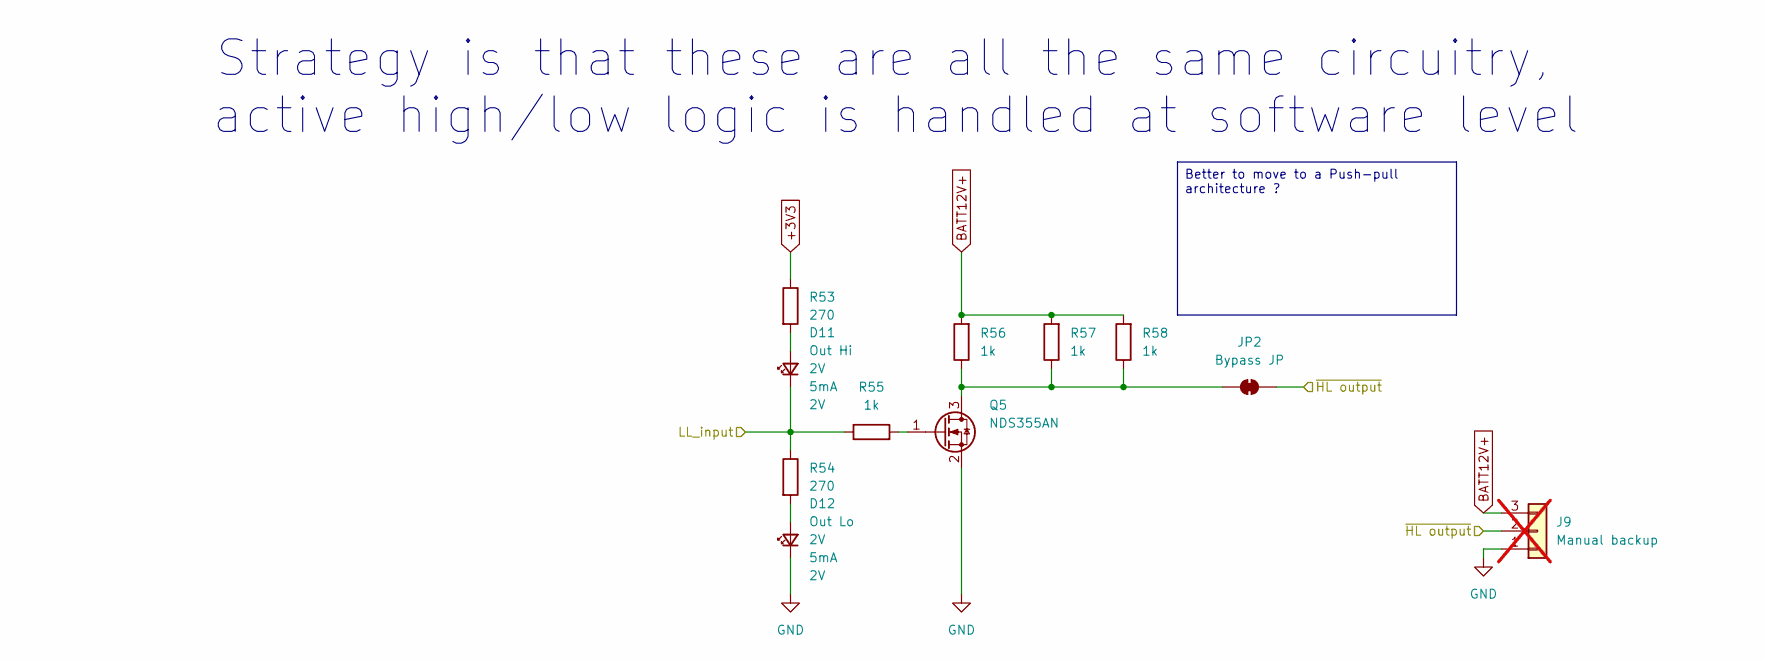
[picture p80: schematic FET_Active_Hi_HP.kicad_sch, Main architecture]

Parts:
D11: Out Hi; LED_0603_1608Metric_Pad1.05x0.95mm_HandSolder; Voltage 2V; LCSC C5556934
D12: Out Lo; LED_0603_1608Metric_Pad1.05x0.95mm_HandSolder; Voltage 2V; LCSC C5556934
J9: Manual backup; PinHeader_1x03_P2.54mm_Vertical; LCSC C2915006; not fitted
JP2: Bypass JP; SolderJumper-2_P1.3mm_Bridged_RoundedPad1.0x1.5mm
Q5: NDS355AN; SOT-23; LCSC C236917
R53, R54: 270; R_0603_1608Metric_Pad0.98x0.95mm_HandSolder; LCSC C137754
R55: 1k; R_0603_1608Metric_Pad0.98x0.95mm_HandSolder; LCSC C22548
R56, R57, R58: 1k; R_0805_2012Metric_Pad1.20x1.40mm_HandSolder; LCSC C2441430

Connections:
+3V3: R53.1; also elsewhere on the board
/alternator: D11.1 (K), R54.1, R55.1; also elsewhere on the board
ALTERN_ActLO: J9.2, JP2.2 (B); also elsewhere on the board
BATT12V+: J9.3, R56.2, R57.2, R58.2; also elsewhere on the board
GND: D12.1 (K), J9.1, Q5.2 (S); also elsewhere on the board
unnamed: D11.2 (A), R53.2
unnamed: D12.2 (A), R54.2
unnamed: JP2.1 (A), Q5.3 (D), R56.1, R57.1, R58.1
unnamed: Q5.1 (G), R55.2

Parts of its further copies:
D27: Out Hi; LED_0603_1608Metric_Pad1.05x0.95mm_HandSolder; Voltage 2V; LCSC C5556934
D28: Out Lo; LED_0603_1608Metric_Pad1.05x0.95mm_HandSolder; Voltage 2V; LCSC C5556934
J17: Manual backup; PinHeader_1x03_P2.54mm_Vertical; LCSC C2915006; not fitted
JP10: Bypass JP; SolderJumper-2_P1.3mm_Bridged_RoundedPad1.0x1.5mm
Q13: NDS355AN; SOT-23; LCSC C236917
R101, R102: 270; R_0603_1608Metric_Pad0.98x0.95mm_HandSolder; LCSC C137754
R103: 1k; R_0603_1608Metric_Pad0.98x0.95mm_HandSolder; LCSC C22548
R104, R105, R106: 1k; R_0805_2012Metric_Pad1.20x1.40mm_HandSolder; LCSC C2441430

Connections of its further copies:
+3V3: R101.1; also elsewhere on the board
/abs: D27.1 (K), R102.1, R103.1; also elsewhere on the board
ABS_ActLO: J17.2, JP10.2 (B); also elsewhere on the board
BATT12V+: J17.3, R104.2, R105.2, R106.2; also elsewhere on the board
GND: D28.1 (K), J17.1, Q13.2 (S); also elsewhere on the board
unnamed: D27.2 (A), R101.2
unnamed: D28.2 (A), R102.2
unnamed: JP10.1 (A), Q13.3 (D), R104.1, R105.1, R106.1
unnamed: Q13.1 (G), R103.2

Notes on the sheet:
Strategy is that these are all the same circuitry, active high/low logic is handled at software level
Better to move to a Push-pull architecture ?
