martinroger/VXDash/KiCad PCB Files/VXDash_Emulator_lite/VXDash_Emulator.kicad_pcb

## KiCad design KiCad PCB Files/VXDash_Emulator_lite/VXDash_Emulator.kicad_pcb (continued)

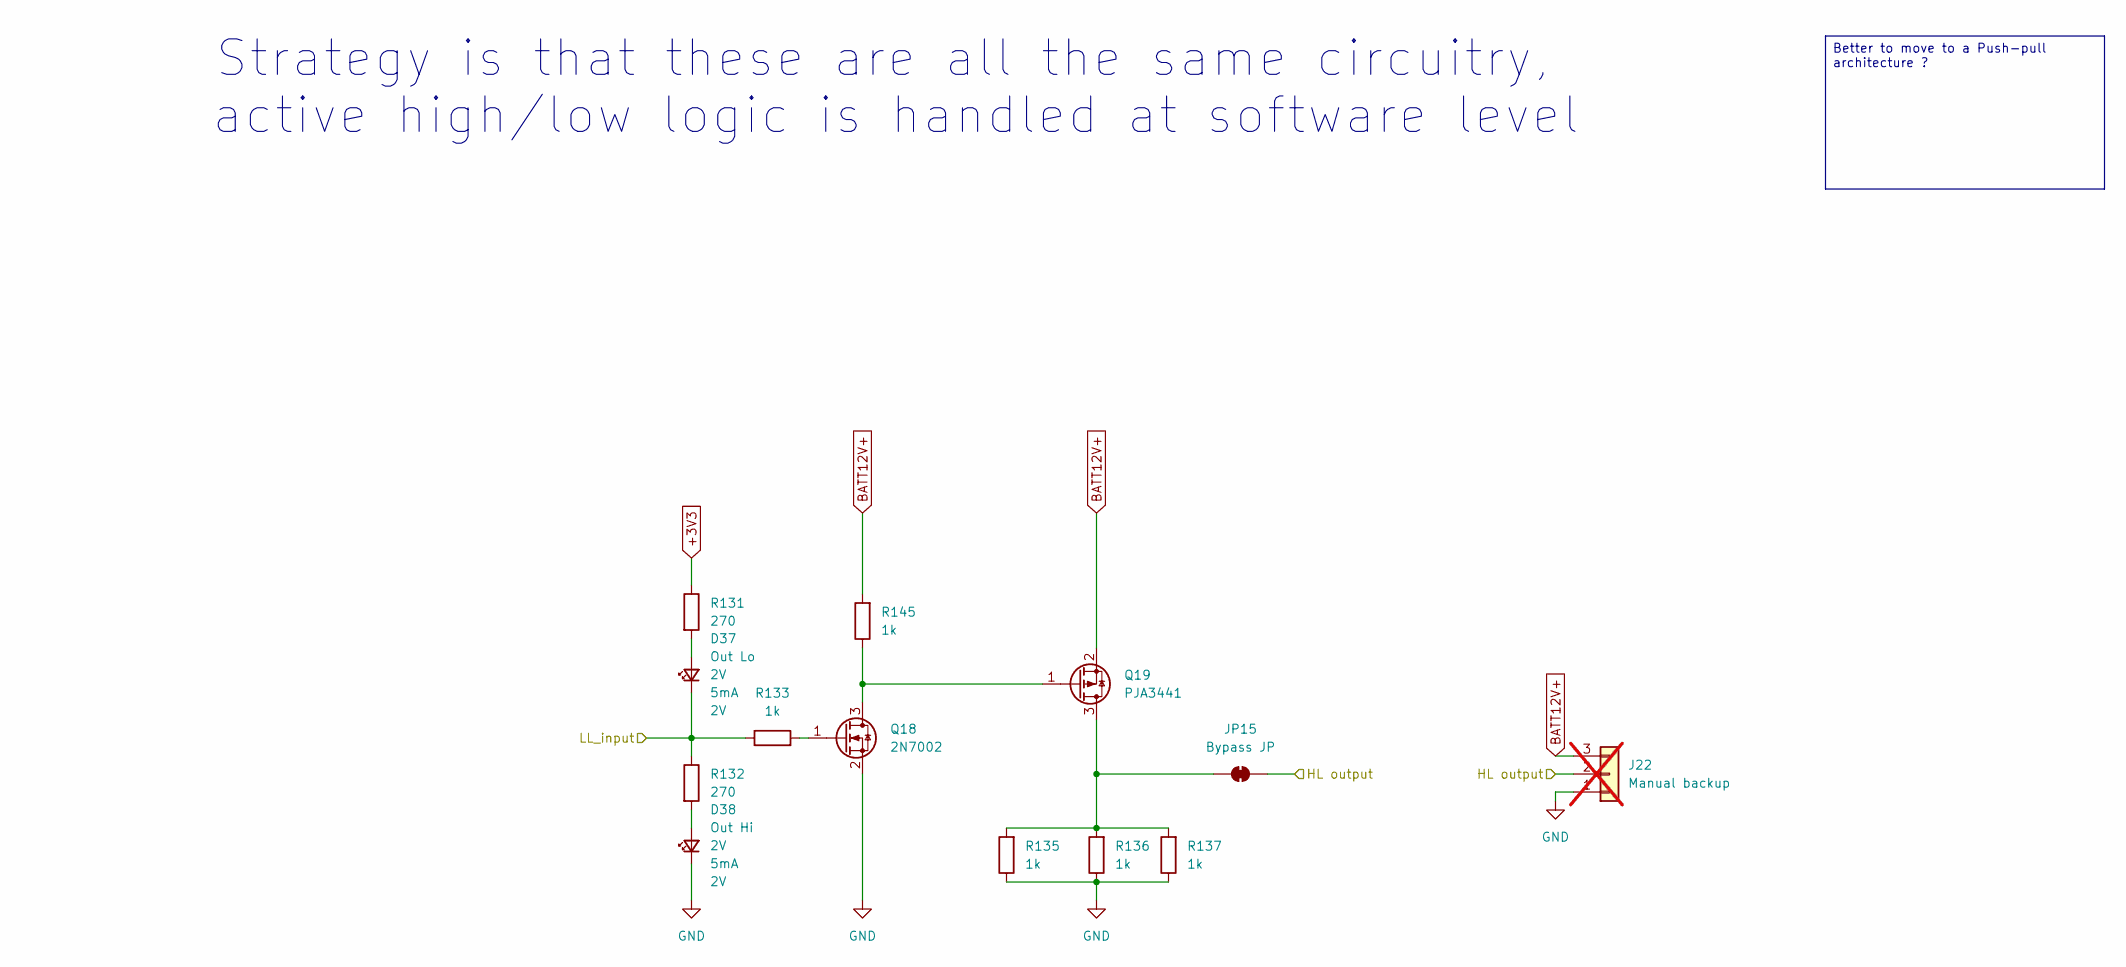
[picture p81: schematic PFET_Active_Hi_HP.kicad_sch, Main architecture]

Parts:
D37: Out Lo; LED_0603_1608Metric_Pad1.05x0.95mm_HandSolder; Voltage 2V; LCSC C5556934
D38: Out Hi; LED_0603_1608Metric_Pad1.05x0.95mm_HandSolder; Voltage 2V; LCSC C5556934
J22: Manual backup; PinHeader_1x03_P2.54mm_Vertical; LCSC C2915006; not fitted
JP15: Bypass JP; SolderJumper-2_P1.3mm_Bridged_RoundedPad1.0x1.5mm
Q18: 2N7002; SOT-23; LCSC C78712
Q19: PJA3441; SOT-23; LCSC C313504
R131, R132: 270; R_0603_1608Metric_Pad0.98x0.95mm_HandSolder; LCSC C137754
R133, R145: 1k; R_0603_1608Metric_Pad0.98x0.95mm_HandSolder; LCSC C22548
R135, R136, R137: 1k; R_0805_2012Metric_Pad1.20x1.40mm_HandSolder; LCSC C2441430

Connections:
+3V3: R131.1; also elsewhere on the board
/backlight: D37.1 (K), R132.1, R133.1; also elsewhere on the board
BATT12V+: J22.3, Q19.2 (S), R145.2; also elsewhere on the board
GND: D38.1 (K), J22.1, Q18.2 (S), R135.1, R136.1, R137.1; also elsewhere on the board
L_BEAM_ActHI: J22.2, JP15.2 (B); also elsewhere on the board
unnamed: D37.2 (A), R131.2
unnamed: D38.2 (A), R132.2
unnamed: JP15.1 (A), Q19.3 (D), R135.2, R136.2, R137.2
unnamed: Q18.3 (D), Q19.1 (G), R145.1
unnamed: Q18.1 (G), R133.2

Parts of its further copies:
D39: Out Lo; LED_0603_1608Metric_Pad1.05x0.95mm_HandSolder; Voltage 2V; LCSC C5556934
D40: Out Hi; LED_0603_1608Metric_Pad1.05x0.95mm_HandSolder; Voltage 2V; LCSC C5556934
J23: Manual backup; PinHeader_1x03_P2.54mm_Vertical; LCSC C2915006; not fitted
JP16: Bypass JP; SolderJumper-2_P1.3mm_Bridged_RoundedPad1.0x1.5mm
Q20: 2N7002; SOT-23; LCSC C78712
Q21: PJA3441; SOT-23; LCSC C313504
R142, R143: 270; R_0603_1608Metric_Pad0.98x0.95mm_HandSolder; LCSC C137754
R144, R185: 1k; R_0603_1608Metric_Pad0.98x0.95mm_HandSolder; LCSC C22548
R146, R147, R148: 1k; R_0805_2012Metric_Pad1.20x1.40mm_HandSolder; LCSC C2441430

Connections of its further copies:
+3V3: R142.1; also elsewhere on the board
/ignition: D39.1 (K), R143.1, R144.1; also elsewhere on the board
BATT12V+: J23.3, Q21.2 (S), R185.2; also elsewhere on the board
GND: D40.1 (K), J23.1, Q20.2 (S), R146.1, R147.1, R148.1; also elsewhere on the board
IGNITION_ActHI: J23.2, JP16.2 (B); also elsewhere on the board
unnamed: D39.2 (A), R142.2
unnamed: D40.2 (A), R143.2
unnamed: JP16.1 (A), Q21.3 (D), R146.2, R147.2, R148.2
unnamed: Q20.3 (D), Q21.1 (G), R185.1
unnamed: Q20.1 (G), R144.2

Notes on the sheet:
Strategy is that these are all the same circuitry, active high/low logic is handled at software level
Better to move to a Push-pull architecture ?

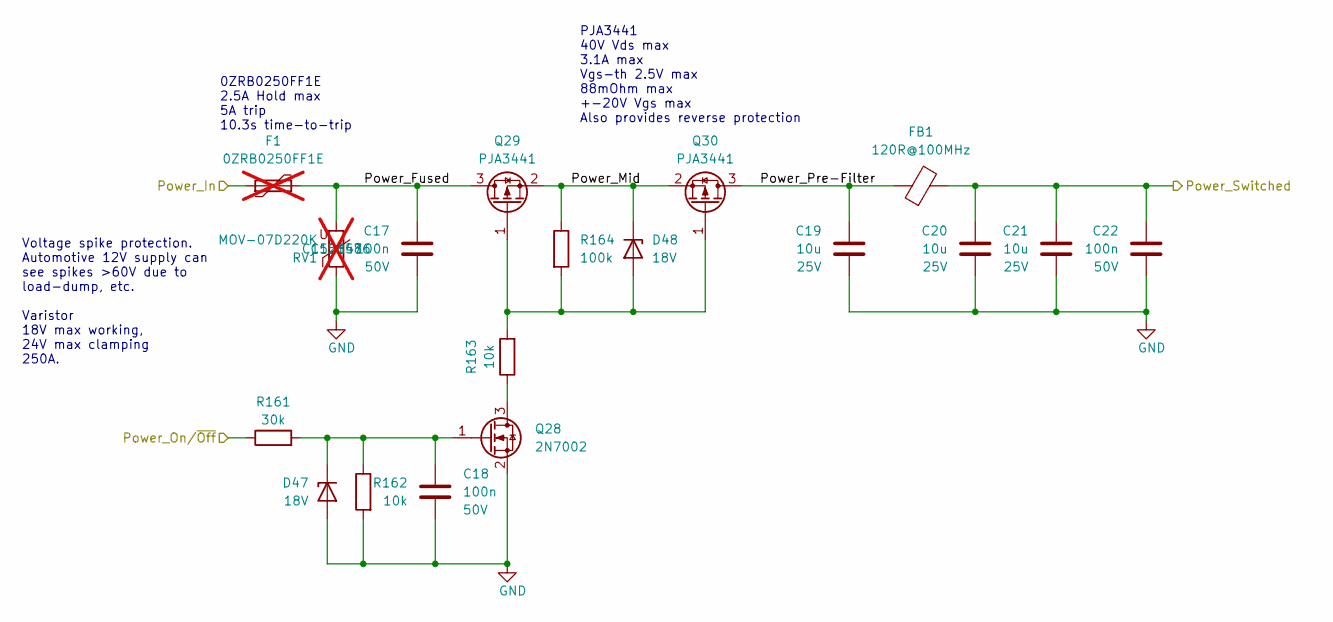
[picture p82: schematic Power_Input.kicad_sch, Main architecture]

Parts:
C17, C18, C22: 100n; C_0603_1608Metric_Pad1.08x0.95mm_HandSolder; Voltage 50V; LCSC C1591
C19, C20, C21: 10u; C_1206_3216Metric_Pad1.33x1.80mm_HandSolder; Voltage 25V; LCSC C14860
D47, D48: 18V; D_SOD-123; Voltage 18V; LCSC C668896
F1: 0ZRB0250FF1E; Fuse_BelFuse_0ZRE0033FF_L11.4mm_W3.8mm; LCSC C3761262; not fitted
FB1: 120R@100MHz; L_0805_2012Metric; LCSC C5120901
Q28: 2N7002; SOT-23; LCSC C78712
Q29, Q30: PJA3441; SOT-23; LCSC C313504
R161: 30k; R_0805_2012Metric_Pad1.20x1.40mm_HandSolder; LCSC C5856226
R162, R163: 10k; R_0603_1608Metric_Pad0.98x0.95mm_HandSolder; LCSC C2479067
R164: 100k; R_0603_1608Metric_Pad0.98x0.95mm_HandSolder; LCSC C237792
RV1: MOV-07D220K; RV_Disc_D9mm_W3.5mm_P5mm; LCSC C1528486; not fitted

Connections:
/POWER INPUT/Power_Fused: C17.2, F1.2, Q29.3 (D), RV1.2
/POWER INPUT/Power_Mid: D48.1 (K), Q29.2 (S), Q30.2 (S), R164.1
/POWER INPUT/Power_Pre-Filter: C19.2, FB1.1, Q30.3 (D)
BATT12V+: F1.1; also elsewhere on the board
GND: C17.1, C18.1, C19.1, C20.1, C21.1, C22.1, D47.2 (A), Q28.2 (S), R162.2, RV1.1; also elsewhere on the board
IGNITION_ActHI: R161.1; also elsewhere on the board
unnamed: C18.2, D47.1 (K), Q28.1 (G), R161.2, R162.1
unnamed: D48.2 (A), Q29.1 (G), Q30.1 (G), R163.2, R164.2
unnamed: Q28.3 (D), R163.1
Protected_12V: C20.2, C21.2, C22.2, FB1.2; also elsewhere on the board

Notes on the sheet:
PJA3441 40V Vds max 3.1A max Vgs-th 2.5V max 88mOhm max +-20V Vgs max Also provides reverse protection
Voltage spike protection. Automotive 12V supply can see spikes >60V due to load-dump, etc. Varistor 18V max working, 24V max clamping 250A.
0ZRB0250FF1E 2.5A Hold max 5A trip 10.3s time-to-trip

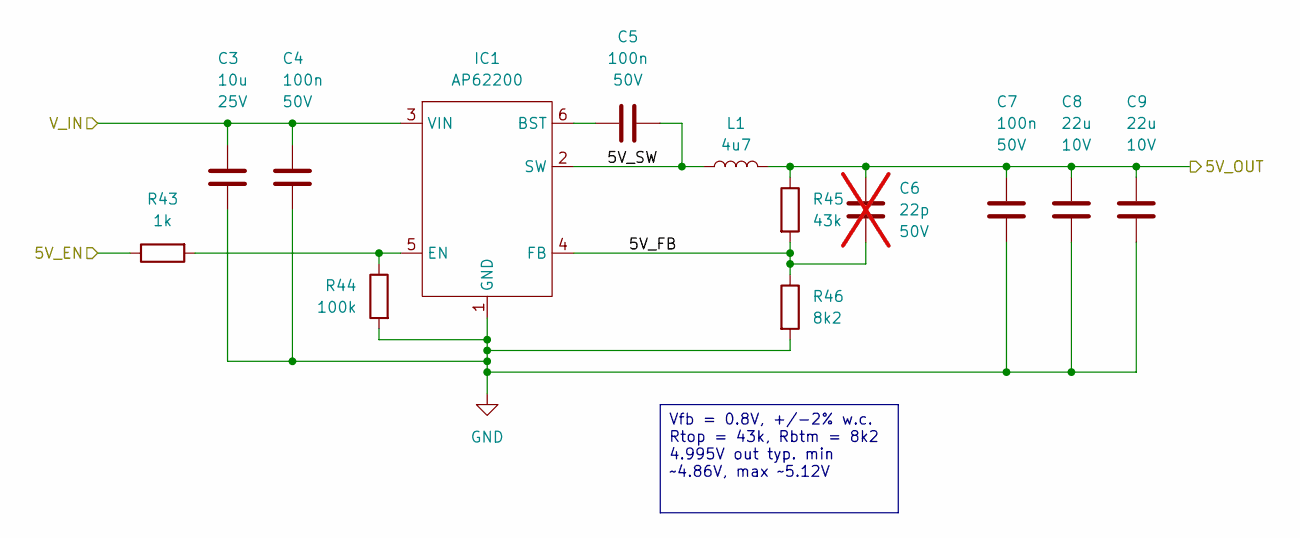
[picture p83: schematic 5V_SMPS.kicad_sch, Main architecture]

Parts:
C3: 10u; C_1206_3216Metric_Pad1.33x1.80mm_HandSolder; Voltage 25V; LCSC C14860
C4, C5, C7: 100n; C_0603_1608Metric_Pad1.08x0.95mm_HandSolder; Voltage 50V; LCSC C1591
C6: 22p; C_0603_1608Metric_Pad1.08x0.95mm_HandSolder; Voltage 50V; LCSC C597198; not fitted
C8, C9: 22u; C_1206_3216Metric_Pad1.33x1.80mm_HandSolder; Voltage 10V; LCSC C87996
IC1: AP62200; TSOT-23-6_HandSoldering; LCSC C1323282
L1: 4u7; Ind_5050; LCSC C2838218
R43: 1k; R_0603_1608Metric_Pad0.98x0.95mm_HandSolder; LCSC C22548
R44: 100k; R_0603_1608Metric_Pad0.98x0.95mm_HandSolder; LCSC C237792
R45: 43k; R_0603_1608Metric_Pad0.98x0.95mm_HandSolder; LCSC C137719
R46: 8k2; R_0603_1608Metric_Pad0.98x0.95mm_HandSolder; LCSC C114637

Connections:
/5V_SMPS_1/5V_FB: C6.2, IC1.4 (FB), R45.2, R46.1
/5V_SMPS_1/5V_OUT: C6.1, C7.2, C8.1, C9.1, L1.2, R45.1; also elsewhere on the board
/5V_SMPS_1/5V_SW: C5.1, IC1.2 (SW), L1.1
/5v_enable: R43.1; also elsewhere on the board
GND: C3.1, C4.1, C7.1, C8.2, C9.2, IC1.1 (GND), R44.2, R46.2; also elsewhere on the board
unnamed: C5.2, IC1.6 (BST)
unnamed: IC1.5 (EN), R43.2, R44.1
Protected_12V: C3.2, C4.2, IC1.3 (VIN); also elsewhere on the board

Notes on the sheet:
Vfb = 0.8V, +/-2% w.c. Rtop = 43k, Rbtm = 8k2 4.995V out typ. min ~4.86V, max ~5.12V

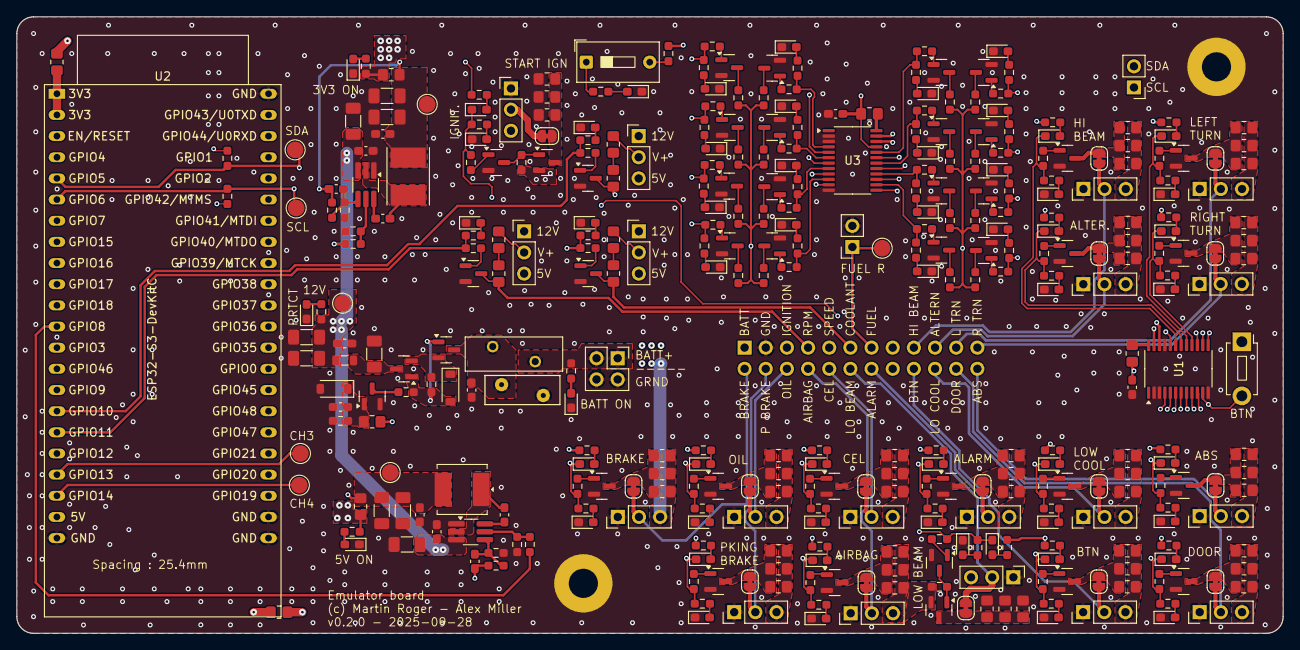
[picture p84: board VXDash_Emulator.kicad_pcb from above]

Board: 4 copper layers, 152.0 x 74.0 mm, 365 parts (1 on the bottom side), 218 nets.
