martinroger/VXDash/(commit log)

2023-04-07 Pre-PCB layout commit
    Footprints and special parts not included in Kicad project
    No PCB layout
    Netclasses not set up
    No code
    [12V_to_5V_AP63200WU-7.kicad_sch, 12V_to_5V_NR111E.kicad_sch, 5V_to_3V3_AZ1117CH.kicad_sch, 5V_to_3V3_MP2322GQH.kicad_sch, AnalogR_Divider.kicad_sch, AnalogR_Divider_HiR.kicad_sch, AnalogV_Divider.kicad_sch, ESP32.kicad_sch]
2023-04-07 Restored Samacsys parts footprints
    PCB components are not placed, just dropped in place
    [12V_to_5V_AP63200WU-7.kicad_sch, 5V_to_3V3_MP2322GQH.kicad_sch, AnalogR_Divider.kicad_sch, AnalogR_Divider_HiR.kicad_sch, AnalogV_Divider.kicad_sch, VXDash.kicad_pcb, VXDash.kicad_sch]
2023-04-07 WIP commit
    [12V_to_5V_AP63200WU-7.kicad_sch, 5V_to_3V3_MP2322GQH.kicad_sch, VXDash.kicad_pcb, VXDash.kicad_sch]
2023-04-09 V0 PCB Layout
    [12V_to_5V_AP63200WU-7.kicad_sch, AnalogV_Divider.kicad_sch, VXDash.kicad_pcb, VXDash.kicad_sch]
2023-04-10 Added Schematic PDF export
2023-04-10 Major update
    [VXDash.kicad_pcb, VXDash.kicad_sch]
2023-04-10 v1.0
    - First PCB layout publication
    - Titled schematics
    - Added Revisions to Schematics and PCB
    - iBOM release
    - PDF export of PCB design
    [12V_to_5V_AP63200WU-7.kicad_sch, 5V_to_3V3_MP2322GQH.kicad_sch, AnalogR_Divider.kicad_sch, AnalogR_Divider_HiR.kicad_sch, AnalogV_Divider.kicad_sch, ESP32.kicad_sch, Opto_ActHi.kicad_sch, Opto_ActLo.kicad_sch]
2023-04-14 Submodule kicad_libs
    [VXDash.step]
2023-04-16 Added thermal reliefs to GND
    [VXDash.kicad_pcb]
2023-04-16 Added more Thermal reliefs to the relays and varistor
    [VXDash.kicad_pcb]
2023-04-20 Power conversion split, work prep
    -3V3 supply now in parallel with 5V stage
    - Reorganisation of hierarchical sheets
    - WaterT sense is indeed a PWM so is singled out in the hierarchical sheet
    [12V_to_3V3_MP2322GQH.kicad_sch, VXDash.kicad_pcb, VXDash.kicad_sch, WaterTsense.kicad_sch]
2023-04-21 Added power input sch
    Added power input sheet.
    Relays removed.
    MOSFETs added for switching power.
    [Power_Input.kicad_sch, VXDash.kicad_sch]
2023-04-22 Update VXDash.kicad_sch
    Update TODO frame
    [VXDash.kicad_sch]
2023-04-22 PNP resistor sensing circuits
    Major updates :
    - PNP (BC807) based constant current supply-and-sense circuit for the passive resistor inputs
    Minor updates :
    - Added TODO for current consumption check on PNP-based circuits
    - Changed from French notation to British notation for resistance values
    [12V_to_5V_AP63200WU-7.kicad_sch, AnalogR_Divider.kicad_sch, AnalogR_Divider_HiR.kicad_sch, VXDash.kicad_sch]
2023-04-22 PCB adaptation
    - Updated footprints
    - Started grouping
    - Hid a few references
    [12V_to_5V_AP63200WU-7.kicad_sch, AnalogV_Divider.kicad_sch, ESP32.kicad_sch, Power_Input.kicad_sch, VXDash.kicad_pcb, VXDash.kicad_sch]
2023-04-22 Update VXDash.kicad_pcb
    Positioning of the PNP groups
    [VXDash.kicad_pcb]
2023-04-22 1.1HW and Schematics -> PR
    - Updated all dates in title blocks
    - Added both FET based new power supply and protection circuits - completely winged the zones
    - Completed PCB layout, passes DRCs --> Needs review
    - Updated PCB metadata
    - Relocated 5th mounting hole a bit
    - Regenerated interactive BOM
    [12V_to_3V3_MP2322GQH.kicad_sch, 12V_to_5V_AP63200WU-7.kicad_sch, AnalogR_Divider.kicad_sch, AnalogR_Divider_HiR.kicad_sch, AnalogV_Divider.kicad_sch, ESP32.kicad_sch, Opto_ActHi.kicad_sch, Opto_ActLo.kicad_sch]
2023-04-22 B06 renamed to BCKLIGHT
    [VXDash.kicad_pcb, VXDash.kicad_sch]
2023-04-24 Reassigned Water T sense to CMOS only in SCH
    [AnalogR_Divider.kicad_sch, AnalogR_Divider_HiR.kicad_sch, VXDash.kicad_sch]
2023-04-24 Replaced input capacitors before PS1
    [12V_to_5V_AP63200WU-7.kicad_sch, VXDash.kicad_sch]
2023-04-24 Corrected power input filter
    Connection was incorrect in power input filter.
    [Power_Input.kicad_sch]
2023-04-24 Updated 5V switching reg circuit
    - Changed input and output capacitors.
    - Modified EN and FB resistor values to match datasheet calculations.
    - Changed inductor to higher current rated part.
    [12V_to_5V_AP63200WU-7.kicad_sch]
2023-04-24 PCB updates for power input and 5V regulator
    Updated footprints and PCB layout for new power input and modified 5V switching regulator.
    [12V_to_5V_AP63200WU-7.kicad_sch, VXDash.kicad_pcb]
2023-04-24 Update VXDash.kicad_pcb
    Implemented current schematic changes
    Capacitors near PS1
    Capacitors for Water T sense
    Water T sense relocated to the CMOS
    [VXDash.kicad_pcb]
2023-04-24 Consolidated merges
    [VXDash.kicad_pcb]
2023-04-24 Continued merge of both branches
    Cleaned up PCB, extended 10mm to the right and pushed the power conversion stages to the right of the board.
    Left Resistive sensors out in the open as they will be changed, increased available real estate for resistive sensor
    [12V_to_3V3_MP2322GQH.kicad_sch, 12V_to_5V_AP63200WU-7.kicad_sch, AnalogR_Divider.kicad_sch, AnalogR_Divider_HiR.kicad_sch, AnalogV_Divider.kicad_sch, ESP32.kicad_sch, Opto_ActHi.kicad_sch, Opto_ActLo.kicad_sch]
2023-04-30 Added first draft of Op-amp based circuitry
    Also some rationalisation of the components to avoid near-duplicates (e.g. 0.1uF 50V caps)
    [12V_to_3V3_MP2322GQH.kicad_sch, 12V_to_5V_AP63200WU-7.kicad_sch, AnalogR_Divider.kicad_sch, AnalogR_Divider_HiR.kicad_sch, AnalogV_Divider.kicad_sch, ESP32.kicad_sch, Opto_ActHi.kicad_sch, Opto_ActLo.kicad_sch]
2023-04-30 Added PDF schematic for reference
2023-05-07 Fonts reshape
    Stress testing might be a bit too stress intensive, so next stages are :
    - [ ] Implementing quantization
    - [ ] Implementing limited Serial traffic
2023-05-12 Minor SW release
    - Added foundation functions and debug mode
    - Renamed some ESP32 inputs
    - Completed some SMD footprints that were missing
    PCB update to be done
    [12V_to_5V_AP63200WU-7.kicad_sch, AnalogV_Divider.kicad_sch, ESP32.kicad_sch, Power_Input.kicad_sch, Rsensing_Pair.kicad_sch, VXDash.kicad_sch]
2023-05-14 Minor corrections
    Some mistqkes in INO
    Added the touch debug flag
    [VXDash.ino]
2023-05-14 PCB layout update 1.2.1
    Updated with OpAmp circuitry plus some component identification
    [12V_to_3V3_MP2322GQH.kicad_sch, 12V_to_5V_AP63200WU-7.kicad_sch, AnalogR_Divider.kicad_sch, AnalogR_Divider_HiR.kicad_sch, AnalogV_Divider.kicad_sch, ESP32.kicad_sch, Opto_ActHi.kicad_sch, Opto_ActLo.kicad_sch]
2023-05-16 Squashed commit of the following:
    commit 5d265e0e6d749114a68b27b45df218b106b0dda5
    Author: Martin <martin.roger@me.com>
    Date: Sun May 14 20:34:43 2023 +0200
    PCB layout update 1.2.1
    commit e510fc9f0677414791fc51d243bf00155fb26728
    Author: Martin <martin.roger@me.com>
    Date: Sun May 14 14:19:23 2023 +0200
    Minor corrections
    commit 39b8eb1dd0c73808717710d3ae2345f3cfa5b5d1
    Author: Martin <martin.roger@me.com>
    Date: Fri May 12 23:38:18 2023 +0200
    Minor SW release
    - Compl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
    [12V_to_3V3_MP2322GQH.kicad_sch, 12V_to_5V_AP63200WU-7.kicad_sch, AnalogR_Divider.kicad_sch, AnalogR_Divider_HiR.kicad_sch, AnalogV_Divider.kicad_sch, ESP32.kicad_sch, Opto_ActHi.kicad_sch, Opto_ActLo.kicad_sch]
2023-05-16 Updated OpAmp CC circuit
    Used MOSFET instead of BJT.
    Reduced Vref to 100mV to increase headroom.
    [Rsensing_Pair.kicad_sch]
2023-05-20 Comments
    @Alex-XNR
    Just confirmed with comments to educate me.
    I think the only point that remains open is the question of Rf and Ri ? I can't remember where I saw they were included and I can't see, to find anymore.
    For the higher resistance I/O I think I will try with a higher Iset resistor ? With my crappy simulator it seems to run.
    [12V_to_5V_AP63200WU-7.kicad_sch, AnalogV_Divider.kicad_sch, ESP32.kicad_sch, Power_Input.kicad_sch, R-KRsensing_Pair.kicad_sch, Rsensing_Pair.kicad_sch, VXDash.kicad_sch]
2023-05-20 Minor PCB changes
    [VXDash.kicad_pcb]
2023-05-20 Externalised the Iset resistor
    [Rsensing_Pair.kicad_sch, VXDash.kicad_sch]
2023-05-23 Updated 12V to 3V3
    Simplified 12V to 3V3 switcher
    [12V_to_3V3_MP2322GQH.kicad_sch]
2023-05-23 Updated opamp footprint
    [Rsensing_Pair.kicad_sch]
2023-05-23 PCB update
    Includes 12V switcher updates plus other tweaks and additional ground stitching
    [VXDash.kicad_pcb]
2023-05-23 GND fill thermal reliefs
    Changed the GND plane fill to thermal relief to aid manufacture
    [VXDash.kicad_pcb]
2023-05-27 Housekeeping update - 1.2.2
    Version numbers updated to 1.2.2 for the schematic and PCB
    Components identified, datasheet and descriptions updated
    iBOM regenerated
    PCB plots regenerated
    PCB :
    - only thermal reliefs on PTH, not on SMD pads
    - couple GND islands taken care of
    - couple rationalisations on the 3v3 rails
    [12V_to_3V3_MP2322GQH.kicad_sch, 12V_to_5V_AP63200WU-7.kicad_sch, AnalogV_Divider.kicad_sch, ESP32.kicad_sch, Opto_ActHi.kicad_sch, Opto_ActLo.kicad_sch, Power_Input.kicad_sch, Rsensing_Pair.kicad_sch]
2023-05-27 Reverted GND plane thermal reliefs
    Everyone gets thermal reliefs... you get thermal reliefs, YOU GET THERMAL RELIEFS !
    [VXDash.kicad_pcb]
2023-06-18 Minor corrections
    - C35 and C36 were swapped on the silkscreen
    - RV1 holes were too small, enlarged to 0.85mm
    - Regenerated BOM and schematic files
    - Updated HMI and Code to latest versions from benchboard
    [12V_to_3V3_MP2322GQH.kicad_sch, 12V_to_5V_AP63200WU-7.kicad_sch, AnalogV_Divider.kicad_sch, ESP32.kicad_sch, Opto_ActHi.kicad_sch, Opto_ActLo.kicad_sch, Power_Input.kicad_sch, Rsensing_Pair.kicad_sch]
2023-06-18 Minor changes, ADC correction
    - R4 ADC pin was not correctly set
    - logic on the overheat lamp
    [VXDash.ino]
2023-07-01 HMI adaptation + serial debug
    - HMI showing raw values
    - Pulsator with normal serial
    - Duty Cycle pot enabled 20 -> 80
    - ESP sends raw values but not scaled currently
2023-07-01 Update VXDash.ino
    Introduction of raw values with correct type, sent to screen.
    [VXDash.ino]
2023-07-09 Update VXDash.ino
    Introducing timers
2023-09-02 Speed estimation implementation
    Basic implementation of reciprocate (time period) speed estimation.
    Requires filtering, and possibly a different branch exploring pulse counting instead (every 100ms or so and some exit condition if three times 0 new pulses counted)
    Interrupt created for both speed and RPM
    Still need to study for the water PWM
2023-09-03 Update VXDash.ino
    Added implementation for RPM, tried to stabilise with pulldowns but it doesn't really change anything
    [VXDash.ino]
2023-09-03 Added Simple Moving Average filters
    Surely more elegant things can be done.
    Will branch from here to make a pulse_count version
2023-09-03 Implemented based on pulse counting
    More stable
    RPM steps up every 30 RPM -> Map over 50's ?
    Missing Water check
    Some doubts on stability of pulse generators
    [VXDash.ino]
2023-09-04 Multiple issues !! Read comment
    Counter_3 moved to non-ADC GPIO18
    Moved away from trying to put two ISRs on the same pin (you would think the IDE tells you off...)
    Tried GPIO4 for Counter3 but seemed to perturbate ADC2 for the high KR analog
    Should retry with the sorted double interrupt but no guarantee this will resolve things
    Updated schematics with currently GPIO4, may need to move to GPIO18 also in schematics and PCB and kill one of the digitals
    [12V_to_3V3_MP2322GQH.kicad_sch, 12V_to_5V_AP63200WU-7.kicad_sch, AnalogV_Divider.kicad_sch, ESP32.kicad_sch, Opto_ActHi.kicad_sch, Opto_ActLo.kicad_sch, Power_Input.kicad_sch, Rsensing_Pair.kicad_sch]
2024-04-27 Updated schematic and code
    GPIO4 is reenabled but subject to suspicions
    Schematic is updated, PCB is not.
    [ESP32.kicad_sch]
2024-04-29 PCB update
    To reflect pin reassignments
    [12V_to_3V3_MP2322GQH.kicad_sch, 12V_to_5V_AP63200WU-7.kicad_sch, AnalogV_Divider.kicad_sch, ESP32.kicad_sch, Opto_ActHi.kicad_sch, Opto_ActLo.kicad_sch, Power_Input.kicad_sch, Rsensing_Pair.kicad_sch]
2024-04-29 Create Calibration reference.xlsx
    Documenting the excessive current through the Rsense...
    [Calibration reference.xlsx]
2024-04-30 Updated LTSpice OpAmp circuit simulation
    Went and plonked a non-ideal LM358 OpAmp model. Suspicion is that the Common mode voltage is too close so it is non-linear above 80Ohm (which corroborates the observations from before.
    Suggestions of correction :
    - Change OPAMP with tighter common mode voltage limit
    - Change supply voltage of OPAMP to 7V and above -> Risky business
    - Change Rset and Vref to something lower. Ideally could go down to Vref at 3V and would lose a little bit of resolution between 3V and V3 but could also lose the voltage divider (5.1K and 2.7K) thus reducing stray current .
    In any case upload a V2 of the circuit with those different options
2024-04-30 Added simulations for OpAmp circuitry
2024-10-05 Trip and Odo
    Added trip and odometer readings to the pulse counters
    Some issues with the MUX on the bench
    Added force-reset of the screen
    Need to clean up the schematics
2024-10-05 Replaced resistors and OpAmp
    [Rsensing_Pair.kicad_sch, VXDash.kicad_pcb]
2024-10-05 Versioning and bom
    [12V_to_3V3_MP2322GQH.kicad_sch, 12V_to_5V_AP63200WU-7.kicad_sch, AnalogV_Divider.kicad_sch, ESP32.kicad_sch, Opto_ActHi.kicad_sch, Opto_ActLo.kicad_sch, Power_Input.kicad_sch, Rsensing_Pair.kicad_sch]
2024-10-06 Using calibratred AnalogReadMilliVolts
    [AnalogV_Divider.kicad_sch, Rsensing_Pair.kicad_sch]
2024-10-06 Update main.cpp
    Clamping free floating outputs to GND via DigitalWrite to avoid ADC noise.
2024-10-06 1.3.1 Decoupling capacitors on the ADC inputs
    [12V_to_3V3_MP2322GQH.kicad_sch, 12V_to_5V_AP63200WU-7.kicad_sch, AnalogV_Divider.kicad_sch, ESP32.kicad_sch, Opto_ActHi.kicad_sch, Opto_ActLo.kicad_sch, Power_Input.kicad_sch, Rsensing_Pair.kicad_sch]
2024-10-06 Updated schematics and PCB layout for release board
    [Power_Input.kicad_sch, VXDash.kicad_pcb]
2024-10-06 Thermal reliefs on ground plane
    [VXDash.kicad_pcb]
2024-10-11 Update platformio.ini
    ArduinoFilters update
2025-03-09 Restarting project + trinity
    [12V_to_3V3_MP2322GQH.kicad_sch, 12V_to_5V_AP63200WU-7.kicad_sch, 12V_to_5V_NR111E.kicad_sch, 5V_to_3V3_AZ1117CH.kicad_sch, 5V_to_3V3_MP2322GQH.kicad_sch, AnalogR_Divider.kicad_sch, AnalogR_Divider_HiR.kicad_sch, AnalogV_Divider.kicad_sch]
2025-03-10 Continuing migration
    [12V_to_3V3_MP2322GQH.kicad_sch, 12V_to_5V_AP63200WU-7.kicad_sch, AnalogV_Divider.kicad_sch, ESP32.kicad_sch, Opto_ActHi.kicad_sch, Opto_ActLo.kicad_sch, Power_Input.kicad_sch, Rsensing_Pair.kicad_sch]
2025-03-11 Removing copies
    [12V_to_3V3_MP2322GQH.kicad_sch, 12V_to_5V_AP63200WU-7.kicad_sch, 12V_to_5V_NR111E.kicad_sch, 5V_to_3V3_AZ1117CH.kicad_sch, 5V_to_3V3_MP2322GQH.kicad_sch, AnalogR_Divider.kicad_sch, AnalogR_Divider_HiR.kicad_sch, AnalogV_Divider.kicad_sch]
2025-03-11 Update PCB to V9
    [VXDash.kicad_pcb, VXDash.kicad_sch]
2025-07-15 Simulations for adjustable analog sensor Rset
2025-07-15 Added 3V3 Switchable CC supply simulation
2025-07-20 Repo clean up
    [Calibration reference.xlsx]
2025-07-20 WIP
    Main schematic re-layout.
    Updated 12V power input circuit.
    SMPS regulators changed.
    Updated analogue voltage circuit.
    [12V_to_3V3_MP2322GQH.kicad_sch, 12V_to_5V_AP63200WU-7.kicad_sch, 12V_to_5V_NR111E.kicad_sch, 3V3_SMPS.kicad_sch, 5V_SMPS.kicad_sch, 5V_to_3V3_AZ1117CH.kicad_sch, 5V_to_3V3_MP2322GQH.kicad_sch, AnalogV_Divider.kicad_sch]
2025-08-05 Schematic pre-review
    WIP - final TODOs needed before review
    [3V3_SMPS.kicad_sch, 5V_SMPS.kicad_sch, AnalogR_Divider.kicad_sch, AnalogR_Divider_HiR.kicad_sch, AnalogV_Divider.kicad_sch, Analogue.kicad_sch, ESP32.kicad_sch, EXT_Connector.kicad_sch]
2025-08-08 Moved VXDash project into sub folder
    [3V3_SMPS.kicad_sch, 5V_SMPS.kicad_sch, AnalogV_Divider.kicad_sch, Analogue.kicad_sch, ESP32.kicad_sch, Opto_ActHi.kicad_sch, Opto_ActLo.kicad_sch, Power_Input.kicad_sch]
2025-08-08 2 new projects. VXDash Connectors and VXDash RemoteECU
    [3V3_SMPS.kicad_sch, AnalogV_Divider.kicad_sch, Analogue.kicad_sch, ESP32.kicad_sch, Rsensing_Pair.kicad_sch, VXDash_Connectors.kicad_pcb, VXDash_Connectors.kicad_sch, VXDash_RemoteECU.kicad_pcb]
2025-08-09 Minor updates
    - Coolant LOW actually tests as an Active Hi
    - ReadME file nuked
    - Minor updates
    [VXDash.kicad_sch]
2025-08-09 SymLink to the LIB folder
    Adding a symbolic link to the Lib folder like such :
    ${VXDASH_LIB}/footprints/VXDash_inductors.pretty
2025-08-09 Grape shot additions
    - Added 0R to the VCC pin on the CAN transceiver for pin compatibility with other transceiver
    - Updated TODO box
    - Rename ADC_SDA and ADC_SCL to SDA and SCL
    - Official symbol and footprint from ESP, using ESP32-S3-WROOM-1-N16R8
    - Reassigned Coolant LOW to active HI
    - Replaced MUX with i²C TCA9555 IO Expander
    - Resequenced Active His and Lows to match current SW definition
    - Resequenced ADC channels to match current SW definition
    - Added simple peripherals for MCU
    - Added RESET and BOOT buttons circuits
    - Added CAN transceivers for each display, and Termination resistor
    - Added USB C
    [3V3_SMPS.kicad_sch, 5V_SMPS.kicad_sch, AnalogV_Divider.kicad_sch, Analogue.kicad_sch, Opto_ActHi.kicad_sch, Opto_ActLo.kicad_sch, Power_Input.kicad_sch, Rsensing_Pair.kicad_sch]
2025-08-09 Minor changes
    - Connection for the caliber selection on the sensing circuit
    - Typo
    [Analogue.kicad_sch, Rsensing_Pair.kicad_sch, VXDash.kicad_sch]
2025-08-09 Removing external 5V and replacing with 12VBatt
    For the sake of running 4 wires to the back that have +12V/CANH/CANL/GND
    [VXDash_Connectors.kicad_sch]
2025-08-10 More changes (Primarily Remote ECU)
    - Emulator board project to a functional skeleton
    - Connectors board with ignition routing on CAN pin 4 to have switched signal available in the harness.
    - Remote ECU : added 12V reduced protection circuit (to be reviewed)
    - Remote ECU : Removed integrated CAN termination (should be on harness)
    - Remote ECU : added CAN passthrough
    - Remote ECU : added MCPWM channels
    - Remote ECU : Added some opto inputs
    - Remote ECU : Added internal USB C (overkill ?)
    [3V3_SMPS.kicad_sch, 5V_SMPS.kicad_sch, AnalogV_Divider.kicad_sch, Analogue.kicad_sch, ESP32.kicad_sch, Opto_ActHi.kicad_sch, Opto_ActLo.kicad_sch, Power_Input.kicad_sch]
2025-08-10 Emulator board refinements
    - Is there stupid with the Active Hi Optos so that the logic is not inverted ?
    - Added N-Mosfet activatable resistors. Stupidly simple ? Better MOSFET recommendation ?
    [Opto_ActHi.kicad_sch, Opto_ActLo.kicad_sch, Switchable_Res.kicad_sch, VXDash_Emulator.kicad_sch]
2025-08-13 PCB layout in progress
    Changed some pin assignments to aid routing.
    [3V3_SMPS.kicad_sch, 5V_SMPS.kicad_sch, AnalogV_Divider.kicad_sch, Analogue.kicad_sch, Opto_ActHi.kicad_sch, Opto_ActLo.kicad_sch, Power_Input.kicad_sch, Rsensing_Pair.kicad_sch]
2025-08-14 Connectors packaging and additions to main board
    - DXF file for connector packaging and NO go zones on main PCB (see PR #41 notes )
    - Additional internal connectors for UART access to the display boards
    - DNP capacitor on EN. Good idea ?
    [Interface board PCB envelope - PCB outline.dxf, VXDash.kicad_pcb, VXDash.kicad_sch, VXDash_Connectors.kicad_pcb, VXDash_Connectors.step]
2025-08-14 ESP32S3 Reference footprint
    - VXDash : updating footprint to Espressif's official one.
    [VXDash.kicad_pcb]
2025-08-14 ERC corrections, idiot lights
    - VXDash : added idiot lights (also to emulator board)
    - VXDash : corrected some ERC violations
    [3V3_SMPS.kicad_sch, 5V_SMPS.kicad_sch, Analogue.kicad_sch, Opto_ActHi.kicad_sch, Opto_ActLo.kicad_sch, Power_Input.kicad_sch, Rsensing_Pair.kicad_sch, Switchable_Res.kicad_sch]
2025-08-14 Emulator : ERC and footprints
    Also moving some 0402 capacitors to 0603...
    [3V3_SMPS.kicad_sch, 5V_SMPS.kicad_sch, Opto_ActHi.kicad_sch, Opto_ActLo.kicad_sch, Power_Input.kicad_sch, Switchable_Res.kicad_sch, VXDash_Emulator.kicad_sch]
2025-08-14 Emulator : power stages layout
    [VXDash_Emulator.kicad_pcb]
2025-08-19 Emulator : resistance banks layout
    [VXDash_Emulator.kicad_pcb, VXDash_Emulator.kicad_sch]
2025-08-19 Additional TP for Emulator board
    [Opto_ActLo.kicad_sch, VXDash_Emulator.kicad_pcb]
2025-08-19 Emulator : groupings
    [VXDash_Emulator.kicad_pcb]
2025-08-19 Emulator board : layout update
    - Moved to Open Drain style Mosfets instead of Optoisolators
    - Added manual push button for BUTTON
    - Did groups in the PCB layout
    [FET_Active_Hi.kicad_sch, VXDash_Emulator.kicad_pcb, VXDash_Emulator.kicad_sch]
2025-08-20 Emulator - block layout complete
    [VXDash_Emulator.kicad_pcb, VXDash_Emulator.kicad_sch]
2025-08-20 Emulator board basic routing done
    [VXDash_Emulator.kicad_pcb, VXDash_Emulator.kicad_sch]
2025-08-20 Emulator board : DRC pass, review
    [VXDash_Emulator.kicad_sch]
2025-08-22 Minor changes before weekend review
    - 1K resistances on PWM NMOS upped to 0805 and 250mW (consistent with the limiters for the telltales OD outputs
    - Rerouted SCL SDA and ign-en around and away from the 3V3 group, plus a couple stitching vias.
    [VXDash_Emulator.kicad_sch]
2025-08-29 Emulator : layout and stitching
    [VXDash_Emulator.kicad_sch]
2025-08-31 Emulator board : BOM and fab prep
    [3V3_SMPS.kicad_sch, 5V_SMPS.kicad_sch, FET_Active_Hi.kicad_sch, Power_Input.kicad_sch, Switchable_Res.kicad_sch, VXDash_Emulator.kicad_sch]
2025-08-31 Emulator : LCSC part numbers and production files
    [3V3_SMPS.kicad_sch, 5V_SMPS.kicad_sch, FET_Active_Hi.kicad_sch, Power_Input.kicad_sch, Switchable_Res.kicad_sch, VXDash_Emulator.kicad_sch]
2025-09-01 Emulator : Updating BOM with LCSC alts
    [3V3_SMPS.kicad_sch, 5V_SMPS.kicad_sch, FET_Active_Hi.kicad_sch, Power_Input.kicad_sch, Switchable_Res.kicad_sch, VXDash_Emulator.kicad_sch]
2025-09-14 Schematic cleanliness update
    [3V3_SMPS.kicad_sch, 5V_SMPS.kicad_sch, FET_Active_Hi.kicad_sch, Power_Input.kicad_sch, Switchable_Res.kicad_sch, VXDash_Emulator.kicad_sch]
2025-09-19 Emulator : minor correction and BOM update
    [3V3_SMPS.kicad_sch, 5V_SMPS.kicad_sch, FET_Active_Hi.kicad_sch, Power_Input.kicad_sch, Switchable_Res.kicad_sch, VXDash_Emulator.kicad_sch]
2025-09-19 Emulator : net naming convention consistency
    [VXDash_Emulator.kicad_sch]
2025-09-24 Added smaller DT connector to connector board
    [VXDash_Connectors.kicad_pcb, VXDash_Connectors.kicad_sch, VXDash_Connectors.step]
2025-09-27 Corrections - v0.2.0
    - P-MOSFET driven ignition output
    - ABS and alternator swapped for higher sink capability NMOSFET
    - Board pitch corrected
    - Button overrides to correct polarity
    [3V3_SMPS.kicad_sch, 5V_SMPS.kicad_sch, FET_Active_Hi.kicad_sch, FET_Active_Hi_HP.kicad_sch, PFET_Active_Hi_HP.kicad_sch, Power_Input.kicad_sch, Switchable_Res.kicad_sch, VXDash_Emulator.kicad_sch]
2025-10-01 Mini CAD reference files
    [Original cluster.step]
2025-10-01 New main dash PCB - WIP inc. CAD
    [3V3_SMPS.kicad_sch, 5V_SMPS.kicad_sch, AnalogV_Divider.kicad_sch, Analogue.kicad_sch, Opto_ActHi.kicad_sch, Opto_ActLo.kicad_sch, Power_Input.kicad_sch, Rsensing_Pair.kicad_sch]
2025-10-03 Create Annotated BackFace DXF.dxf
    [Annotated BackFace DXF.dxf]
2025-10-11 Sink resistors sizing, standard sink hier. sheet
    - Sink resistors resized for observed currents
    - Added hierarchical sheet for standard 17mA @ 13V sink
    [Telltale load emulation.kicad_sch, VXDash.kicad_sch]
2025-10-13 Large schematic update
    - Fascia pass-through connector
    - Load emulators for all but turn signals
    - Test points
    - Additional caps for decoupling
    - Regrouped display connectors in single unit
    - Added CAN debug connector
    [Analogue.kicad_sch, Telltale load emulation.kicad_sch, VXDash.kicad_sch]
2025-10-13 Added telltale consumption table
    [VXDash.kicad_sch]
2025-10-14 Added TLs load emulator
    50mA and sinking into one another
    [Telltale load emulation.kicad_sch, VXDash.kicad_sch]
2025-10-14 Fields updates
    [3V3_SMPS.kicad_sch, 5V_SMPS.kicad_sch, AnalogV_Divider.kicad_sch, Analogue.kicad_sch, Opto_ActHi.kicad_sch, Opto_ActLo.kicad_sch, Power_Input.kicad_sch, Rsensing_Pair.kicad_sch]
2025-10-14 BOM first pass
    - Still missing some internal connectors definitions
    - Alternative to use a 4x4ch opto config instead of 16x1 ?
    - Alternative LiteOn optos identified (easier to source on LCSC)
    [3V3_SMPS.kicad_sch, 5V_SMPS.kicad_sch, AnalogV_Divider.kicad_sch, Analogue.kicad_sch, Opto_ActHi.kicad_sch, Opto_ActLo.kicad_sch, Power_Input.kicad_sch, Rsensing_Pair.kicad_sch]
2025-10-15 Connector BOM, reference outline
    - JST connectors added to BOM, arbitrary connections (will probably need remapping)
    - BOM should roughly be complete as is (at least footprints-wise)
    - Reference DXF and PDF added for outlines and display positions
    [Annotated BackFace DXF.dxf, VXDash.kicad_pcb, VXDash.kicad_sch]
2025-10-15 PCB refresh from schematic
    [VXDash.kicad_pcb]
2025-10-16 Pre-grouping phase 1
    [USBC.kicad_sch, VXDash.kicad_pcb, VXDash.kicad_sch]
2025-10-16 Pre-grouping phase 2
    It's tight yo
    [VXDash.kicad_pcb, VXDash.kicad_sch]
2025-10-17 Group layouts
    Multichannel feature is pesky
    [VXDash.kicad_pcb]
2025-10-20 Form-fitting PCB outline
    [Spider clamp approach - PCB outline.dxf, VXDash.kicad_pcb]
2025-10-25 Finer placement
    [VXDash.kicad_pcb, VXDash.kicad_sch]
2025-10-25 Advanced layout
    [VXDash.kicad_pcb, VXDash.kicad_sch]
2025-10-26 Primary layout done
    - No ground stitching or pours
    - Board edges to revise
    - DRC to check
    - BOM exclusions to check
    [Analogue.kicad_sch, VXDash.kicad_pcb, VXDash.kicad_sch]
2025-10-27 OpAmp reversal corrected + LTSpice
    - Need to relayout PCB
    - OpAmp LT Spice model
    [3V3_SMPS.kicad_sch, 5V_SMPS.kicad_sch, AnalogV_Divider.kicad_sch, Analogue.kicad_sch, Opto_ActHi.kicad_sch, Opto_ActLo.kicad_sch, Power_Input.kicad_sch, Rsensing_Pair.kicad_sch]
2025-10-27 Corrected OpAmp routing + more sims
    [VXDash.kicad_pcb, VXDash.kicad_sch]
2025-10-28 Track repairs (0 length segments)
    [VXDash.kicad_pcb]
2025-10-28 AC and noise studies for power switching stage
2025-10-28 New PCB outline
    - Corrected small issues with solder expansion mask
    - Ground pour in place but no ground stitching
    - No Silkscreen texts
    [VXDash.kicad_sch, VXDash_intermediate - Filleted PCB Outline.dxf, VXDash_intermediate - New PCB outline.dxf, VXDash_intermediate.step]
2025-11-01 Alpha version of the board step for CAD integration
2025-11-05 Minor updates
    [Opto_ActHi.kicad_sch, Opto_ActLo.kicad_sch]
2025-11-06 Alternative OpAmp
    [Rsensing_Pair.kicad_sch]
2025-11-09 Adding lite variant of the emulator to save on components
    [3V3_SMPS.kicad_sch, 5V_SMPS.kicad_sch, AnalogV_Divider.kicad_sch, Analogue.kicad_sch, ESP32.kicad_sch, FET_Active_Hi.kicad_sch, FET_Active_Hi_HP.kicad_sch, Opto_ActHi.kicad_sch]
2025-12-06 Corrections from build
    [3V3_SMPS.kicad_sch, 5V_SMPS.kicad_sch, AnalogV_Divider.kicad_sch, Analogue.kicad_sch, Opto_ActHi.kicad_sch, Opto_ActLo.kicad_sch, Power_Input.kicad_sch, Rsensing_Pair.kicad_sch]
2026-01-10 Create FDM Enclosure for v0.2F.step
    [FDM Enclosure for v0.2.step]
2026-01-11 Preliminary circuit and PCB placement
    Simple circuit to power a self-driven buzzer when the lights are on, ignition off and door open.
    [3V3_SMPS.kicad_sch, 5V_SMPS.kicad_sch, AnalogV_Divider.kicad_sch, Analogue.kicad_sch, Buzzer.kicad_sch, Opto_ActHi.kicad_sch, Opto_ActLo.kicad_sch, Power_Input.kicad_sch]
2026-01-12 Minor PR updates
    - Updated revision number in schematic
    - Minor change of track layout to avoid ground island
    - DRC OK and ERC OK
    - Removed stale notes from schematic
    - Updated PCB silkscreen
    [3V3_SMPS.kicad_sch, 5V_SMPS.kicad_sch, AnalogV_Divider.kicad_sch, Analogue.kicad_sch, Buzzer.kicad_sch, Opto_ActHi.kicad_sch, Opto_ActLo.kicad_sch, Power_Input.kicad_sch]
2026-01-25 VXDash MinBuild start
    [3V3_SMPS.kicad_sch, 5V_SMPS.kicad_sch, AnalogV_Divider.kicad_sch, Analogue.kicad_sch, ESP32.kicad_sch, Interface board PCB envelope - PCB outline.dxf, Opto_ActHi.kicad_sch, Opto_ActLo.kicad_sch]
2026-01-25 Manual Mini Build BOM
    [3V3_SMPS.kicad_sch, 5V_SMPS.kicad_sch, AnalogV_Divider.kicad_sch, Analogue.kicad_sch, Opto_ActHi.kicad_sch, Opto_ActLo.kicad_sch, Power_Input.kicad_sch, Rsensing_Pair.kicad_sch]
2026-01-25 Internal harness schematic added for quotation
    [Internal harness.kicad_sch]
2026-01-25 Emulator lite STEP file reference
    [VXDash_Emulator.step]
2026-02-10 Generating HTML bom correctly
    [VXDash_MinBuild.kicad_pcb]
2026-02-11 LCSC alt update
    [3V3_SMPS.kicad_sch, VXDash_MinBuild.kicad_pcb]
2026-02-25 BOOT P-UP res, lower CAP
    Lowered optional debounce cap on BOOT, added external pull-up (10k)
    Resolves #60 in theory
    [VXDash.kicad_pcb, VXDash.kicad_sch]
2026-03-04 Integrating DNP from Mini Build
    [Analogue.kicad_sch, VXDash.kicad_pcb, VXDash.kicad_sch, VXDash_MinBuild.kicad_pcb, VXDash_MinBuild.kicad_sch]
2026-03-04 Pre-insertion of 40106
    [Analogue.kicad_sch, VXDash.kicad_pcb, VXDash.kicad_sch, pulsed_sig_proc.kicad_sch]
2026-03-05 Pre-layout done
    [3V3_SMPS.kicad_sch, 5V_SMPS.kicad_sch, AnalogV_Divider.kicad_sch, Analogue.kicad_sch, Buzzer.kicad_sch, Opto_ActHi.kicad_sch, Opto_ActLo.kicad_sch, Power_Input.kicad_sch]
2026-03-06 OPT AIN3 as ref, filter caps adjusted
    [Analogue.kicad_sch, VXDash.kicad_pcb, pulsed_sig_proc.kicad_sch]
2026-03-08 LCSC references added
    [VXDash.kicad_pcb, pulsed_sig_proc.kicad_sch]
2026-03-09 Anti ringing resistors and co
    [Power_Input.kicad_sch, VXDash.kicad_pcb, VXDash.kicad_sch, pulsed_sig_proc.kicad_sch]
2026-07-22 Costing file updates
    [VXDash.kicad_pcb, pulsed_sig_proc.kicad_sch]
2026-07-27 AISLER MPN field
    Adding an AISLER MPN field for fast BOM setup with Aisler.
    [3V3_SMPS.kicad_sch, 5V_SMPS.kicad_sch, AnalogV_Divider.kicad_sch, Analogue.kicad_sch, Buzzer.kicad_sch, Opto_ActHi.kicad_sch, Opto_ActLo.kicad_sch, Power_Input.kicad_sch]
2026-08-12 DNP and BOM exclusion corrections
    [3V3_SMPS.kicad_sch, 5V_SMPS.kicad_sch, Power_Input.kicad_sch, VXDash.kicad_pcb]
2026-08-13 iBOM update before build
    [VXDash.kicad_pcb, VXDash.kicad_sch]
2026-08-14 DNP errors (R99)
    [Power_Input.kicad_sch, VXDash.kicad_pcb]
2026-09-25 Start of clean up and relocation work
    [Power_Input.kicad_sch, Telltale load emulation.kicad_sch, VXDash.kicad_pcb, VXDash.kicad_sch, pulsed_sig_proc.kicad_sch]
2026-11-07 Use project-relative library paths instead of VXDASH_LIB
    Replace the ${VXDASH_LIB} path variable, which only resolved through a
    per-machine KiCad setting, with ${KIPRJMOD}/../Lib in every board's
    sym/fp-lib-table, the shared footprints' 3D model paths, and the board
    files. Fresh clones now find the shared Lib/ without extra setup.
    Also includes pending main-board layout edits in VXDash.kicad_pcb.
2026-11-07 Stop tracking KiCad per-user state, backups and legacy stubs
    - Ignore *.kicad_prl, fp-info-cache, ~*.lck, *-backups/, *.bak and .akcli/
    at the repo root, and untrack the existing .kicad_prl and fp-info-cache
    files (local copies are kept).
    - Remove committed Lib/sym/*.bak files and the Emulator production backup
    zips.
    - Remove the empty legacy .sch stubs (72-byte EESchema v2 placeholders).
2026-11-07 VXDash: drop DIY dependency and normalise sourcing fields
    - J7 (USB-C) now uses VXDash_connectors:USB4105-GF-A and
    VXDash_connectors:GCT_USB4105-GF-A; its schematic cache is refreshed
    from the project library. Netlist unchanged (akcli diff), KiCad ERC
    unchanged.
    - Remove always-empty fields stamped on most symbols (Ippm/Vbr/Vwm on
    non-TVS parts, MANUFACTURER, MAXIMUM_PACKAGE_HEIGHT, PARTREV, STANDARD,
    Tolerance, Instructions/Notes) and the vendor-import fields
    (Manufacturer_Name/Part_Number folded into MFT/MFT_PN, Mouser/Arrow
    dropped). JLCPCB is kept for upcoming part numbers.
    - Project libraries: every symbol now carries MFT, MFT_PN, LCSC,
    LCSC alt, AISLER_MPN and JLCPCB; p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
2026-11-07 Remove orphan ESP32.kicad_sch sheets
    No sheet in the VXDash, Emulator or Emulator_lite hierarchies referenced
    them; they only held an unused stock RF_Module:ESP32-S3-WROOM-1.
2026-11-07 Remove Connectors, MinBuild and RemoteECU boards and FreeCAD assembly
    Sub-projects no longer relevant at this stage; history keeps them.
2026-11-07 Move VXDash_2.0-D.step into CAD files
2026-11-07 VXDash: switch optocouplers to DPC817, CAN pins bidirectional
    - U3-U18 now use the project VXDash_ICs:DPC817 symbol instead of stock
    Isolator:SFH617A-2X009T (same pinout and SMDIP-4_W9.53mm footprint;
    netlist unchanged).
    - DPC817 symbol: default reference "U", footprint filter SMDIP*W9.53mm*
    (matches the SL-4 package), keywords updated from the Diodes DS45855
    datasheet (5000 VRMS, BVCEO 35V, rank C CTR 200-400%).
    - ATA6561 CAN_H/CAN_L pins are bidirectional, clearing the CAN bus
    pin-to-pin ERC errors.
    - KiCad re-save: cache field order, zone refill/priorities, ERC
    exclusions for R149-R151 and RV1.
2026-11-07 VXDash: make LTV-817S-TA1-B the primary optocoupler
    Rename the project symbol VXDash_ICs:DPC817 to VXDash_ICs:LTV-817S and
    relink U3-U18. Lite-On LTV-817S-TA1-B (LCSC C109226) is now MFT_PN and
    AISLER_MPN; DPC817S-B-TR (C22454766) becomes the alternate, since the
    Diodes DPC817 series is marked not recommended for new designs. Same
    pinout and SMDIP-4_W9.53mm footprint; netlist unchanged, PCB values and
    fields updated to keep schematic parity.
2026-11-07 VXDash PCB: point 3D models at .step instead of removed .wrl
    KiCad 9 no longer ships VRML models; 66 footprints (resistors, SOD-123
    diodes, JST PH and pin headers, push buttons) still referenced .wrl and
    showed no 3D body. Same path with .step, same offsets.
    Also includes pending opto footprint-filter field updates
    (SMDIP*W9.53mm*).
2026-11-07 VXDash PCB: L2 uses Chilisin BWVS00505030 STEP as stand-in 3D model
    The stock NR-50xx STEP referenced by the Taiyo-Yuden footprint is not
    shipped with KiCad 9.
2026-11-07 VXDash: promote in-stock alternates, record PartsBox substitutes
    Per PartsBox stock (principal at 0):
    - C65-C67: Yageo CC0603KRX7R9BB102 (C100040) is now principal,
    Samsung CL10B102KB8NNNC (C1588) the alternate; leading spaces removed.
    - F1: Littelfuse 30R250UPR (C207101) is now principal (value updated),
    Bel 0ZRB0250FF1E (C3761262) the alternate.
    Substitutes confirmed in PartsBox, added as LCSC alt:
    - J7: USB4105-GF-A-120 (C5184243), also in the VXDash_connectors
    library symbol (cache refreshed).
    - RV1: Ruilon 07D220K (C15157).
    U20 ALT_MFT_PN_1 leading space removed. Schematic, PCB and library
    updated together; netlist unchanged, PCB schematic parity clean.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
2026-11-07 VXDash: add PartsBox substitutes as alternates, promote L2
    - 100n 0603 (28x): alternate CL10B104KB8NNNC (C1591).
    - IC4 AS2333: alternate TLV2333IDGKR (C527573), also in the
    VXDash_ICs library symbol (cache refreshed).
    - L2: Magnetsyc NR5040S3R3MT (C28642360) is now principal, Taiyo Yuden
    NRS5030T3R3MMGJ (C222937) the alternate (principal had 0 stock).
    Schematic, PCB and library updated together; PCB schematic parity clean,
    ERC unchanged. PartsBox cross-reference: 70 ok, U21 not in PartsBox.
2026-11-07 VXDash: fill JLCPCB Basic parts and add JLCPCB extended field
    JLCPCB holds a Basic part code where one matches the line's spec
    (same value and package, tolerance, power or voltage at least as good,
    same or better dielectric), taken from LCSC, LCSC alt or the JLCPCB
    Basic catalog. Lines without a Basic match get their LCSC code in a new
    "JLCPCB extended" field instead (LCSC alt when LCSC has no JLCPCB stock).
    MFT, MFT_PN and LCSC fields are unchanged.
2026-11-07 VXDash: add Recommended JLCPCB field
    Per BOM line, the cheapest JLCPCB code with enough stock for 5 boards,
    counting the 3 USD loading fee on Extended parts. Candidates are the
    JLCPCB (Basic), JLCPCB extended, LCSC and LCSC alt codes, plus
    spec-matched Preferred parts for 43k and 15R 0603. Other fields unchanged.
2026-11-11 Removing unused CAD
